liuyal/Akriveia/Documents/Design_Documents/02_UI_Appendix/README.md

# Document_UI_Appendix

Project to keep track of tasks and issues relating to User Interface and Appearance document

See grading rubric for document details

Due July 07, 2019

## To generate Reference

pdflatex 10_0_Appendix_UI_Design.tex

biber 10_0_Appendix_UI_Design

pdflatex 10_0_Appendix_UI_Design.tex
