liuyal/Akriveia/Documents/Design_Documents/06_Prototype_Refinement/03_engineering_standards.tex

\setcounter{section}{2}
\section{Engineering Standards}
\bigskip

The Akriveia Beacon will be designed and optimized to meet various engineering standards published by the IEEE, the IEC, the ISO, and the CSA Group to ensure performance and safety of the final product. The system contains electronics devices, software stack, and communication devices with different protocols, which must follow the specific safety standards. Ranging and data communication on the physical, data link, and network layer with the use of 2.4GHz WiFi and the ultra-wideband spectrum, operating in unlicensed frequency bands, and wireless standards that apply to the operation band must be followed. Furthermore, the Akriveia Beacon system is designed to operate during disaster situations, material, safety, and design must follow the structural and durability standards for disaster equipment. 

\bigskip
\bgroup
\def\arraystretch{1.3}
\begin{table}[H]
\centering
\begin{tabular}{ |p{2.5cm} p{11.5cm} | }
\hline
\multicolumn{1}{|r|}{IEEE 1625} & IEEE Standard for Rechargeable Batteries for Multi-Cell Mobile Computing Devices \\ 
\hline
\multicolumn{1}{|r|}{CSA-C22.2 NO.61508-1:17} & Functional safety of electrical/electronic/programmable electronic safety-related systems - Part 1: General requirements \\ 
\hline
\multicolumn{1}{|r|}{CSA-C22.2 NO.0.23-15} & General requirements for battery-powered appliances \\  
\hline
\multicolumn{1}{|r|}{CAN/CSA-C22.2 NO.0-10} & General requirements - Canadian electrical code, part II \\ 
\hline
\multicolumn{1}{|r|}{IEEE P360} & Standard for Wearable Consumer Electronic Devices - Overview and Architecture \\  
\hline
\multicolumn{1}{|r|}{IEEE 802.15.4q-2016} & IEEE Standard for Low-Rate Wireless Networks --Amendment 2: Ultra-Low Power Physical Layer\\ 
\hline
\multicolumn{1}{|r|}{ISO/IEC 26907:2009} & Information technology -- Telecommunications and information exchange between systems -- High-rate ultra-wideband PHY and MAC standard\\  
\hline
\multicolumn{1}{|r|}{ISO/IEC 24730-62:2013} & Information technology -- Real time locating systems (RTLS) -- Part 62: High rate pulse repetition frequency Ultra Wide Band (UWB) air interface\\  
\hline
\multicolumn{1}{|r|}{IEEE P802.15.4z} & Standard for Low-Rate Wireless Networks Amendment: Enhanced High Rate Pulse (HRP) and Low Rate Pulse (LRP) Ultra Wide-Band (UWB) Physical Layers (PHYs) and Associated Ranging Techniques\\  
\hline
\multicolumn{1}{|r|}{IEEE 12207-2017} & ISO/IEC/IEEE International Standard - Systems and software engineering -- Software life cycle processes \\
\hline 
\multicolumn{1}{|r|}{IEEE P2510} & Standard for Establishing Quality of Data Sensor Parameters in the Internet of Things Environment \\ 
\hline
\multicolumn{1}{|r|}{ISO 2382-9:1984} & Data processing -- Vocabulary -- Part 9: Data communication \\
\hline 
\multicolumn{1}{|r|}{IEEE 1221-1993} & IEEE Guide for Fire Hazard Assessment of Electrical Insulating Materials in Electrical Power Systems \\ 
\hline
\multicolumn{1}{|r|}{IEEE 848-2015} & IEEE Standard Procedure for the Determination of the Ampacity Derating Factor for Fire-Protected Cable Systems\\ 
\hline
\end{tabular}
\caption{Table of Standards}
\end{table}
