liuyal/Akriveia/Documents/Design_Documents/08_Break_Even_Analysis/05_appendix.tex

\setcounter{section}{4}
\section{Appendix A - Bill of Material}

\begin{figure}[H]
\centering
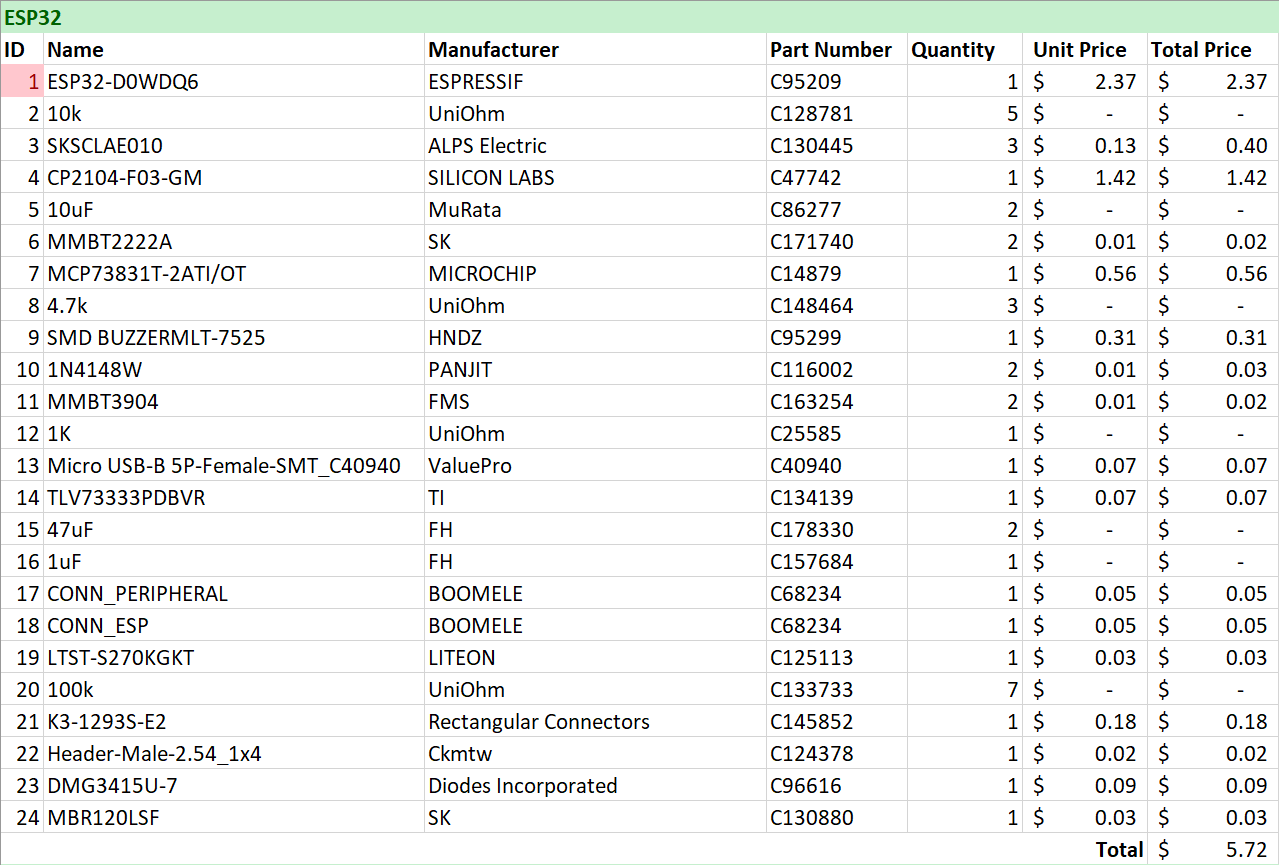
[picture p5: Documents/Design_Documents/08_Break_Even_Analysis/images/esp32.png]
    
    \caption{ESP32 Bill of Material}
\end{figure}

\medskip
\begin{figure}[H]
\centering
    
    \caption{DWM1000 UWB Module Bill of Material}
\end{figure}

\medskip
\begin{figure}[H]
\centering
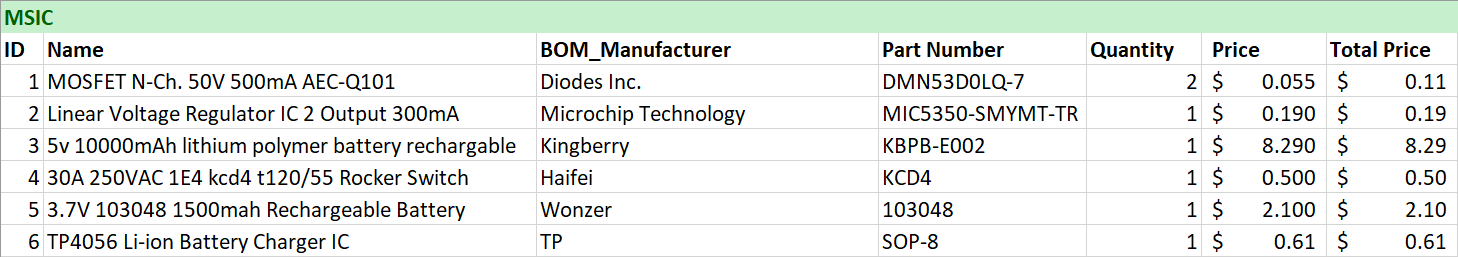
[picture p6: Documents/Design_Documents/08_Break_Even_Analysis/images/msic.PNG]
    
    \caption{Miscellaneous Component  Bill of Material}
\end{figure}

\begin{figure}[H]
\centering
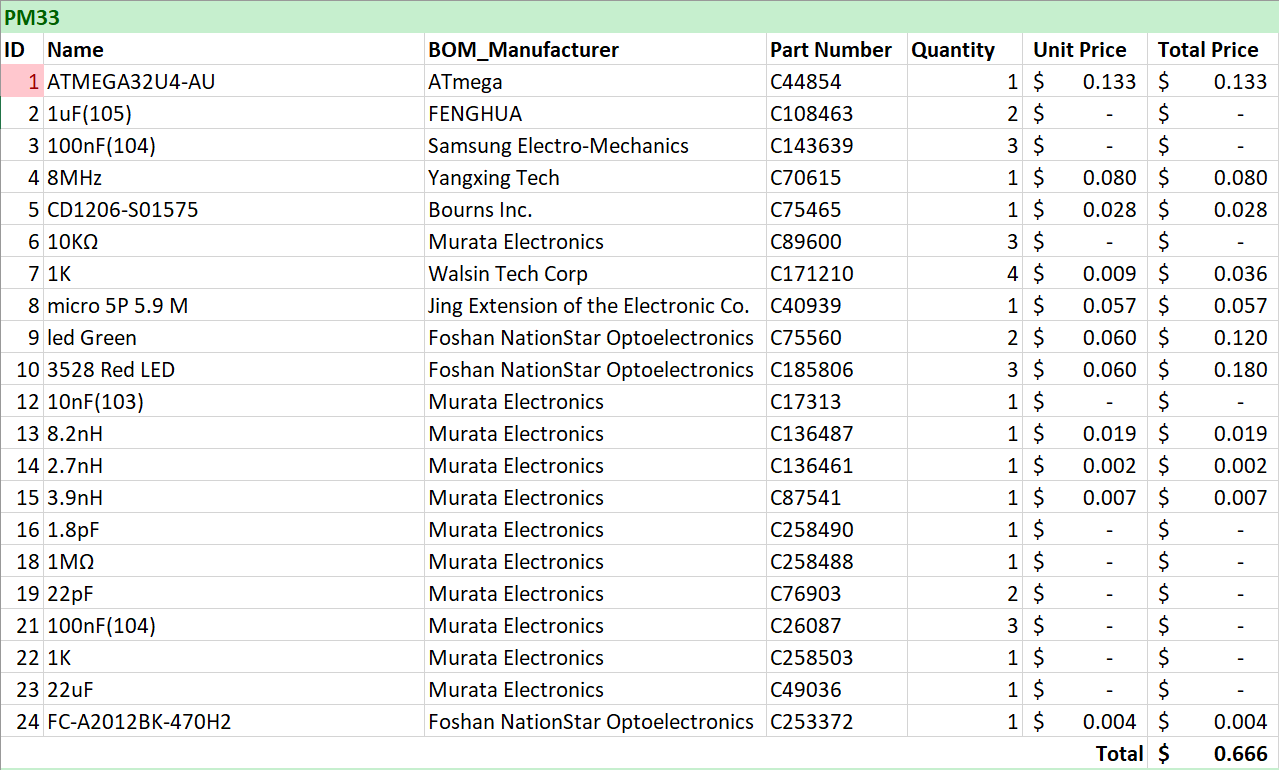
[picture p7: Documents/Design_Documents/08_Break_Even_Analysis/images/pm33.png]
    
    \caption{Arduino Pro Mini 3.3V 8MHz Bill of Material}
\end{figure}

\pagebreak
\setcounter{section}{5}
\section{Appendix B - Injection Molding Quotes}

\medskip
\bgroup
\def\arraystretch{1.75}
\begin{table}[H]
\centering
\begin{tabular}{ | m{5cm} | m{10cm} |}
\hline
\multicolumn{2}{|l|}{\textbf{3DHUBS - ABS}}  \\ 
\hline
\multicolumn{1}{|r|}{\textbf{Material}} & ABS \\
\hline
\multicolumn{1}{|r|}{\textbf{Beacon Tooling Cost [CAD]}} & \$6360.94 \\
\hline
\multicolumn{1}{|r|}{\textbf{Tag Tooling Cost [CAD]}} & \$4718.34 \\
\hline
\multicolumn{1}{|r|}{\textbf{Beacon Unit Price [CAD]}} & \$1.80 \\
\hline
\multicolumn{1}{|r|}{\textbf{Tag Unit Price [CAD]}} & \$0.73 \\
\hline
\end{tabular}
\caption{Injection Molding Quote - 3DHUBS (ABS)}
\end{table}

\bgroup
\def\arraystretch{1.75}
\begin{table}[H]
\centering
\begin{tabular}{ | m{5cm} | m{10cm} |}
\hline
\multicolumn{2}{|l|}{\textbf{3DHUBS - PEEK}}  \\ 
\hline
\multicolumn{1}{|r|}{\textbf{Material}} & PEEK \\
\hline
\multicolumn{1}{|r|}{\textbf{Beacon Tooling Cost [CAD]}} & \$10474.79 \\
\hline
\multicolumn{1}{|r|}{\textbf{Tag Tooling Cost [CAD]}} & \$5181.55 \\
\hline
\multicolumn{1}{|r|}{\textbf{Beacon Unit Price [CAD]}} & \$2.30 \\
\hline
\multicolumn{1}{|r|}{\textbf{Tag Unit Price [CAD]}} & \$1.25 \\
\hline
\end{tabular}
\caption{Injection Molding Quote - 3DHUBS (PEEK)}
\end{table}

\bgroup
\def\arraystretch{1.75}
\begin{table}[H]
\centering
\begin{tabular}{ | m{5cm} | m{10cm} |}
\hline
\multicolumn{2}{|l|}{\textbf{ICOMolds}}  \\ 
\hline
\multicolumn{1}{|r|}{\textbf{Material}} & ABS Chimei Pa-757, Natural \\
\hline
\multicolumn{1}{|r|}{\textbf{Beacon Tooling Cost [CAD]}} & \$6829.00 \\
\hline
\multicolumn{1}{|r|}{\textbf{Tag Tooling Cost [CAD]}} & \$4357.00 \\
\hline
\multicolumn{1}{|r|}{\textbf{Beacon Unit Price [CAD]}} & \$1.97 \\
\hline
\multicolumn{1}{|r|}{\textbf{Tag Unit Price [CAD]}} & \$0.59 \\
\hline
\end{tabular}
\caption{Injection Molding Quote - ICOMold (ABS)}
\end{table}

\pagebreak
\setcounter{section}{6}
\section{Appendix C - PCB Fabrication and Assembly Quotes}

\medskip
\bgroup
\def\arraystretch{1.5}
\begin{table}[H]
\centering
\begin{tabular}{ | m{6cm} | m{12cm} |}
\hline
\multicolumn{1}{|r|}{\textbf{Board Quantity}} & 1000 \\
\hline
\multicolumn{1}{|r|}{\textbf{Board Size}} & $5\times12$ cm \\
\hline
\multicolumn{1}{|r|}{\textbf{Thickness}} & 0.062 inch \\
\hline
\multicolumn{1}{|r|}{\textbf{Layers}} & 2 \\
\hline
\multicolumn{1}{|r|}{\textbf{Copper weight}} & 1.0 oz \\
\hline
\multicolumn{1}{|r|}{\textbf{Routing}} & Individual \\
\hline
\multicolumn{1}{|r|}{\textbf{Total Price [CAD]}} & \$1429.72 \\
\hline
\multicolumn{1}{|r|}{\textbf{Unit Price [CAD]}} & \$1.43 \\
\hline
\end{tabular}
\caption{Beacon PCB Fabrication Quote}
\end{table}

\bgroup
\def\arraystretch{1.5}
\begin{table}[H]
\centering
\begin{tabular}{ | m{6cm} | m{12cm} |}
\hline
\multicolumn{1}{|r|}{\textbf{Board Quantity}} & 1000 \\
\hline
\multicolumn{1}{|r|}{\textbf{Board Size}} & $4\times6$ cm \\
\hline
\multicolumn{1}{|r|}{\textbf{Thickness}} & 0.062 inch \\
\hline
\multicolumn{1}{|r|}{\textbf{Layers}} & 2 \\
\hline
\multicolumn{1}{|r|}{\textbf{Copper weight}} & 1.0 oz \\
\hline
\multicolumn{1}{|r|}{\textbf{Routing}} & Individual \\
\hline
\multicolumn{1}{|r|}{\textbf{Total Price [CAD]}} & \$768.39 \\
\hline
\multicolumn{1}{|r|}{\textbf{Unit Price [CAD]}} & \$0.77 \\
\hline
\end{tabular}
\caption{ID Tag PCB Fabrication Quote}
\end{table}

\bgroup
\def\arraystretch{1.5}
\begin{table}[H]
\centering
\begin{tabular}{ | m{6cm} | m{12cm} |}
\hline
\multicolumn{1}{|r|}{\textbf{Board Quantity}} & 1000 \\
\hline
\multicolumn{1}{|r|}{\textbf{BOM Lines}} & 51 \\
\hline
\multicolumn{1}{|r|}{\textbf{N-sided SMT}} & Single Side \\
\hline
\multicolumn{1}{|r|}{\textbf{Processing}} & Leaded \\
\hline
\multicolumn{1}{|r|}{\textbf{SMT Pads}} & 100 \\
\hline
\multicolumn{1}{|r|}{\textbf{Tru-Holes}} & 0 \\
\hline
\multicolumn{1}{|r|}{\textbf{Fine Pitch Parts}} & 10 \\
\hline
\multicolumn{1}{|r|}{\textbf{BGA/QFN Parts}} & 0 \\
\hline
\multicolumn{1}{|r|}{\textbf{Total Price [CAD]}} & \$3888.30 \\
\hline
\end{tabular}
\caption{Beacon PCB Assembly Quote}
\end{table}

\bgroup
\def\arraystretch{1.5}
\begin{table}[H]
\centering
\begin{tabular}{ | m{6cm} | m{12cm} |}
\hline
\multicolumn{1}{|r|}{\textbf{Board Quantity}} & 1000 \\
\hline
\multicolumn{1}{|r|}{\textbf{BOM Lines}} & 27 \\
\hline
\multicolumn{1}{|r|}{\textbf{N-sided SMT}} & Single Side \\
\hline
\multicolumn{1}{|r|}{\textbf{Processing}} & Leaded \\
\hline
\multicolumn{1}{|r|}{\textbf{SMT Pads}} & 60 \\
\hline
\multicolumn{1}{|r|}{\textbf{Tru-Holes}} & 0 \\
\hline
\multicolumn{1}{|r|}{\textbf{Fine Pitch Parts}} & 5 \\
\hline
\multicolumn{1}{|r|}{\textbf{BGA/QFN Parts}} & 0 \\
\hline
\multicolumn{1}{|r|}{\textbf{Total Price [CAD]}} & \$2693.32 \\
\hline
\end{tabular}
\caption{ID Tag PCB Assembly Quote}
\end{table}
