liuyal/Akriveia/Documents/Design_Documents/03_Project_Proposal/00_Glossary.tex

\newglossaryentry{BLE}{name=BLE, description={Bluetooth Low Energy}}
\newglossaryentry{CAD}{name=CAD, description={Computer Aided Design}}
\newglossaryentry{CSA}{name=CSA, description={Canadian Standards Association is a standards development organization}}
\newglossaryentry{DHCP}{name=DHCP, description={Dynamic Host Configuration Protocol}}
\newglossaryentry{DC}{name=DC, description={Direct current voltage}}
\newglossaryentry{DPU}{name=DPU, description={Data Processing Unit}}
\newglossaryentry{ESSS}{name=ESSS, description={SFU Engineering Science Student Society}}
\newglossaryentry{ETSI}{name=ETSI, description={European Telecommunications Standards Institute}}
\newglossaryentry{FCC}{name=FCC, description={Federal Communications Commission}}
\newglossaryentry{FM}{name=FM, description={Frequency modulation}}
\newglossaryentry{GIL}{name=GIL, description={Global Indoor Location }}
\newglossaryentry{GPS}{name=GPS, description={Global Position Systems }}
\newglossaryentry{GPIO}{name=GPIO, description={General Purpose Input Output}}
\newglossaryentry{GUI}{name=GUI, description={Graphical User Interface}}
\newglossaryentry{HTTP}{name=HTTP, description={HyperText Transfer Protocol}}
\newglossaryentry{IC}{name=IC, description={Integrated Circuit}}
\newglossaryentry{ID}{name=ID, description={Identification}}
\newglossaryentry{IEC}{name=IEC, description={International Electrotechnical Commission}}
\newglossaryentry{IEEE}{name=IEEE, description={Institute of Electrical and Electronics Engineers}}
\newglossaryentry{ISO}{name=ISO, description={the International Organization for Standardization. }}
\newglossaryentry{MAC}{name=MAC, description={Media Access Control}}
\newglossaryentry{MCU}{name=MCU, description={Micro-controller unit}}
\newglossaryentry{OS}{name=OS, description={operating system}}
\newglossaryentry{PCB}{name=PCB, description={Printed circuit board}}
\newglossaryentry{PoC}{name=PoC, description={Proof of concept is the sample product assembled to explore project feasibility}}
\newglossaryentry{PLA}{name=PLA, description={Polylactic acid or polylactide}}
\newglossaryentry{RF}{name=RF, description={Radio Frequency}}
\newglossaryentry{RSSI}{name=RSSI, description={Received Signal Strength Indicator}}
\newglossaryentry{SAR}{name=SAR, description={Search and Rescue}}
\newglossaryentry{SBC}{name=SBC, description={Single board computer}}
\newglossaryentry{ToF}{name=ToF, description={Time-of-Flight is a method for measuring the distance between a sensor and an object}}
\newglossaryentry{UDP}{name=UDP, description={User Datagram Protocol}}
\newglossaryentry{UI}{name=UI, description={User Interface}}
\newglossaryentry{UWB}{name=UWB, description={Ultra wide band}}
