liuyal/Akriveia/Documents/Design_Documents/03_Project_Proposal/04_Budget_and_funding.tex

\setcounter{section}{3}
\section{Budget \& Funding}
\bigskip

\subsection{Budget Estimation}
\medskip

For the Alpha phase of the project, the team plans to test a few transceivers from different manufacturers in order to find the most suitable transceivers for the final prototype. For the microcontroller unit, the ESP32 development board will be used to help test these transceivers with the system. In the following tables, expense that has already been put into the project, and the estimated costs for the remainder of the project are outlined. The expenses are divided into two tables, one containing the expenses already incurred up to the time of this writing, and the other contains a forecast of the expected costs to come.

\begin{table}[H]
\centering
\def\arraystretch{1.3}
\begin{tabular}{ | m{4.75cm} | m{5cm} | m{2.5cm} | m{3cm} |}
\hline
\textbf{Item} & \textbf{Purpose} & \textbf{Cost [CAD]} & \textbf{Project Phase}  \\
\hline
12 of: nrf24l01 2.4GHz RF Transceiver modules & Initial feasibility testing & \$17.99 & PoC \\
\hline
5 of: ESP32 development boards & PoC and prototype testing and development & \$82.15 & PoC, Prototype, Final \\
\hline
1 of: Raspberry Pi 3 B+ starter kit & Will act as the demo central data processing unit for prototype and final product & \$88.47 & Prototype, Final \\
\hline
5 of: Decawave DWM1000 UWB modules & RF transceiver for Prototype and final product & \$230.67 & Prototype, Final \\
\hline
12 of: DWM1000 PCB breakout boards & Allow for DWM1000 modules to be used with ESP32 in prototype and final product & \$18.29 & Prototype, Final \\
\hline
Raspberry Pi 3 B+ & Will act as the central data processing unit for prototype and final product & \$88.47 & Prototype, Final \\
\hline
SMD components and solder paste & Assembling the DWM1000 boards & \$63.45 & Prototype, Final\\
\hline
Arduino boards and components & Testing and development for Data processing unit and serial communication & \$107.87 & PoC \\
\hline
\end{tabular}
\caption{Expenses to Date}
\end{table}

\begin{table}[H]
\centering
\def\arraystretch{1.3}
\begin{tabular}{ | m{3.5cm} | m{6.25cm} | m{2.5cm} | m{3cm} |}
\hline
\textbf{Item} & \textbf{Purpose} & \textbf{Cost [CAD]} & \textbf{Project Phase}  \\
\hline
3D printing & Casing for beacons and ID tags & \$50.00 & Final  \\
\hline
Batteries & Power supplies for system components & \$30.00 & Prototype, Final \\
\hline
Circuit components & Beacon and ID tag components & \$20.00 & Final \\
\hline
PCB printing & Beacon and ID tag components & \$20.00 & Final \\
\hline
\end{tabular}
\caption{Forecast of Future Expenses}
\end{table}

\pagebreak
\subsection{Product Pricing}
\medskip
The Akriveia Beacon as a Final manufactured product will offer its customers 10 ID Tags with minimal 3 Beacons which additional beacons and ID tags available for purchase at unit and bulk price. The final system will have an estimated system component cost of around \$575. Along with an estimated labor and overhead cost the required final product sale price is estimated to be around \$930 with a 20\% return on sales (not including taxes).

\begin{table}[H]
\centering
\def\arraystretch{1.5}
\begin{tabular}{ | m{5cm} | m{5cm} | m{5cm} |}
\hline
\textbf{System Component} & \textbf{Part} & \textbf{Cost [CAD]}  \\
\hline
\multirow{5}{*}{ID TAG} & DWM1000 Module & \$30.00 \\  \cline{2-3}
  					    & Casing & \$2.00 \\  \cline{2-3}
  					    & Integrated ESP32 PCB & \$2.00 \\  \cline{2-3}
  					    & 2200 mAH Lithium Battery & \$5.00 \\  \cline{2-3}
  					    & PCB Components & \$2.00 \\ 
\hline
\multicolumn{2}{|r|}{\textbf{Total}:} & \$44.00 \\
\hline
\multirow{5}{*}{Beacon} & DWM1000 Module & \$30.00 \\  \cline{2-3}
  					    & Casing & \$3.00 \\  \cline{2-3}
  					    & Integrated ESP32 PCB & \$2.00 \\  \cline{2-3}
  					    & 2200 mAH Lithium Battery & \$5.00 \\  \cline{2-3}
  					    & PCB Components & \$2.00 \\ 
\hline
\multicolumn{2}{|r|}{\textbf{Total}:} & \$45.00 \\
\hline
Software & Deployment Cost & \$50.00 \\
\hline
\end{tabular}
\caption{Final Product Pricing Estimation}
\end{table}

\bigskip

\begin{table}[H]
\centering
\def\arraystretch{1.5}
\begin{tabular}{ m{10cm} m{2cm} }

Cost of materials &  \\
 + 10 $\times$ ID Tag & \$440.00  \\
 + 3 $\times$ Beacon & \$135.00  \\
 + Cost of labor &  \$100.00  \\
 + Overhead &  \$100.00  \\
\noalign{\global\arrayrulewidth=0.25mm} \arrayrulecolor{gray} \hline
 = Total cost &  \$775.00  \\
 + Desired profit (20\% on sales) &  \$155.00  \\
\noalign{\global\arrayrulewidth=0.25mm} \arrayrulecolor{gray} \hline
 = Required sale price &  \$930.00  \\
\end{tabular}

\end{table}

\pagebreak
\subsection{Prospective Funding Sources}
\medskip
\subsubsection{Engineering Science Student Endowment Fund}
\medskip
We hope to obtain funding from the SFU Engineering Science Student Society (\Gls{ESSS}) by means of the endowment fund set up by the society (ESSEF). We know that they have been very generous with Capstone groups in the past, so as soon as we are able to, we will be applying for funding from the ESSEF. We acknowledge that some parts purchased with the funding from this source may have to be donated to the ESSS for their parts library.

\subsubsection{Wighton Development Fund}
\medskip
The Wighton Development Fund is in place to support SFU student-led projects, awarded by Dr. Andrew Rawicz \cite{R4-1}, and a comitee consisting of other facuty or staff. We hope to obtain funding that will cover the remainder of the expenses endured during this project. As with the ESSEF, an application will be submitted by this group as soon as possible.

\subsubsection{Team Contributions}
\medskip
If the above funding sources are insufficient to cover the costs of this project, each team member will agree to personal contributions up to \$50 each to complete funding for the project and cover any remaining expenses.
