liuyal/Akriveia/Documents/Design_Documents/02_Design_Specification/00_Glossary.tex

\newglossaryentry{ARM64}{name=ARM64, description={Advanced RISC Machine, A family of RISC based processors}}
\newglossaryentry{Actix Web}{name=Actix Web, description={A webserver library built ontop of Actix}}
\newglossaryentry{Actix}{name=Actix, description={An implementation of the Actor Model in Rust}}
\newglossaryentry{Actor Model}{name=Actor Model, description={A concurrency managment paradigm that uses message passing between objects rather than locks or atomics}}
\newglossaryentry{Actor}{name=Actor, description={A class that contains message handling callbacks}}
\newglossaryentry{Aptitude}{name=Aptitude, description={A debian package manager that automatically manages updates and installation of software and dependencies}}
\newglossaryentry{Arbiter}{name=Arbitor, description={A thread pool, where each thread is an event loop}}
\newglossaryentry{Babel}{name=Babel, description={A scripting language similar to Javascript with the ability to directly construct HTML snippets}}
\newglossaryentry{BLE}{name=BLE, description={Bluetooth Low Energy}}
\newglossaryentry{Borrow Checker}{name=Borrow Checker, description={A component of the Rust compiler to prevent data races by enforcing data ownership rules}}
\newglossaryentry{CAD}{name=CAD, description={Computer Aided Design}}
\newglossaryentry{CSA}{name=CSA, description={Canadian Standards Association is a standards development organization}}
\newglossaryentry{DHCP}{name=DHCP, description={Dynamic Host Configuration Protocol}}
\newglossaryentry{DC}{name=DC, description={Direct current voltage}}
\newglossaryentry{DPU}{name=DPU, description={Data Processing Unit}}
\newglossaryentry{Debian}{name=Debian, description={A Linux based operating system}}
\newglossaryentry{ETSI}{name=ETSI, description={European Telecommunications Standards Institute}}
\newglossaryentry{FCC}{name=FCC, description={Federal Communications Commission}}
\newglossaryentry{FM}{name=FM, description={Frequency modulation}}
\newglossaryentry{Garbage Collector}{name=Garbage Collector, description={A runtime component of some programming languages that detects and cleans up unused memory.}}
\newglossaryentry{GPIO}{name=GPIO, description={General Purpose Input Output}}
\newglossaryentry{GUI}{name=GUI, description={Graphical User Interface}}
\newglossaryentry{Hostapd}{name=Hostapd, description={Host access point daemon}}
\newglossaryentry{HTTP}{name=HTTP, description={HyperText Transfer Protocol}}
\newglossaryentry{IC}{name=IC, description={Integrated Circuit}}
\newglossaryentry{ID}{name=ID, description={Identification}}
\newglossaryentry{IEC}{name=IEC, description={International Electrotechnical Commission}}
\newglossaryentry{IEEE}{name=IEEE, description={Institute of Electrical and Electronics Engineers}}
\newglossaryentry{ISO}{name=ISO, description={the International Organization for Standardization. }}
\newglossaryentry{JQuery}{name=JQuery, description={A Javascript library designed to manipulate HTML}}
\newglossaryentry{MAC}{name=MAC, description={Media Access Control}}
\newglossaryentry{MCU}{name=MCU, description={Micro-controller unit}}
\newglossaryentry{MPSC}{name=MPSC, description={Multiple Producer Single Consumer Queue}}
\newglossaryentry{MVC}{name=MVC, description={Model View Controller, a method of orgnanization for GUI implementations}}
\newglossaryentry{OS}{name=OS, description={operating system}}
\newglossaryentry{OSI}{name=OSI Model, description={Open Systems Interconnection model}}
\newglossaryentry{PCB}{name=PCB, description={Printed circuit board}}
\newglossaryentry{PoC}{name=PoC, description={Proof of concept is the sample product assembled to explore project feasibility}}
\newglossaryentry{PLA}{name=PLA, description={Polylactic acid or polylactide}}
\newglossaryentry{React}{name=React, description={A Javascript framework to dynamically generate HTML}}
\newglossaryentry{RF}{name=RF, description={Radio Frequency}}
\newglossaryentry{Rolling Releases}{name=Rolling Release, description={Frequent updates of software, without versions}}
\newglossaryentry{RSSI}{name=RSSI, description={Received Signal Strength Indicator}}
\newglossaryentry{Rust}{name=Rust, description={A systems language that focuses on reliability and performance}}
\newglossaryentry{SBC}{name=SBC, description={Single board computer}}
\newglossaryentry{Server Side Rendering}{name=Server Side Rendering, description={Creating HTML files on the server, which can then be directly consumed by the browser without modification to render a GUI}}
\newglossaryentry{ToF}{name=ToF, description={Time-of-Flight is a method for measuring the distance between a sensor and an object}}
\newglossaryentry{UDP}{name=UDP, description={User Datagram Protocol}}
\newglossaryentry{UI}{name=UI, description={User Interface}}
\newglossaryentry{UWB}{name=UWB, description={Ultra wide band}}
\newglossaryentry{x86-64}{name=x86-64, description={Intel designed CISC family of processors}}
