liuyal/Akriveia/Documents/Design_Documents/02_Design_Specification/01_Introduction.tex

\setcounter{section}{0}
\section{Introduction}
\bigskip

\subsection{Background}
Over the past couple of decades, urban centers around the world have faced substantial population growth. As a result, the number of large and complex structures in dense urban areas around the world is rapidly increasing. In Canada alone there are approximating 500,000 commercial buildings \cite{R1}. A large population combined with massively complex buildings in relatively dense areas leads to higher risk for damage and casualties in the event of a disaster. Due to increased urbanization and complexity of urban structures, search and rescue operations in indoor urban environments face various complications and uncertainties. According to Statistics Canada, an average of 135 fire related deaths occur with commercial structures each year from 2010 to 2014 \cite{R2}.

\bigskip
In current practices, first responders know little about the severity of the disaster until arriving on scene. Once responders are on scene, emergency management have to quickly evaluate the situation and take appropriate actions \cite{R3}. Assessments of the structure are conducted with readily available blueprints of buildings along with limited information of last known location of possible trapped victims, usually derived from witness reports. Situational data are created dynamically during this process and the actual rescue process heavily depends on the situational awareness of the first line of emergency response operators \cite{R4}.

\bigskip
An important issue that must be considered is how emergency first responders should be dispatched inside the building in the event of a disaster in order to minimize search and rescue time as well as to ensure their safety. In order to pinpoint locations of trapped victims quickly and accurately it is critical to have precise location data. Proper emergency planning and organization takes a substantial amount of time, and having additional quick and accurate information on the locations of trapped, incapacitated or immobile personnel would greatly improve first responders situational awareness; which would improve safety for first responders and possibly increases the victims chances of rescue and survival.

\bigskip
As such, the need for a distinct indoor positioning rescue system is crucial in getting fast and reliable information that allows first responders to be dispatched within the builds in the most optimal and efficient manner. The Akriveia Beacon by TRIWAVE SYSTEMS focuses on improving the locating and rescue process of personnel trapped in buildings during or after small scale disasters such as fires and low magnitude earthquakes. This is done through a system of Ultra Wide-Band (\Gls{UWB}) Beacons and \Gls{ID} tags, and data processing unit for accurate, near real-time pin point location of trapped personnel.

\bigskip
Ultra-Wideband radio modules are small radio transceivers using radio spectrum within the ultra-wide band to communicate with one another. Each ID tag uses a UWB transceiver module to communicate with the beacon system configured with similar UWB transceivers. Given the time between sending and receiving transmission data, the distance can be estimated via \Gls{RSSI} or time of flight. The Beacons will then forward these distance estimations to a data processing unit using a closed WiFi network, where it can use trilateration methods to calculate the near real time location of each individual ID tag. The system design allows for multiple ID tags as well as more than three anchor beacons to provide more accuracy through redundancy, making it modular, extendible and reliable.

\break
\subsection{Scope}
\medskip
The Akriveia Beacon system is developed through three different phases of development as shown in Figure \ref{dev}. The three different phases includes: the proof-of-concept phase, prototype phase, and final product phase. A high-level design of the system hardware and software is presented in this document to demonstrate the overall system architecture and functionality of the Akriveia beacon product. The design section of this document is divided into four main sections, overall system design, hardware design, electrical design, and software design. These design specification will indicate the components, implementations, requirements, and constraints that must be met and satisfied within the project time frame. 

\medskip
\begin{figure}[H]
\centering
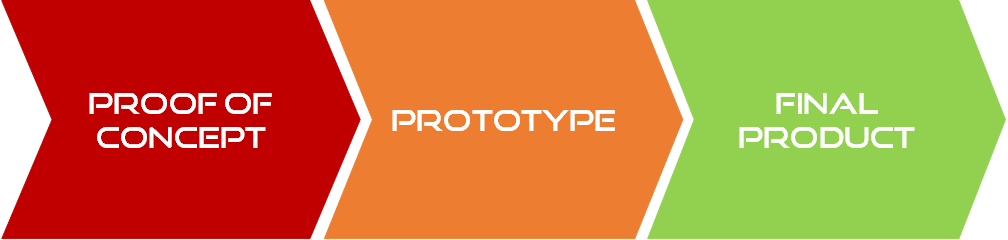
[picture p15: Documents/Design_Documents/02_Design_Specification/images/dev-path.png]
    
    \caption{Development Cycle}
    \label{dev}
\end{figure}

\subsection{Intended Audience}
\medskip
This document is presented by engineers at TRIWAVE SYSTEMS as a guide for the design and system overview of the Akriveia Beacon product. The intended audience of this document includes but not limited to, potential clients and/or partners, the supervising professors Dr. Craig Scratchley and Dr. Andrew Rawicz, associated teaching assistants and fellow TRIWAVE SYSTEMS members. The hardware and software engineers of the project can reference this document during the various stages of development and testing stages of the project for clarification. Near the completion of the prototype development phase the product will be tested against the cases specified in the test plan. Engineers responsible for performing quality assurance can refer to the Appendix of this document to ensure all safety concerns have been addressed and that the product fulfils all requirements and meets all expectations for proper usage. 

\break
\subsection{Design  Classification}
For consistency purposes, the following design classification code convention is used to describe and organize design requirements listed throughout this document. 
\medskip
\begin{center}
	\textbf{[ DES.SE.\# - X ]} 
\end{center}

\bgroup
\def\arraystretch{1.5}
\begin{table}[H]
\centering
\begin{tabular}{ | m{1cm} | m{13cm}| } 
\hline
\rowcolor{lightgray} \textbf{Code} & \textbf{Definition} \\ 
\hline
 \textbf{DES} & Design abbreviation. \\ 
\hline
 \textbf{SE} & Design Domain Abbreviation Code correspond with each Design requirements. (see Table 2)\\   
\hline
 \textbf{\#} & Design number ID \\ 
\hline
 \textbf{X} & Development Stage Encoding (see Table 3)\\ 
\hline
\end{tabular}
\caption{Design Requirement Encoding}
\end{table}

\bgroup
\def\arraystretch{1.5}
\begin{table}[H]
\centering
\begin{tabular}{ | m{7cm} | m{7cm}| } 
\hline
\rowcolor{lightgray} \textbf{Requirement Domain} & \textbf{Abbreviation Code} \\ 
\hline
 System & SY\\ 
\hline
 Hardware & HW\\ 
\hline
 Electrical & EC\\  
\hline
 Software & SW\\ 
\hline
\end{tabular}
\caption{Design  Domain Abbreviation Code}
\end{table}

\bgroup
\def\arraystretch{1.5}
\begin{table}[H]
\centering
\begin{tabular}{ | m{7cm} | m{7cm}| }
\hline
\rowcolor{lightgray} \textbf{Development Stage} & \textbf{Encoding} \\
\hline
Proof of Concept & C\\
\hline
Prototype & P\\
\hline
Final Product & F\\
\hline
\end{tabular}
\caption{Development Stage Encoding}
\end{table}
