liuyal/Akriveia/Documents/Design_Documents/02_Design_Specification/06_Software_Design.tex

\setcounter{section}{5}
\section{Software Design}
\bigskip

% NOTE: future work would be to build a system to flash new beacons with firmware for the credentials to communicate with the system.
% NOTE: assume beacons have line of sight to eachother. this allows us to make the callibration phase easier by manually measuring the distance between beacons rather than creating a callibration script.

% discuss the system at a high level, but leave details to subsections
% breifly reintroduce important topics that the user will need to be reminded of
\subsection{Software Overview}
\medskip
The Akriveia system is comprised of 3 different devices, namely: the data processor, beacons, and ID tags; this device diversity plays a large role in the software choice for the beacons and ID tags.
The Akriveia data processor is the primary access point for Administrators and First Responders, of whom will be presented a Graphical User Interface served by the data processor in addition to handling commands from the client.
The software on the Data Processing Unit(DPU) is written entirely in Rust, including the static client side webpage.
The requirements for each device are different, however the ID tags and beacons are able to share a similar environment; as such the Akriveia Beacon System will require two different software environments, one for the DPU and one for the ID tags and beacons.

\medskip
% language choices, formatting, standards, libraries
\subsection{Software Stack}
\medskip
Akrivia Beacon is composed of two primary languages, the DPU is implemented entirely in Rust while the beacons and ID tags use the Arduino language.

\medskip
\subsubsection{Software Environments}
\medskip
The data processing unit requires an operating system (\Gls{OS}) to perform CPU scheduling for the multi-threaded application, WiFi drivers, and a proper file system to handle a database.
As such, Linux or more specifically the \Gls{Debian} distribution of Linux was chosen as the DPU operating system.

\bigskip
Debian is widely praised for its stability, which makes it ideal for a data processing as the Akriveia Beacon System is designed to operate under emergency situations. Debian brings in the \Gls{Aptitude} package manager for dependency management, which allows for quick installation of required driver updates, operating system updates, and any additional packages required.
Debian's Aptitude has the advantage compared to other package managers because it removes the need to worry about dependencies, manual installation, and even installation of sub dependencies.
As Debian is a Linux distribution, it has widespread hardware adoption across many different hardware architectures - primarily \Gls{x86-64} and \Gls{ARM64} - giving Akriveia the flexibility to run on the most basic single board computers.

\bigskip
Linux has many different flavors, such as the Arch Linux which uses a different package management paradigm called \Gls{Rolling Releases}, favouring earlier adoption of newer packages to more quickly introduce features at the cost of stability.
\Gls{Rolling Releases} are unsuitable for production servers due to their instability.
Another alternative to Debian is Windows, however Windows suffers from high power usage, poor package management, and heavy reliance on proprietary software, whereas Linux is open source, free of cost, and has a more inclusive licence.

\pagebreak
\subsubsection{Software Languages}
\medskip
The DPU is written in \Gls{Rust}.
Rust is a relatively new language as it was created in 2006 \cite{rust_graydon_interview} and its first stable version was released in 2015 \cite{rust_releases}.
Taking inspiration from C++ and Haskell in its design, Rust is a systems language designed for stability and robustness. Rust eliminates entire classes of errors using the borrow checking system, a feature unique to this language.
The borrow checking system defines a strict set of rules to follow, and fails to compile if these rules are broken - even if the application is otherwise logically and syntactically correct.
As a systems language, Rust is compiled to binary rather than executed as a script through an interpreter, however, this does not stop it from being a higher order language.
Rust does not expect developers to manage allocation and deallocation of memory directly, nor does it have a runtime \Gls{Garbage Collector}; rust relies on the \Gls{Borrow Checker} and lifetime system at compile time to statically analyze memory usage and automatically places the allocations and deallocations as needed. The benefits of the \Gls{Borrow Checker} do come at a cost, resulting in slow compile time and high learning curve. The features of Rust will be used throughout the DPU, as the backend webserver, the data processor, as well as the on the browser in the form of webassembly. 

\bigskip
The beacons and ID tags are written in Arduino language.
The Arduino language is merely a set of C/C++ functions and is specifically designed for embedded programming, allowing use of higher level features when desired while also giving the developer absolute control over how memory is managed.
The Arduino environment performs a few transformations to the Arduino sketch before passing it to the avr-gcc compiler.
On Arduinos, memory is very limited so control is key to fit the program within the small space constraints.

\medskip
\subsubsection{Software Standards}
% TODO references here
\medskip
Rust code will follow the the Rustfmt standard of source layouts, Rustfmt is a tool provided by the Rust project that automatically formats all source in the standard format.
The Rust compiler also provides a few warnings for common formatting issues builtin, which will be heeded.
Arduino language will follow the ISO C/C++ programming standards \cite{cpp_core_guidelines}.
The Arduino style guide \cite{arduino_style_guide} presented are more ad hoc than a full style guide.

% introduce major libraries that largely dictate how we implement the system.
\medskip
\subsubsection{Frameworks}
\medskip
Akriveia Beacons' main DPU framework is called \Gls{Actix}.
Actix is an \Gls{Actor} Framework that follows the \Gls{Actor Model} paradigm of multi-threaded workloads.
The Actor Model operates on objects called actors to orchestrate concurrent computations, it does this by treating actors as separate entities that execute on an event loop on one or more threads, where the event loop simply looks at a list of events generated by actors and executes each event in order as long as it is not blocked by other events.
Events are generated when actors pass messages to each other, in response the actor that receives the message can modify its local state, create other actors, send messages to other actors, execute arbitrary logic, and finally send a response to the message.
This programming paradigm prevents the need for locks (and by extension, deadlocks) because the message passing mechanism alleviates the need to manually manage concurrency, opting to use the abstractions instead. 

\bigskip
Actix was chosen primarily to give the flexibility of multi-threading without incurring the typical thought process overhead associated with multi-threading.
Additionally, as a framework rather than a library, Actix serves as the basis to make REST webservers through the package \Gls{Actix Web}, which is further discussed under the sections \ref{software_libraries} and \ref{webserver_section}.

\pagebreak
% discuss which libraries we are using, and how they will be used by us
\subsubsection{Libraries}
\label{software_libraries}
\medskip
The Akriveia Beacon system will contain the following libraries.
\medskip
\begin{table}[H]
\centering
\begin{tabular}{ | m{3.25cm} | m{12.5cm} |}
	\hline
	\textbf{Actix Web} & The Actix Web library is a crate that extends the functionality of the Actix framework to create \Gls{HTTP} webservers. \\
	\hline
	\textbf{Yew} & Yew is a crate that extends Rusts ability to compile to Web Assembly by adding the ability to dynamically generate html on the client in response to user events and DPU responses. \\
	\hline
	\textbf{Serial Port} & Enables serial communication over USB between the DPU and beacons.\\
	\hline
	\textbf{Rust Standard Libraries} & This is the standard Rust runtime library, and contains many useful boilerplate functions and generic types. This library is included with the basic installation of Rustc. \\
	\hline
\end{tabular}
\caption{Akriveia Beacon Dependencies - Rust}
\end{table}

\begin{table}[H]
\centering
\begin{tabular}{ | m{3.25cm} | m{12.5cm} |}
	\hline
	\textbf{Arduino} & The standard set of Arduino libraries based off of the standard C library tailored specifically for Atmel Atmega AVR  microcontroller chips. \\
	\hline
	\textbf{ESP32 WiFi} &  Arduino core for ESP32 WiFi/BLE chip\\
	\hline
	\textbf{DWM1000} & A library that offers basic functionality to use Decawave's DW1000 chips/modules with Arduino \\
	\hline
\end{tabular}
\caption{Akriveia Beacon Dependencies - Arduino}
\end{table}

\bigskip
% discuss the model view controller paradigm, and its benefits
\subsection{Model-View-Controller}
% TODO glossary of mvc
\medskip
The model-view-controller (MVC) paradigm is a common method of separating concerns between modules.
It is an architectural pattern that separates concerns in a general way, allowing for code reuse and improving parallel development, it is also a common practice which allows others familiar with the paradigm to ramp up quickly on new projects.
Unsurprisingly, the MVC is split into three components, the model, controller and view.
The model describes data, data manipulation, as well as data storage.
The view describes how to view the model.
The controller acts as the means to communicate between the view and model based on data inputs, and is also capable of higher order operations such as between multiple models.

\bigskip
As the Actix Web library is less mature than frameworks in other languages such as Python's Django or Ruby's Rails, the DPU implementation will contain larger portion of boilerplate when compared to those other libraries.
This allows for greater flexibility in implementation, at the cost of marginally higher development time.
A benefit to writing a more tailored implementation, is that MVC and frameworks that closely follow MVC do not have a good answer for organizing functionality that falls outside of the architectures coverage such as background tasks.
Akriveia is required to maintain communication with many beacons and perform calculations asynchronously from web requests, which is the perfect use case for the actor framework which fills the void of the model-view-controller.

\bigskip
% discuss how we plan to multithread the data processor. go into slightly more detail about actix actors, and why this
% is necessary
\pagebreak
\subsection{Threading Model}
\medskip
The purpose of multi-threading the DPU is to make use of the hardware provided, since all modern server and desktop processors have at least two dedicated hardware cores.
Additionally, it is important for the DPU to have realtime responsiveness on the webserver, requiring that large computations such as trilateration for many beacons must be offloaded to other threads, keeping responsiveness high since the webserver thread is not blocked on computation while a request comes in.
An additional consideration specifically for the proof of concept which uses blocking serial communication to communicate to the beacons, meaning that each beacon requires a dedicated thread to communicate with the DPU.

\bigskip
Rust and Actix make multi-threaded development easier by using message passing for inter-thread communication, at the cost of performance when compared to traditional mutexes and atomics.
The implementation of message passing is a thread safe queue using mutexes and atomics to ensure data integrity, where multiple threads are able to send commands to another thread, which receive the message without blocking either thread.
To further discuss the Actix threading model, some definitions are required:
\begin{enumerate}
	\item Actor: A class that contains message handler callbacks.
	\item Arbitor: A thread pool, where each thread in the pool is an event loop.
\end{enumerate}
Once instantiated, the \Gls{Arbiter} spawns as many threads as indicated by its constructor and waits for actors to be spawned within the thread pool.
By default, the number of threads in the pool is the number of cores on the CPU.
The \Gls{Arbiter} is an environment for actors to execute, and as actors are spawned into the thread pool, they can send messages to other actors, or create other actors in response to external events such as from the file system or HTTP requests.
As shown in Figure~\ref{actix_thread_model}, the arbitor manages its own threads, which are all spawned at startup rather than on demand.
Within each thread, the arbitor executes the event loop, which polls its queue, and acts on any messages in the queue by delegating the task to the actor the message is bound to.
To pass a message to another actor, the sender must have the address of the recipient so that the arbitor can determine the destination, rather than a broadcasting system; this is shown in Figure~\ref{actix_messages}.

\bigskip
The beacons and ID tags do not have a full operating system, so they can only rely on single threaded interrupt handling to "multitask".
Interrupt handling does not provide full concurrency, instead it time slices the single core to provide the illusion of multitasking.
The basics of Interrupt handling is that it calls a function as a result of an event such as an external device raising a bit high on the CPU, or when a timer goes off.
In the Proof concept, the bluetooth library uses this functionality to handle connections.
When transitioning to WiFi and UWB, similar functionality will be implemented in each respective technology's library.

\pagebreak
\begin{figure}[H]
	\centering
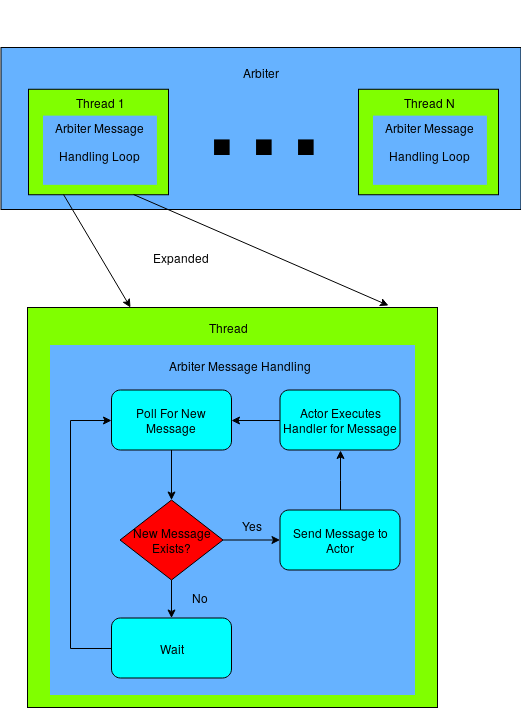
[picture p27: Documents/Design_Documents/02_Design_Specification/images/actix_thread_model.png]
    
    \caption{Actix Thread Model}
    \label{actix_thread_model}
\end{figure}

\bigskip
\begin{figure}[H]
	\centering
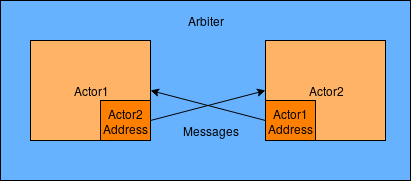
[picture p28: Documents/Design_Documents/02_Design_Specification/images/actix_message_passing.png]
    
    \caption{Actix Message Passing}
    \label{actix_messages}
\end{figure}
\pagebreak

% discuss the data processor subsystems in detail
\subsection{Data Processor Software Architecture}
\medskip
In the proof of concept, the DPU creates an HTTP server actor and a beacon manager actor.
The HTTP server waits on web requests, delegating tasks to the beacon manager and polling it for the necessary information.
On startup, the beacon manager queries the number of serial arduino devices, spawning a thread for each device.
Each thread spawned by the beacon manager represents a serial connection to a beacon.
The beacon manager sends messages using a traditional Multiple Producer Single Consumer Message Queue (\Gls{MPSC}) defined in the Rust standard library, while each serial communcation thread returns messages back to the manager through the actix message passing system.
Figure~\ref{software_poc_arch} gives a graphical representation of the previous description.
Actix uses MPSC internally for its message passing system.

\bigskip
The prototype and final versions bring in major changes to the software design.
As shown in figure~\ref{software_final_arch}, a major change is the removal of the serial connection actor which is replaced with the UDP actor.
The beacon manager remains, but instead controls the UDP actor rather than the serial connections.
An additional role of the beacon manager is to delegate computation of trilateration to the trilateration processor actor, which will save data in memory until there are at least 3 data points for a single ID tag to determine its position.
The trilateration processor makes the positional calculation and saves new position to disk via the ID tag model, which abstracts the database query.
The beacon and map models perform a similar role, abstracting their associated database queries into a single location following \Gls{MVC}.
Controllers mainly handle the model they were paired with, however the ID tag controller will also query the trilateration processor for real-time positional data and the beacon controller commands beacons indirectly through the beacon manager.

\bigskip
By design, the DPU is a client-server architecture, where the DPU is the server for a browser based client.
The client-server architecture lends itself to be very flexible and is a very heavily used model for both consumer systems and emergency response systems alike.
Once the backend starts executing, any computer able to access the IP of the DPU will have access to the system assuming the network is configured in such a way to allow this, and that the user has the correct credentials.
Conversely with no additional development work the same DPU when hooked up to a monitor can act like a client based application by simply accessing localhost on a browser.
Variations and alternatives to the client server-architecture were considered, but did not meet the needs of the Akriveia Beacon System, below are some of the choices considered and why they do not fit the role.

\bigskip
An electron application that utilizes browser technologies merges the backend and frontend together, behaving like a client based application, which will reduce deployment flexibility because a monitor connected directly to the DPU will be the only access point to the GUI, however the display will potentially need to be accessed by multiple users at a time, and will introduce high coupling between the frontend display and backend computation.
Electron applications are also highly single threaded, meaning that they will have higher difficulty in utilizing all cores on the CPU, wasting money on hardware that could otherwise be used.
Electron applications are also fixed to using a single language, Javascript, for both processing and display, whereas a webserver fixes the GUI implementation to Javascript however leaves the backend to a much broader range of languages where processing performance is more critical.

\pagebreak
Compared to a GUI implemented using graphics driver interfaces such as OpenGL, Vulkan, DirectX, or any higher level libraries that provide interfaces to graphics drivers, a GUI implemented in HTML and Javascript will take much less time to implement because both Javascript and HTML abstract away memory concerns such as pointers, and will never have memory related runtime errors, as guaranteed by the browser.
Browsers have widespread adoption, in every GUI based operating system at least one browser is installed by default, making them widespread and widely used.
Due to widespread adoption, browsers provide the flexibility to display the GUI either on the computer hosting the server itself, or just as easily the GUI can be accessed through another computer at the customers discretion.

\bigskip
\begin{figure}[H]
	\centering
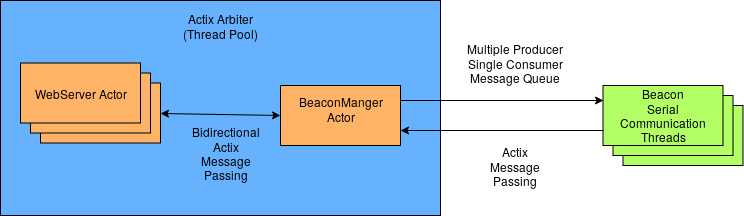
[picture p29: Documents/Design_Documents/02_Design_Specification/images/poc_arch.png]
    
    \caption{Proof of Concept Software Architecture}
    \label{software_poc_arch}
\end{figure}

\bigskip
\begin{figure}[H]
	\centering
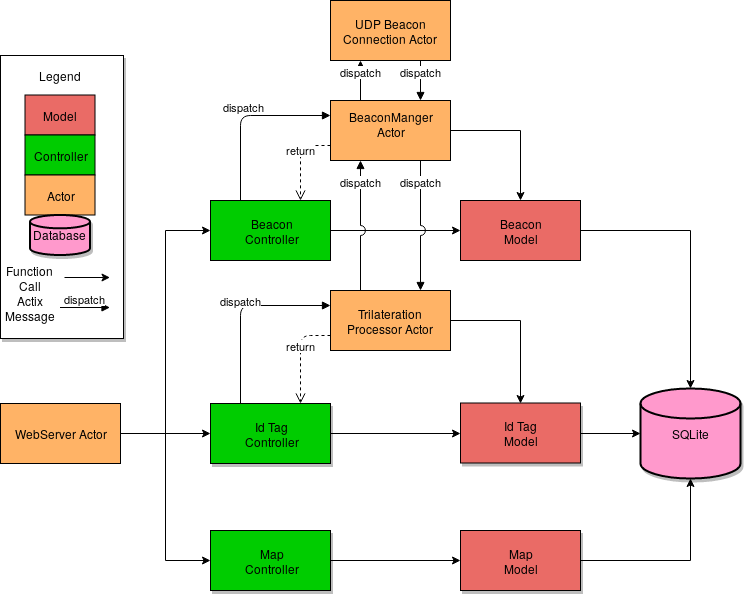
[picture p30: Documents/Design_Documents/02_Design_Specification/images/prototype_software_arch.png]
    
    \caption{Final Software Architecture}
    \label{software_final_arch}
\end{figure}

\bigskip
% discus the purpose of the webserver, and how it will be used to control the other subsystems dictated by user command.
\subsubsection{Webserver Subsystem}
\label{webserver_section}
\medskip
The purpose of the Webserver Subsystem is to bridge the GUI and backend by providing a data transfer interface in the form of HTTP REST calls.
A Webserver architecture is chosen because of its simplicity to implement, widespread adoption, and flexibility.
The view is discussed further in Section~\ref{view_section}: View.

\bigskip
The Webserver Subsystem will be designed to serve data to a browser, including the the HTML and Javascript files (GUI files) that are displayed by the browser.
Once the browser has the GUI files, it will make additional requests to the backend to keep updated information displayed on the GUI.
The Webserver Subsystem will only allow logged in users to access sensitive data, and only if they have the correct access rights.
Electron applications and traditional rendering APIs were also considered, however they each have trade-offs that do not fit with the design requirements of Akrievia.

\bigskip
A direct alternative to Actix Web is a web framework called Rocket.
Rocket behaves more like a traditional web server: supporting \Gls{Server Side Rendering} and json parsing out of the box.
This functionality comes at a cost in multiple ways, first rocket is primarily single threaded, second Rocket adds new features at the cost of reducing flexibility, and third rocket does not directly support the Actix Actor system, leaving all non-webserver code up to the developer to implement on their own.
In comparison, Actix Web does support and extend the Actor system which makes for a more integrated and unified codebase, and by using the Actor system within the webserver, multithreadability is easily added as needed on a per endpoint basis.
Rocket's additional out-of-the-box features are really just Rust crates in disguise, and so by using Cargo(Rusts package manager for crates) the same functonality can be quickly implemented within an Actix webserver at very little additional time cost.

\medskip
\subsubsection{Beacon Manager Subsystem}
\medskip
The role of the beacon manager is to commands to and from the individual beacon connections, and to give an abstraction for external systems that need not concern themselves with communication details, or how many beacons there actually are.
The Beacon Manager is a singleton, which means there is only one of them in the entire system, and has implications on the design of the rest of the system.
The most notable design influence is that the beacon manager can quickly become a bottleneck if it performs too much processing directly, and so to prevent this the beacon manager offloads as much work as it can to other subsystems.

\medskip
\subsubsection{Serial Beacon Communication Subsystem}
\medskip
In the proof of concept design, this actor deals with blocking serial communication with dedicated threads to keep the connection alive and to prevent web requests from blocking.
This subsystem will remain as bare bones as possible, because it only serves the purpose of quickly creating a working system and will be discarded in future iterations of the DPU.

\pagebreak
\subsubsection{Trilateration Processing Subsystem}
\medskip
In the final design, the trilateration processing subsystem takes in time of flight data messages from the beacon manager.
The trilateration processor waits until it receives enough data points, and once it has 3 data points from 3 different beacons for one id tag it can perform a location calculation.
While waiting for a full set of data, the incomplete set of data will be stored in a hash table where the mac address of each ID tag is the key and the contents are the array of data points.
Once the array of data points hits the threshold size of 3 from adding a new data point, the processor can perform the trilateration calculation.
The trilateration calculation can then be used to update the database entry for the corresponding ID tag by the processor.

\bigskip
To avoid going to the database for real-time updates of the ID tag locations, the ID tag controller will directly query the Trilateration Processor for the most up to date location information, reducing latency. The existence of the Trilateration Processing subsystem is necessary, because the beacon manager will quickly become a bottleneck due to the fact that it is a singleton in a multithreaded system.
As such, the manager should do as little direct processing and blocking operations itself and instead favour offloading the tasks to other subsystems.

\medskip
\subsubsection{UDP Beacon Communication Subsystem}
\medskip
In the final design, the UDP Beacon Communication Subsystem actor will communicate with the beacons over the UDP networking protocol.
UDP was chosen because it has less overhead than TCP, and is more suited for real-time applications such as Akriveia.

\medskip
% discuss database choice - sqlite and why. lead into models
\subsection{Database}
\medskip
Akrievia Beacon System requires a database to persist map, beacon, and user information.
In the time constraints of Capstone, the database will be a central location for data.
Ideally a production system would support replication of the database to another location, but this is out of scope for the purposes of this project.
SQLite was chosen primarily because of its simplicity to set up and minimal footprint.
Most commonly used in phones and packaged alongside python, SQLite has a stable file format and large userbase, and because of this has built a reputation for not failing.

\bigskip
SQLite is open source, and because of this issues can directly be brought up to the developers along with help from a large amount of experience from the internet due to the large userbase.
Open source projects are also freely available to browse to learn directly from the codebase when necessary.
In Akriveia, the database is accessed through model objects to keep concerns local to a single set of similarly structured files, and to keep re-usability up in the codebase.

\medskip
% discuss how we plan to represent data in the database, tie back to model-view-controller(specifically models, which
% will implement all of the database queries for the controllers to use.
\subsection{Models}
\medskip
Models are used to group database queries and model operations into a single file for each model, increasing reusability of the system.
Akrievia is expected to maintain three different types of models: maps, ID tags, and beacons. The following tables \ref{user_model}, \ref{beacon_model}, and \ref{map_model} show expected data entries and their type for each model, along with the purpose of each entry.

\begin{table}[H]
\centering
\def\arraystretch{1.4}
\begin{tabular}{| m{3cm} | m{3cm} | m{9.5cm} |}
	\hline
	\multicolumn{3}{|c|}{User Model} \\
	\hline
	Data Name & Type & Explanation \\
	\hline
	User Type & String & Indicates the type of user, either admin, employee, emergency contact, or first responder. \\
	\hline
	Employee Id & String & Employee ID for each user, for internal housekeeping of the company that purchases Akriveia Beacon. \\
	\hline
	Full Name & String & Human readable name to identify the user on lists. \\
	\hline
	Phone Number & String & Phone number to contact the user. \\
	\hline
	Emergency Contact & ref:User & Reference to another user as emergency contact. Emergency contacts will not have an employee id or tag id. \\
	\hline
	Notes & String & Notes about the user, i.e. allergies or disabilities, etc. \\
	\hline
	Id Tag Number & 64 bit Integer & table key, unique, id for each user. \\
	\hline
	Coordinates & 2D Vector & Last known location of the user within the map. \\
	\hline
	Last Seen Timestamps & Unix Timestamps & To identify the ID tag data is stale. Used to determine if the employee is at work while the disaster occurs. \\
	\hline
	Map ID & ref:Map & Last known map the user was located at. \\
	\hline
\end{tabular}
\caption{User Model}
\label{user_model}
\end{table}

\begin{table}[H]
\centering
\def\arraystretch{1.4}
\begin{tabular}{ | m{3cm} | m{3cm} | m{9.5cm} |}
	\hline
	\multicolumn{3}{|c|}{Beacon Model} \\
		\hline
	Data Name & Type & Explanation \\
	\hline
	MAV address & String & unique device identifier for beacon, table key.\\
	\hline
	Name & String & Human readable String for the device. \\
	\hline
	Map ID & ref:Map & Reference to a floor/map - this is really just the floor number. Shows the many-to-one relationship between beacons and floors. \\
	\hline
	Notes & String & Additional Beacon information (i.e. floor and location). \\
	\hline
\end{tabular}
\caption{Beacon Model}
\label{beacon_model}
\end{table}

\begin{table}[H]
\centering
\def\arraystretch{1.4}
\begin{tabular}{| m{3cm} | m{3cm} | m{9.5cm} |}
	\hline
	\multicolumn{3}{|c|}{Map Model} \\
	\hline
	Data Name & Type & Explanation \\
	\hline
	Name & String & Human readable floor name for gui. \\
	\hline
	Floor ID & String & Table key, unique floor number of the map, this is not an integer to accomodate the possibility of odd floor naming conventions. e.g. floor 1A, or basement. \\
	\hline
	Bitmap data & Binary & Bitmap for the floor blueprints to view on the gui. \\
	\hline
\end{tabular}
\caption{Map Model}
\label{map_model}
\end{table}

\pagebreak
% discuss what each controller will do - i dont expect this one to be very meaty
\subsection{Controllers}
\medskip
Controllers are part of the MVC philosophy, unfortunately Actix does not directly support the controller concept, however this functionality can be implemented manually using Actix Web primitives.
Each controller exposes available operations for the frontend to manipulate data in a controlled and secure manner.
The controller manages data using the models to perform direct manipulations and can aggregate data that cannot otherwise be done by models.
Table~\ref{controllers_table} shows the list of expected controllers in the DPU, one to match each model.

\medskip
\begin{table}[H]
\centering
\begin{tabular}{| m{3cm} | m{9.5cm} |}
	\hline
	\multicolumn{2}{|c|}{Map Model} \\
	\hline
	Controller Name & Explanation \\
	\hline
	Maps & Handles requests for map operations such as to create, update, delete the map instances. \\
	\hline
	Beacons & Handles requests for beacon operations such as to create, update, delete beacon the model instances. \\
	\hline
	Users & Handles requests for user(id tag) operations such as to create, update and delete user instances. \\
	\hline
\end{tabular}
\caption{Controllers list}
\label{controllers_table}
\end{table}
\medskip

% describe how the view will work, but dont go into details about the GUI visuals - leaving that for the ui appendix
% mention browser, js, html, Rust -> webassembly compile
\subsection{View}
\medskip
\label{view_section}
\medskip
The view is part of the MVC philosophy, since its main job is to display data to the GUI in an intuitive way. In Akriveia Beacon, the view is a static webpage served by the Actix Webserver, and compiled from the backend. Traditionally, browsers render HTML and Javascript served by the backend webserver, however, in this project the frontend is written entirely in Rust and compiled to a small HTML stub and webassembly which then dynamically generates more HTML for the browser to render. The benefit of this approach is that it creates strong separation between the view and controller, and also greatly reduces the number of endpoints that need to be implemented on the controller. This way it can reduce code duplication and surface area of the webserver, which lower the possibility of exploitation by reducing exposure to a small set of well defined operations. 

\bigskip
Client side Rust is possible via the Yew crate, which is a Rust package that leverage the web assembly LLVM backend for Rust. Yew adds additional facilities to Rust for webassembly generation such as macros that allow HTML to be written in lined to Rust, similar to Reacts JSX. Yew also supports the concept of Agents, which is their version of Actors inspired by Actix and Erlang. Yew also has the ability to interact with npm packages, in case the functionality is not already implemented in Rust. As Yew is influenced by React, it is very possible to simply write the GUI using React. 

\pagebreak
The drawback of using React is that it is written in Javascript, meaning that an implementation using React would make the language of the backend different from the language of the frontend creating overhead in development. Furthermore, react contains strict definitions and interfaces which would need to be implemented twice, once in each language adding tedious boilerplate. The modern Javascript development environment as a whole is also getting fairly unwieldy, as of 2019 more packages are being added which each introduce transformation steps of the code. An example of this workflow could involve writing typescript which is transformed into Javascript, then minimizing the Javascript into unreadable but more performant minimized Javascript. Additional steps would similarly be added for \Gls{Babel} scripts. In the example both of the steps are added to the build manually using webpack which incurs more development overhead to understand and configuration.

\bigskip
Yew on the other hand has an opaque compilation step that transforms Rust code into webassembly, which does not require any additional build steps to configure other than installing the package. One of the downsides to using Rust compiled to webassebly is that it simply cannot be debugged since it is more similar to binary, but this issue has not arisen yet since framework is very simple to use. It does seem, in theory, possible to compile Rust to Javascript which can be debugged in the browser, but debugging Javascript which was generated from another language will likely not be a very fruitful exercise.

\bigskip
Server Side rendering of templates using libraries such as Askama and Tera were also considered instead of creating a single page website. This method of rendering is fantastic for form submissions, however real time and dynamic pages strain the abilities of server side rendering. Akrievia will require real time updates of maps, which will look and perform much better when rendered on the client side rather than having the backend needlessly re-render the same page with different data. Typically, when real time functionality is required for server side rendered applications, some pages are converted to using client side rendering while others remain server side rendered, requiring libraries like React or \Gls{JQuery}. By simply using client side rendering, the frontend is consistently implemented throughout, rather than requiring more than one type of rendering.
\bigskip
Please see Appendix B: User Interface and Appearance for additional details on the UI layout.

\medskip
% discuss security considerations, talk about features of Rust which help us in this regard.
\subsection{Security}
\medskip
Due to the properties of Rust, many security concerns regarding bad input data and memory issues are mitigated.
One such migitation is built in bounds checking of all array accesses, meaning that its not possible to read or write memory that has not been properly allocated by the executing process.
An additional level of security is that rust reduces the number of invalid computational state, removing the burden from the programmer which could potentially get it wrong, which would create vulnerabilities.
As rust is a strongly typed language, it also benefits from static type checking which eliminates entire classes of bugs that also could lead to vulnerabilities.

\bigskip
All stored user data will be encrypted using the latest encryption algorithms, namely the sha3-512 algorithm.
In memory data will be unencrypted for as short of a time as possible to reduce the surface area of potential attacks.

% MOVED BEACON AND ID TAG INTO HARDWARE SECTION
\pagebreak
\subsection{Software Design Requirements}
\medskip
The Akriveia Beacon system is composed of an intricate software stack developed in rust.
The data processing unit is the main computational unit and will be implemented with trilateration algorithms to locate ID tag positions in near real time.
In order for the software system to be reliable, secure and accurate the following design specifications were made.

\medskip
\bgroup
\def\arraystretch{1.5}
\begin{table}[H]
\centering
\begin{tabular}{ | m{3cm} | m{12.5cm} |}
\hline
\textbf{REQ.SW.1 - C} &  The DPU software stack must be implemented using Rust  \\
\hline
\textbf{REQ.SW.2 - C} &  The DPU must contain a Linux based operating system  \\
\hline
\textbf{REQ.SW.3 - C} &  Each beacon must acknowledge a stop receiving command to stop sending ID tag location data to data processing unit \\
\hline
\textbf{REQ.SW.4 - C} &  Each beacon must acknowledge a start sending command to start sending ID tag location data to data processing unit  \\
\hline
\textbf{REQ.SW.5 - P} &  The admin must login through credential verification system before before accessing system data \\
\hline
\end{tabular}
\caption{Software Design Specification}
\end{table}
