liuyal/Akriveia/Documents/Design_Documents/01_Requirements_Specification/00_Glossary.tex

\newglossaryentry{C2C}{name=C2C, description={Cradle to Cradle development to ensure innovating and sustainable products}}
\newglossaryentry{CSA}{name=CSA, description={Canadian Standards Association is a standards development organization}}
\newglossaryentry{DC}{name=DC, description={Direct current voltage}}
\newglossaryentry{GUI}{name=GUI, description={Graphical User Interface}}
\newglossaryentry{ID}{name=ID, description={Identification}}
\newglossaryentry{IEC}{name=IEC, description={International Electrotechnical Commission}}
\newglossaryentry{IEEE}{name=IEEE, description={Institute of Electrical and Electronics Engineers}}
\newglossaryentry{ISO}{name=ISO, description={the International Organization for Standardization. }}
\newglossaryentry{MCU}{name=MCU, description={Micro-controller unit}}
\newglossaryentry{PCB}{name=PCB, description={Printed circuit board}}
\newglossaryentry{PoC}{name=PoC, description={Proof of concept is the sample product assembled to explore project feasibility}}
\newglossaryentry{RF}{name=RF, description={Radio Frequency}}
\newglossaryentry{RS485}{name=RS485, description={A standard for defining serial communication published by the Telecommunications Industry Association}}
\newglossaryentry{RSSI}{name=RSSI, description={Received Signal Strength Indicator}}
\newglossaryentry{SBC}{name=SBC,description={Single-Board Computer}}
\newglossaryentry{ToF}{name=ToF, description={Time-of-Flight is a method for measuring the distance between a sensor and an object}}
\newglossaryentry{UI}{name=UI, description={User Interface}}
\newglossaryentry{UWB}{name=UWB, description={Ultra wide band}}
\newglossaryentry{iOS}{name=iOS, description={Operating system released by Apple Inc.}}
