liuyal/Akriveia/Documents/Design_Documents/01_Requirements_Specification/04_Engineering_Standards.tex

\setcounter{section}{3}
\section{Engineering Standards \& Responsibilities}
\bigskip
The Akriveia Beacon will be designed to meet various engineering standards published by the \Gls{IEEE}, the \Gls{IEC}, the \Gls{ISO}, and the \Gls{CSA} Group to ensure performance and safety of the final product. The system contains electronics, software, and communication protocols, which means that suitable standards must be followed. The data communication on the physical layer is done using frequency on the ultra-wideband spectrum operating in unlicensed frequency bands, wireless standards that apply to the operation band will be followed. Akriveia Beacon is designed to operate during disaster situations, material and design must follow the structural and durability standards for disaster equipments. 

\subsection{Electronics Standards}
\bgroup
\def\arraystretch{1.5}
\begin{table}[H]
\centering
\begin{tabular}{ |p{3cm} p{11cm} | }
\hline
\multicolumn{1}{|r|}{IEEE 1625} & IEEE Standard for Rechargeable Batteries for Multi-Cell Mobile Computing Devices \cite{R7}\\ 
\hline
\multicolumn{1}{|r|}{CSA-C22.2 NO.61508-1:17} & Functional safety of electrical/electronic/programmable electronic safety-related systems - Part 1: General requirements \cite{R8}\\ 
\hline
\multicolumn{1}{|r|}{CSA-C22.2 NO.0.23-15} & General requirements for battery-powered appliances \cite{R9}\\  
\hline
\multicolumn{1}{|r|}{CAN/CSA-C22.2 NO.0-10} & General requirements - Canadian electrical code, part II \cite{R10}\\ 
\hline
\multicolumn{1}{|r|}{IEEE P360} & Standard for Wearable Consumer Electronic Devices - Overview and Architecture \cite{R11} \\  
\hline
\end{tabular}
\caption{Electronics Standards}
\end{table}	
\medskip

\subsection{Wireless Standards}
\bgroup
\def\arraystretch{1.5}
\begin{table}[H]
\centering
\begin{tabular}{ | p{3.5cm} | p{11.5cm}| } 
\hline
\multicolumn{1}{|r|}{IEEE 802.15.2-2003} & IEEE Recommended Practice for Information technology-- Local and metropolitan area networks-- Specific requirements-- Part 15.2: Coexistence of Wireless Personal Area Networks with Other Wireless Devices Operating in Unlicensed Frequency Bands \cite{R12}\\ 
\hline
\multicolumn{1}{|r|}{IEEE 802.15.4q-2016} & IEEE Standard for Low-Rate Wireless Networks --Amendment 2: Ultra-Low Power Physical Layer \cite{R13}\\ 
\hline
\multicolumn{1}{|r|}{ISO/IEC 26907:2009} & Information technology -- Telecommunications and information exchange between systems -- High-rate ultra-wideband PHY and MAC standard \cite{R14}\\  
\hline
\multicolumn{1}{|r|}{ISO/IEC 24730-62:2013} & Information technology -- Real time locating systems (RTLS) -- Part 62: High rate pulse repetition frequency Ultra Wide Band (UWB) air interface \cite{R15}\\  
\hline
\multicolumn{1}{|r|}{IEEE P802.15.4z} & Standard for Low-Rate Wireless Networks Amendment: Enhanced High Rate Pulse (HRP) and Low Rate Pulse (LRP) Ultra Wide-Band (UWB) Physical Layers (PHYs) and Associated Ranging Techniques \cite{R16}\\  
\hline
\end{tabular}
\caption{Wireless Standards}
\end{table}	

\pagebreak
\subsection{Software Standards}
\bgroup
\def\arraystretch{1.5}
\begin{table}[H]
\centering
\begin{tabular}{ | p{4cm} | p{12cm}| } 
\hline
\multicolumn{1}{|r|}{IEEE 12207-2017} & ISO/IEC/IEEE International Standard - Systems and software engineering -- Software life cycle processes \cite{R17}\\
\hline 
\multicolumn{1}{|r|}{IEEE P2510} & Standard for Establishing Quality of Data Sensor Parameters in the Internet of Things Environment \cite{R18}\\ 
\hline
\multicolumn{1}{|r|}{ISO 2382-9:1984} & Data processing -- Vocabulary -- Part 9: Data communication \cite{R19}\\
\hline 
\end{tabular}
\caption{Software Standards}
\end{table}	
\medskip

\subsection{Material Standards}
\bgroup
\def\arraystretch{1.5}
\begin{table}[H]
\centering
\begin{tabular}{ | p{4cm} | p{12cm}| }
\hline
\multicolumn{1}{|r|}{IEEE 1221-1993} & IEEE Guide for Fire Hazard Assessment of Electrical Insulating Materials in Electrical Power Systems \cite{R20}\\ 
\hline
\multicolumn{1}{|r|}{IEEE 848-2015} & IEEE Standard Procedure for the Determination of the Ampacity Derating Factor for Fire-Protected Cable Systems \cite{R21}\\ 
\hline
\end{tabular}
\caption{Material Standards}
\end{table}	

%\end{document}
