liuyal/Akriveia/Documents/Design_Documents/06_Prototype_Refinement/images/title_page_white.docx

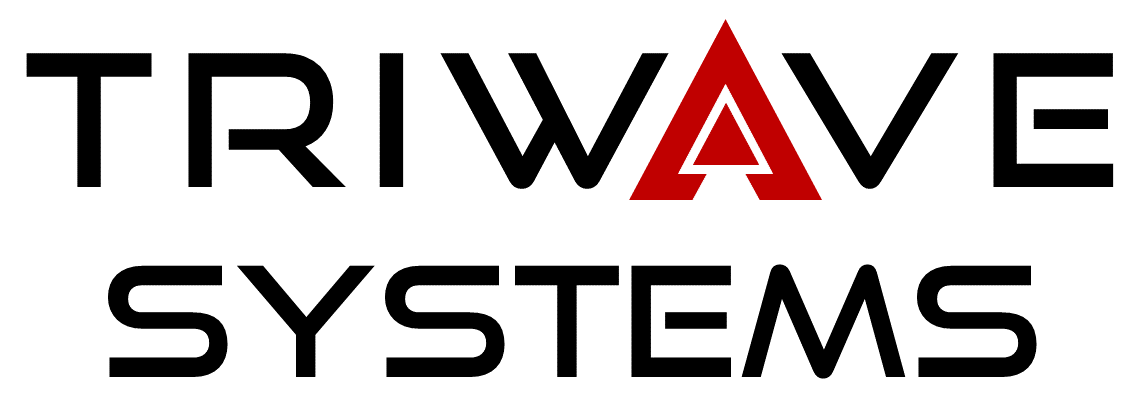
[picture p39: figure]

SFU

ENSC 440

Akriveia Beacon

Prototype Refinement

Team 5

28/10/2019

Project Team | Jeffery Yeung CCO Keith Leung CTO Scott Checko COO Ryne Waterson CIO Jerry Liu CEO
Contact | Jeffery Yeung zjyeung@sfu.ca
Submitted to | Dr. Andrew Rawicz School of Engineering Science Simon Fraser University
Issue Date | October 28, 2019
