liuyal/Akriveia/Documents/Design_Documents/01_Requirements_Specification/_Letter_of_transmittal.tex

 \documentclass[11pt]{letter}
\usepackage{graphicx}
\usepackage[a4paper, total={6.75in, 9.5in},top=0.1in,bottom=0.25in]{geometry}
\let\raggedleft\raggedright
\date{June 09, 2019}
\begin{document}

\begin{letter}{
Dr. Craig Scratchley\\
Dr. Andrew Rawicz\\
School of Engineering Science\\
Simon Fraser University\\
Burnaby, British Columbia\\
V5A 1S6\\
\bigskip
RE: ENSC 405W/440 Functional Specifications for Arkriveia Beacon\\
}

\begin{center}

\end{center}

\opening{Dear Dr. Scratchley and Dr. Rawicz,}

\medskip
The following document contains the Requirement Specifications for Akriveia Beacon - The Indoor Location Rescue System created by TRIWAVE SYSTEMS. The Akriveia Beacon focuses on locating persons trapped in buildings during small scale disasters such as fires and low magnitude earthquakes. This is achieved by incorporating a combination of advanced Ultra-wide-band radio modules and microcontrollers to create a dependable indoor positioning system using trilateration. We believe that the Akrievia Beacon system can aids search and rescue operators by allowing them to safely and reliably locate victims during an emergency or disaster.

\medskip
The purpose of this document is to provide a detailed description for the overall system architecture and requirements of the product according to the different development stages (proof-of-concept- prototype, and final product). This document consists of a system overview, system requirements, engineering standards, as well as safety and sustainability overviews.

\medskip
TRIWAVE SYSTEMS is composed of five dedicated and talented senior engineering students. The members are Keith Leung, Jeffrey Yeung, Scott Checko, Ryne Watterson, and Jerry Liu. Coming from various engineering concentrations with a diverse set of skills and experiences, we believe that our product will truly provide a layer of safety and reliability to search and rescue operations.

\medskip
Thank you for taking the time to review our requirement specifications document. If there are any further questions or comments, please direct them to our Chief Communications Officer Jeffrey Yeung at zjyeung@sfu.ca

\medskip
Sincerely,\\
Jerry Liu\\
Chief Executive Officer\\

\vspace*{-0.25cm}
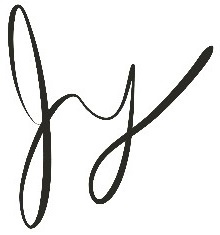
[picture p87: Documents/Design_Documents/01_Requirements_Specification/images/signature.jpg]


{Enclosed: Requirements Specification for Arkriveia Beacon}

\end{letter}

\end{document}
