liuyal/Akriveia/Documents/Design_Documents/01_Requirements_Specification/_Requirements_Specification.tex

\documentclass[11pt]{article}
\usepackage[a4paper, total={6.5in, 9.5in}]{geometry}
\usepackage[document]{ragged2e}
\usepackage[bookmarksopen=true,hidelinks]{hyperref}
\usepackage{bookmark}
\usepackage{lipsum}
\usepackage{graphicx}
\usepackage[noadjust]{cite}
\usepackage{float}
\usepackage[numbib]{tocbibind}
\usepackage{multirow}
\usepackage{array}
\usepackage{setspace}
\usepackage{cellspace}
\usepackage{etoolbox}
\usepackage{longtable}
\usepackage[table, svgnames]{xcolor}
\usepackage{titlesec}
\usepackage{amsmath}
\usepackage{pdfpages}
\setcounter{secnumdepth}{4}

\usepackage{fancyhdr}
\fancypagestyle{logo}{
    \fancyhf{} % clears header/footer
    \renewcommand\bottomfraction{0.9}
    \renewcommand\textfraction{0.1}
    \fancyhead[C]{}
    \fancyfoot[LE,RO]{\thepage}
}
\pagestyle{logo}

% Glossary
\usepackage[utf8]{inputenc}
\usepackage{glossaries}
\makeglossaries
\input{00_Glossary.tex}

\begin{document}

\setboolean{@twoside}{false}
\includepdf[pages={1}]{./images/_Letter_of_transmittal.pdf}

\setboolean{@twoside}{false}
\includepdf[pages={1}]{./images/title_page.pdf}

\bigskip
\input{00_Abstract.tex}
\pagebreak
\clearpage
\printglossaries
\pagebreak
\begin{spacing}{0.85}
\tableofcontents
\end{spacing}
\pagebreak
\listoffigures
\pagebreak
\listoftables
\pagebreak
\input{01_Introduction.tex}
\pagebreak
\input{02_System_Overview.tex}
\pagebreak
\input{03_System_Requirements.tex}
\pagebreak
\input{04_Engineering_Standards.tex}
\pagebreak
\input{05_Safety_Sustainability.tex}
\pagebreak
\input{06_Conclusion.tex}
\pagebreak
\input{07_References.tex}
\pagebreak
\input{08_Appendix.tex}

\end{document}
