liuyal/Akriveia/Documents/Design_Documents/03_Project_Proposal/_Letter_of_transmittal.tex

 \documentclass[11pt]{letter}  
\usepackage{graphicx}
\usepackage[a4paper, total={6.75in, 9.5in},top=0.5in,bottom=0.25in]{geometry}
\let\raggedleft\raggedright 
\date{July 21, 2019}
\begin{document}

\begin{letter}{
Dr. Craig Scratchley\\
Dr. Andrew Rawicz\\
School of Engineering Science\\
Simon Fraser University\\
Burnaby, British Columbia\\
V5A 1S6\\
\bigskip
RE: ENSC 405W/440 Project Proposal for Arkriveia Beacon\\
} 

\begin{center}
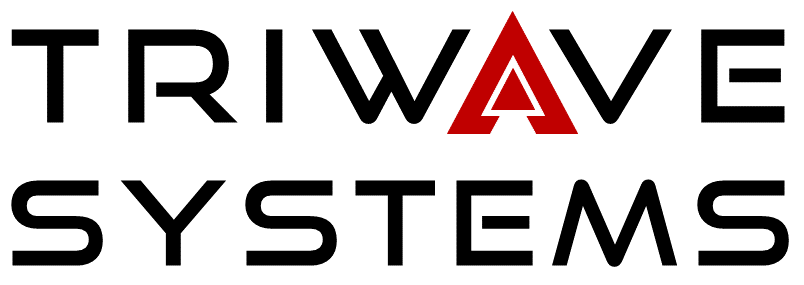
[picture p88: Documents/Design_Documents/03_Project_Proposal/images/logo_W.png]

\end{center}

\opening{Dear Dr. Scratchley and Dr. Rawicz,} 
 
 \bigskip
The following document contains the Project Proposal for the Akriveia Beacon - The Indoor Location Rescue System created by TRIWAVE SYSTEMS. The Akriveia Beacon focuses on locating personnel trapped in buildings during small scale disasters such as fires and low magnitude earthquakes. This is achieved by incorporating a combination of advanced Ultra-wideband radio modules and microcontrollers to create a dependable indoor positioning system using trilateration methods. We believe our system allows search and rescue operator to safely and reliably locate victims during an emergency or disaster. Therefore, lowering the search a rescue time and increasing the chances of rescue and survival for trapped victims.

\bigskip
In the attached project proposal provides an overview of the Akriveia Beacon system  as well as present the scope, risks, and benefit analysis of the product. It will then examine current market and potential competitions and discuss project budget, funding and cost considerations. Furthermore, an overview of the timeline and planned schedule for the Alpha and Beta phases of this project is presented, and lastly, a brief introduction to the project team members will be provided.

\bigskip
TRIWAVE SYSTEMS is composed of five dedicated and talented senior engineering students. The members include Keith Leung, Jeffrey Yeung, Scott Checko, Ryne Watterson, and Jerry Liu. Coming from various engineering backgrounds with a diverse set of skills and experiences, we believe that our product will truly provide a layer of safety and reliability to search and rescue operations.

\bigskip
Thank you for taking the time to review our project proposal document. If there are any further questions or comments, please direct them to our Chief Communications Officer Jeffrey Yeung at zjyeung@sfu.ca

\medskip
Sincerely,\\
Jerry Liu\\
Chief Executive Officer\\

\vspace*{-0.25cm}


{Enclosed: Project Proposal for the Arkriveia Beacon}

\end{letter}

\end{document}
