liuyal/Akriveia/Documents/Design_Documents/02_UI_Appendix/10_0_Appendix_UI_Design.tex

\documentclass[11pt]{article}
\usepackage[a4paper, total={6.5in, 9.5in}]{geometry}
\usepackage[document]{ragged2e}
\usepackage[bookmarksopen=true,hidelinks]{hyperref}
\usepackage{bookmark}
\usepackage{lipsum}
\usepackage{graphicx}
\usepackage{float}
\usepackage[numbib]{tocbibind}
\usepackage{multirow}
\usepackage{array}
\usepackage{setspace}
\usepackage{cellspace}
\usepackage{etoolbox}
\usepackage{longtable}
\usepackage[table, svgnames]{xcolor}
\usepackage{titlesec}
\usepackage{amsmath}
\usepackage{pdfpages}
\setcounter{secnumdepth}{4}
\usepackage{fancyhdr}
\fancypagestyle{logo}{
    \fancyhf{} % clears header/footer
    \renewcommand\bottomfraction{0.9}
    \renewcommand\textfraction{0.1}
    \fancyhead[C]{}
    \fancyfoot[LE,RO]{\thepage}
}
\pagestyle{logo}

%\usepackage[noadjust]{cite}
\usepackage[sorting=none, backend=biber]{biblatex}
\addbibresource{bibi_uid.bib} 

% Glossary
\usepackage[utf8]{inputenc}
\usepackage{glossaries}
\makeglossaries
\input{00_Glossary.tex}

\begin{document}
\
\setcounter{section}{9}
\section{Appendix B: User Interface and Appearance}
\bigskip
\input{10_1_Introduction.tex}
\pagebreak
\input{10_2_User_Analysis.tex}
\pagebreak
\input{10_3_Technical_Analysis.tex}
\pagebreak
\input{10_4_Graphical_Representation.tex}
\pagebreak
\input{10_5_Engineering_Standards.tex}
\pagebreak
\input{10_6_Analytical_usability_testing.tex}
\pagebreak
\input{10_7_Empirical_usability_testing.tex}
\pagebreak
\input{10_8_Conclusion.tex}
\pagebreak
\printbibliography[heading=bibnumbered, title={Appendix References},type=book]
\pagebreak

\end{document}
