liuyal/Akriveia/Documents/Design_Documents/02_Design_Specification/_Design_Specification.tex

\documentclass[11pt]{article}
\usepackage[a4paper, total={6.5in, 9.5in}]{geometry}
\usepackage[document]{ragged2e}
\usepackage[bookmarksopen=true,hidelinks]{hyperref}
\usepackage{bookmark}
\usepackage{lipsum}
\usepackage{graphicx}
\usepackage{float}
\usepackage[numbib]{tocbibind}
\usepackage{multirow}
\usepackage{array}
\usepackage{setspace}
\usepackage{cellspace}
\usepackage{etoolbox}
\usepackage{longtable}
\usepackage[table, svgnames]{xcolor}
\usepackage{titlesec}
\usepackage{enumitem}
\usepackage{amsmath}
\usepackage{pdfpages}
\setcounter{secnumdepth}{4}
\usepackage{fancyhdr}
%\usepackage[noadjust]{cite}
\usepackage[sorting=none, backend=biber]{biblatex}
\addbibresource{bibi.bib} 
\addbibresource{bibi_uid.bib} 

\fancypagestyle{logo}{
    \fancyhf{} % clears header/footer
    \renewcommand\bottomfraction{0.9}
    \renewcommand\textfraction{0.1}
    \fancyhead[C]{}
    \fancyfoot[LE,RO]{\thepage}
}
\pagestyle{logo}

% Glossary
\usepackage[utf8]{inputenc}
\usepackage{glossaries}
\makeglossaries
\input{00_Glossary.tex}

\begin{document}

\setboolean{@twoside}{false}
\includepdf[pages={1}]{./images/_Letter_of_transmittal.pdf}
\setboolean{@twoside}{false}
\includepdf[pages={1}]{./images/title_page_white.pdf}

\input{00_Abstract.tex}
\pagebreak
\clearpage
\printglossaries
\pagebreak
\begin{spacing}{1}
\tableofcontents
\end{spacing}
\pagebreak
\listoffigures
\pagebreak
\listoftables
\pagebreak
\input{01_Introduction.tex}
\pagebreak
\input{02_System_Overview.tex}
\pagebreak
\input{03_System_Components.tex}
\pagebreak
\input{04_Hardware_Design.tex}
\pagebreak
\input{05_Electrical_Design.tex}
\pagebreak
\input{06_Software_Design.tex}
\pagebreak
\input{07_Conclusion.tex}
\pagebreak
\printbibliography[heading=bibnumbered, title={References}, nottype=book]
\pagebreak
\input{09_Appendix_Test_Plan.tex}
\pagebreak
\input{10_0_Appendix_UI_Design}

\end{document}
