liuyal/Akriveia/Documents/Design_Documents/09_440_Presentation_Demo/09_440_Presentation_Demo.pdf

Jerry Liu (CEO)
Ryne Watterson (CIO)
Keith Leung (CTO)
Jeffery Yeung (CCO)
Scott Checko (COO)

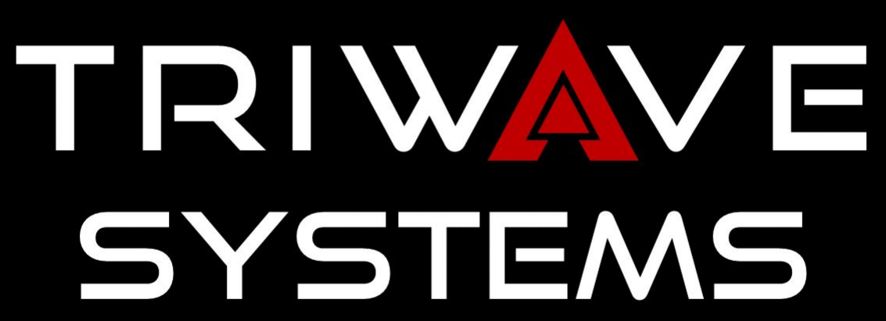
[picture p104: figure]

## Presentation Overview

1. Background & Motivation
2. Business & Cost Analysis
3. System Overview
4. Risk Assessment
5. Engineering Standards
6. Self Reflection
7. Concluding Remarks
8. Demo
9. Questions

## Introduction

## Background

- Approx. 500,000 commercial buildings in Canada [1]
- 135 fire related deaths per year from 2010-2014 in Canada [2]
- High Earthquake Potential on Canadian West Coast
- Modernize safety in urban/industrial environments
⇀ Complex urban structures
⇀ More buildings & people in smaller areas
⇀ Navigation in these areas is more difficult in emergencies
Introduction | Market Analysis | Technical Overview | Risk Assessment | Standards | Reflection | Summary

## Motivation

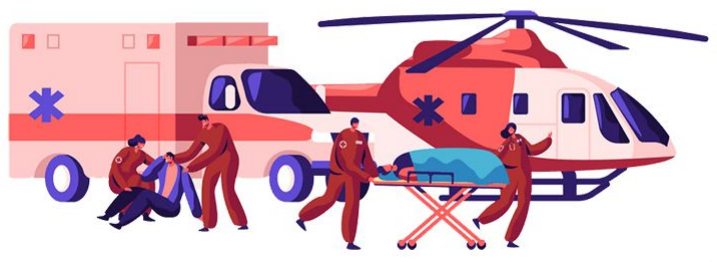
[picture p105: figure]

Introduction | Market Analysis | Technical Overview | Risk Assessment | Standards | Reflection | Summary

Optimizing Emergency Response
- Limited information on scene
- Victim location based on witness accounts
- Unreliable and high tendency of human error
- What happens when disaster strikes? Increase Safety & Efficiency
- More reliable information
- Better path planning
- Limit human error
- Safer for first responders

## Indoor Positioning Systems (IPS) Attributes [3]

✓ System accuracy and precision

✓ Coverage and resolution

✓ Latency in making location updates

✓ Building’s infrastructure impact

✓ Effect of error/interference on the system

Introduction | Market Analysis | Technical Overview | Risk Assessment | Standards | Reflection | Summary

## Akriveia Beacon System

- Indoor Positioning System (IPS)
- Designed for Disaster Search & Rescue Operations
- System of Anchor Beacons and Wearable ID Tags
- Integrated with Advance Ultra-Wideband (UWB) Technology
- Trilateration Methods for Tracking
- Near Real-Time Indoor Tracking
Introduction | Market Analysis | Technical Overview | Risk Assessment | Standards | Reflection | Summary

## Business & Cost Analysis

## Global Market & Competitors

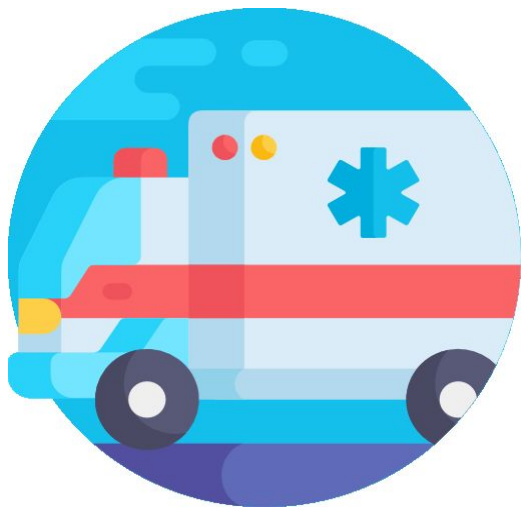
[picture p106: figure]

- Search and Rescue (SAR) Equipment Market ⇀ In 2017: $113.62 billion [4]
⇀ Projected in 2022: $125.66 billion
- Global Indoor Location (GIL) Market
⇀ In 2015: $3.43 billion [5]
⇀ Projected in 2022: $29.4 billion
- No Direct Competitors
⇀ Pozyx, Infsoft, KAUST Innovation

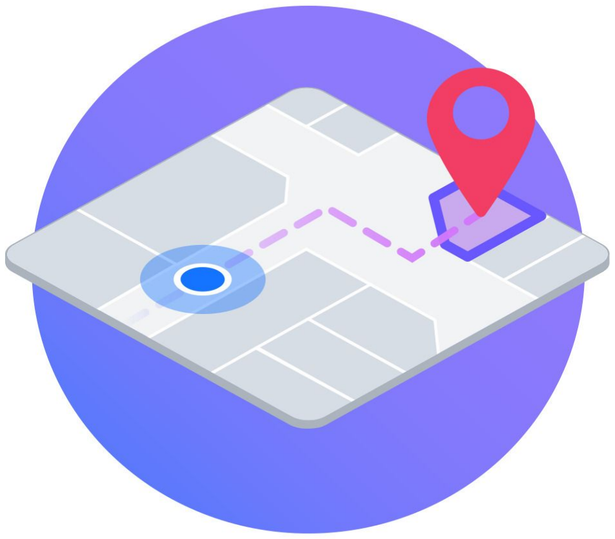
[picture p107: figure]

Introduction | Market Analysis | Technical Overview | Risk Assessment | Standards | Reflection | Summary

## Target Customer

Ideal Customers
- Commercial Building owners
- Property management companies
- Need for GIL for occupants in emergencies
Government Incentives

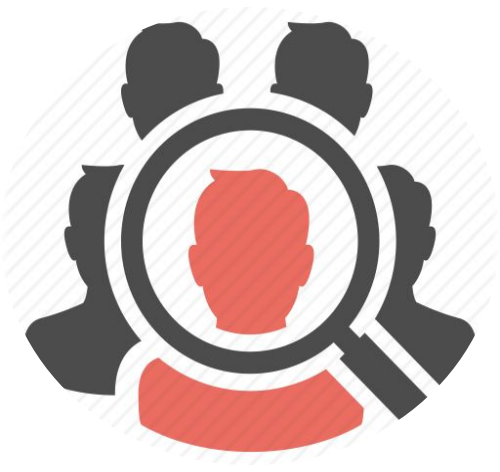
[picture p108: figure]

- System increases occupant safety in emergency situations
- Easily integrated into Building Code - Fire Safety
- Reduces risk to emergency personnel
Introduction | Market Analysis | Technical Overview | Risk Assessment | Standards | Reflection | Summary

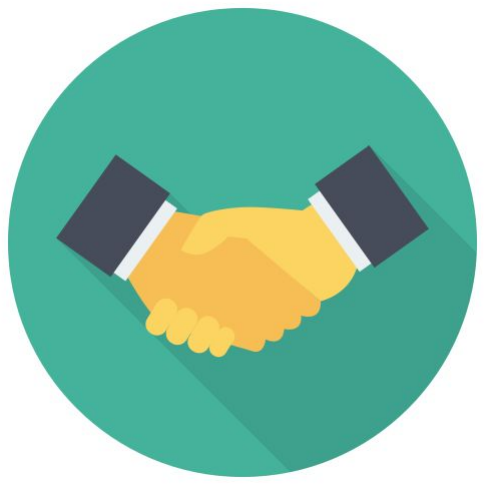
[picture p109: figure]

## Business Plan

Start Up
- OEM - One time sales model with SW subscription
- Sell Directly, No distributor, higher margin
- Build Distributor channel to bring product to market Growth And Expansion
- Acquisition of platforms & tech
- Consideration of other application
- Hospital, Military, Logistics applications Possible Exit
- Initial Public Offering (IPO)
- MBO, MBI
- Acquisition
Introduction | Market Analysis | Technical Overview | Risk Assessment | Standards | Reflection | Summary

## Business Considerations

Strength / Weaknesses
- Unique technology & application
- Adoption in new cellular devices
- Expensive development cost
Opportunities
- Large market in high risk earthquake areas
- No direct competitors or similar application in the market
- High market share
Risks
- Must meet various regulations and standards
- Heavily government regulated
- Requires new regulations to be put in place
12 | Introduction | Market Analysis | Technical Overview | Risk Assessment | Standards | Reflection | Summary

## Production Costs

13 | Introduction | Market Analysis | Technical Overview | Risk Assessment | Standards | Reflection | Summary
| Gamma Prototype | Mass Production
Fixed Cost | $1,000.00 | $24,237.96
Variable Cost Beacon | $127.55 | $36.70
Variable Cost Tag | $74.56 | $22.78
Variable Cost Software | $2,500.00 | $2,500.00
Require Sale Price (80% Return) | $6,530.85 | $5,108.22
Break-Even Point | 1 Units | 6 Unit

## Break-Even Point Calculation

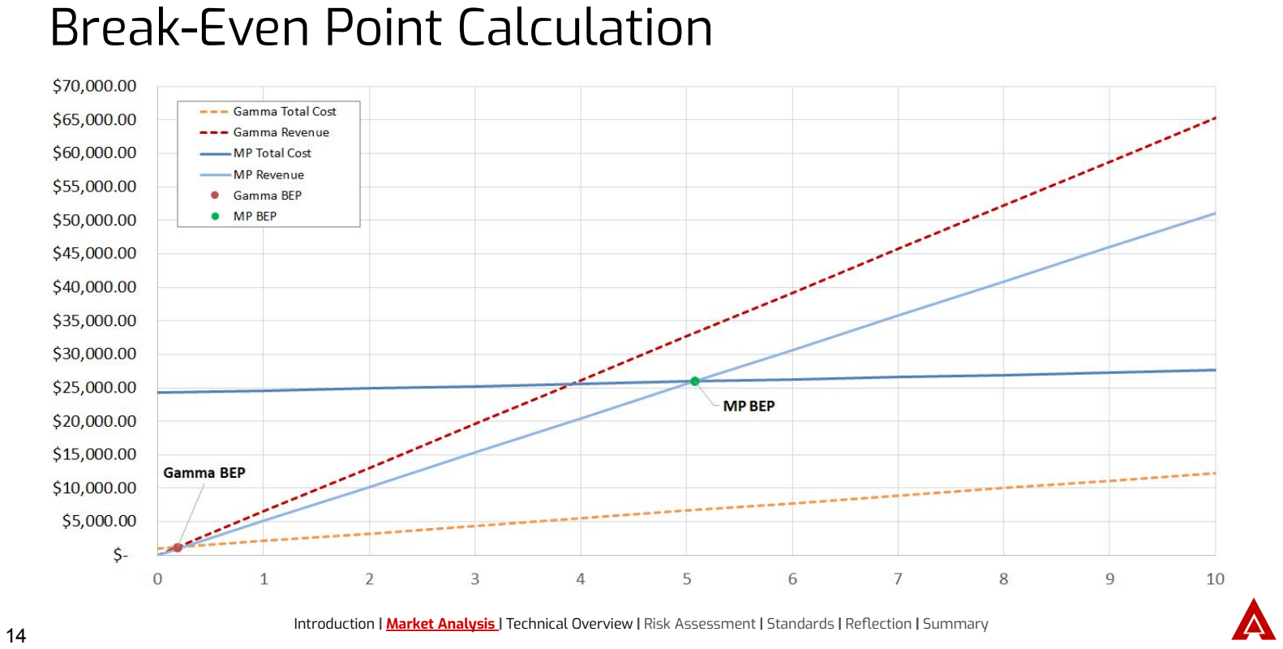
[picture p110: page 14]

14 | Introduction | Market Analysis | Technical Overview | Risk Assessment | Standards | Reflection | Summary

## System Overview

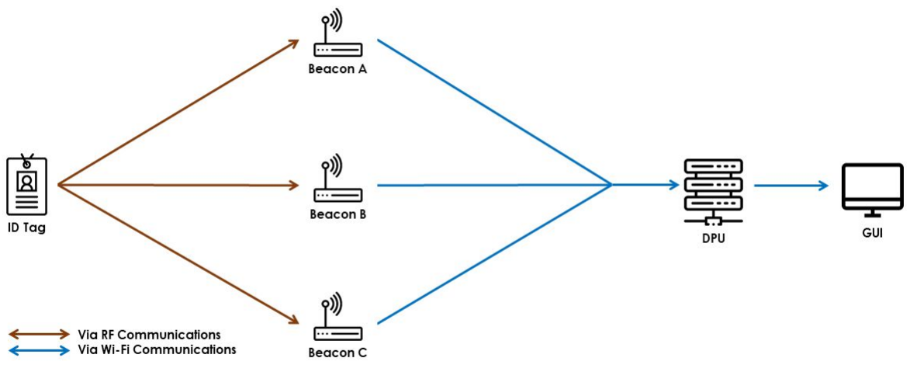
[picture p111: figure]

16 | Introduction | Market Analysis | Technical Overview | Risk Assessment | Standards | Reflection | Summary

## System Layout

## System Components

17 | Introduction | Market Analysis | Technical Overview | Risk Assessment | Standards | Reflection | Summary

Beacons

- Stationary UWB Locator Devices
- Use DWM1000 UWB module for ToF Ranging
- Minimum 3 Beacons is Required
- Communicate with Server using UDP via Private Network
Tags
- Small, Light, durable, and wearable electronic tagging devices
- Integrated with DWM1000 UWB Transceivers
- Integrate with access cards or key fobs for every day carry
- During emergency can be toggled on to broadcast location

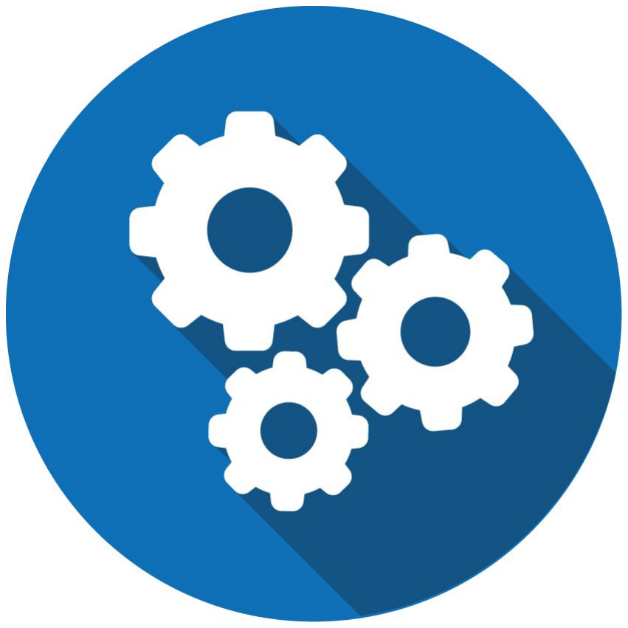
[picture p112: figure]

## Core System Features

18 | Introduction | Market Analysis | Technical Overview | Risk Assessment | Standards | Reflection | Summary
- Track position in near real-time
- High accuracy upto 0.25cm
- Ranging distance upto 30m
- Multi-Tag tracking support
- Multi-Floor Support
- Wireless Beacon-to-Server communication
- Beacon failure prevention & recovery mechanisms
- Intuitive user interface for adding/editing users, beacons, and maps

# RF Ranging & Trilateration

## Ultra-Wideband RF Ranging

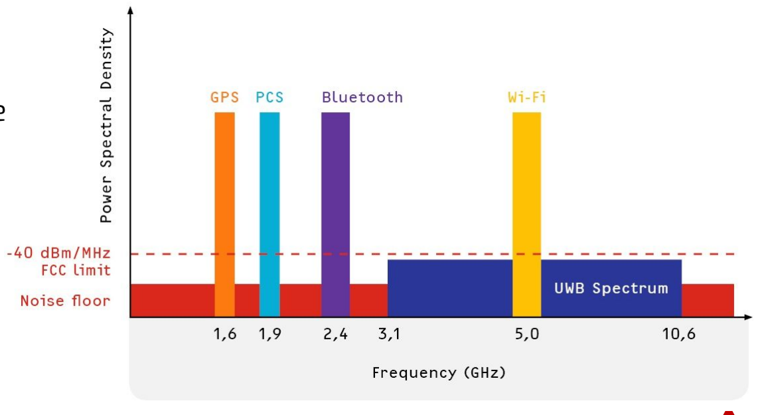
[picture p113: figure]

20 | Introduction | Market Analysis | Technical Overview | Risk Assessment | Standards | Reflection | Summary
- Time-of-Flight based approach
- Minimal interference
- Effective against noise
- Short duration pulses
- Low transmit power
- High data rate

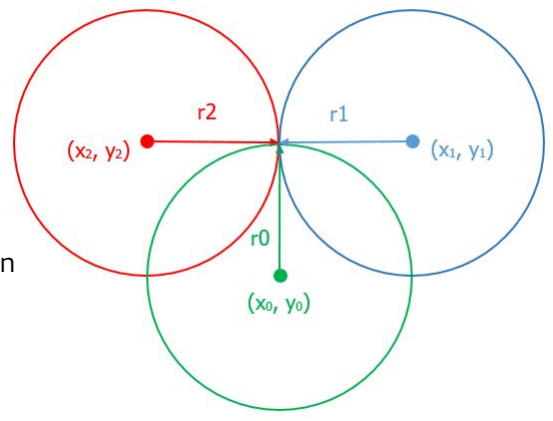
[picture p114: figure]

## Trilateration Method

21 | Introduction | Market Analysis | Technical Overview | Risk Assessment | Standards | Reflection | Summary

Standard Form of a Circle:
(x - x0

)² + (y - y0

)²

= r²
r = distance derived from RF ranging (x0

, y0

) = cartesian coordinates of beacon

Two Dimensional Trilateration: (x - x0

)² + (y - y0

)²
= r0

2
(x - x1

)² + (y - y1

)²
= r1

2
(x - x2

)² + (y - y2

)²
= r2

2

# Software

## Software Overview

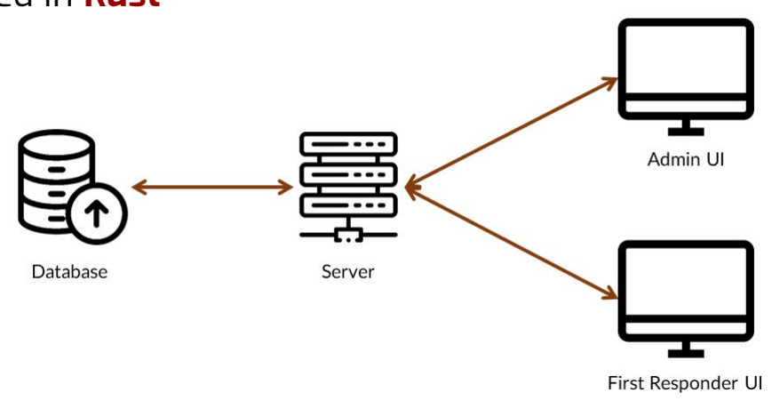
[picture p115: figure]

23 | Introduction | Market Analysis | Technical Overview | Risk Assessment | Standards | Reflection | Summary
- HTTP Web Server
- Multi-threaded frontend apps & WebAssembly
- Implemented in Rust

## Rust & Software Security

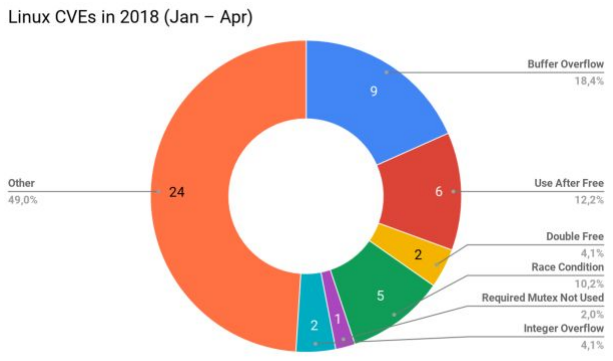
[picture p116: figure]

24 | Introduction | Market Analysis | Technical Overview | Risk Assessment | Standards | Reflection | Summary

Linux Security Vulnerabilities Grouped by Cause [7]

- Standard library
⇀ Security over performance
- Properties of Rust
⇀ No Garbage Collector
⇀ No Race Conditions
⇀ No Buffer Overflow
⇀ No Integer Overflow
⇀ No Double Free
⇀ No Use After Free

# Risks

## Tag Activation

Issue: User unable to turn on tags Solutions: Automatic Tag Activation
- Periodic On/Off
- Fall Detection
- Heart beat sensor
- Oxygen sensor
- Remote Trigger

Privacy issue: Have Tag Broadcast Sound

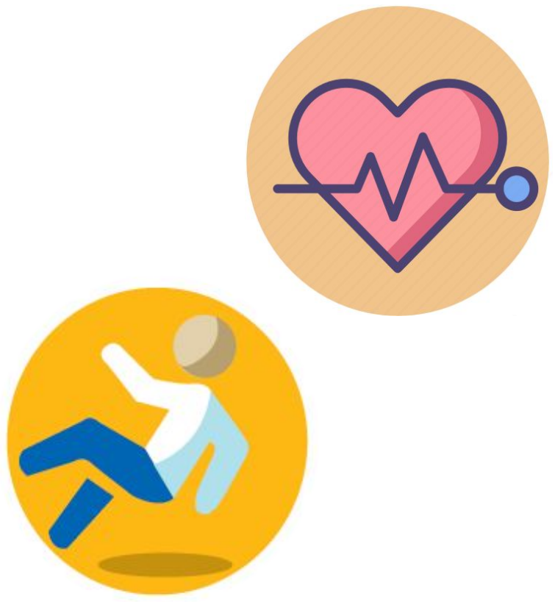
[picture p117: figure]

26 | Introduction | Market Analysis | Technical Overview | Risk Assessment | Standards | Reflection | Summary

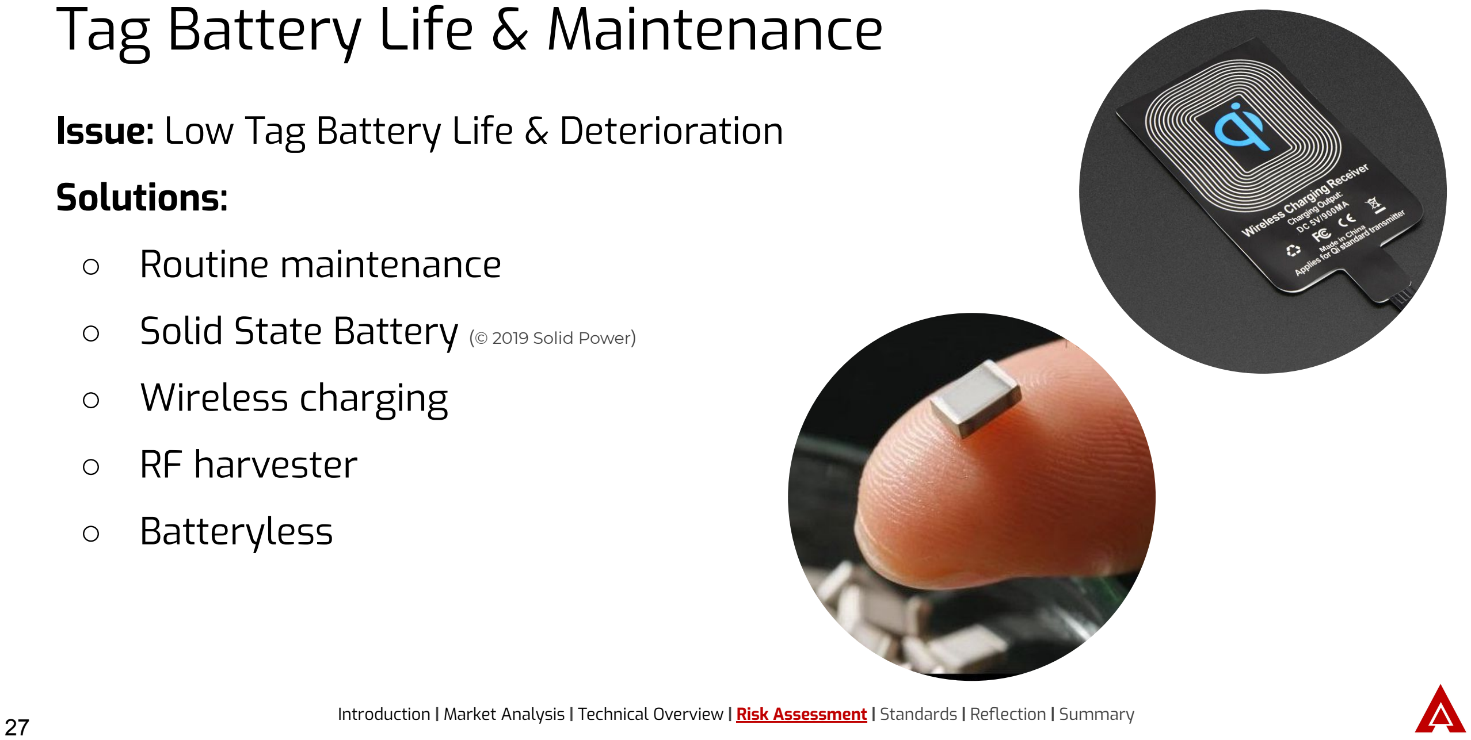
[picture p118: figure]
Tag Battery Life & Maintenance; Solutions: ○ Routine maintenance; ○ Wireless charging ○ RF harvester ○ Batteryless

Issue: Low Tag Battery Life & Deterioration

- Solid State Battery (© 2019 Solid Power)
27 | Introduction | Market Analysis | Technical Overview | Risk Assessment | Standards | Reflection | Summary

## External Hazard

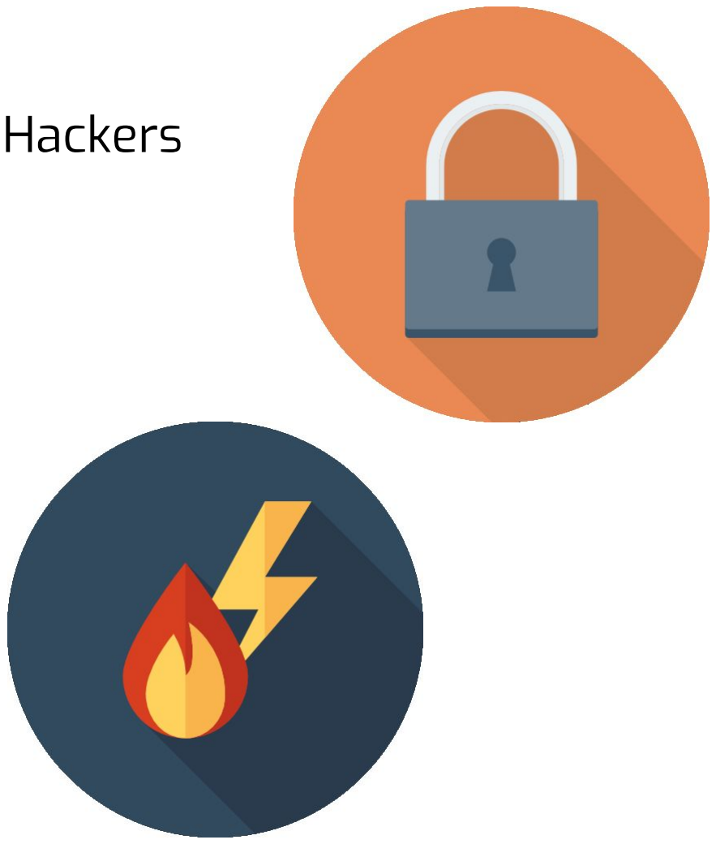
[picture p119: figure]

Issue: Fires, Flood, Gas, Earthquake, Tampering, Hackers Solutions:
- Ingression Protection casing
- Fire Resistant Material
⇀ | Fire safe polymer, fire retardant coating
⇀ | Carbon foam insulation
- Locking mechanism, tamper detection
- Improved Network Security

⇀ PEAP, EAP-TLS

Introduction | Market Analysis | Technical Overview | Risk Assessment | Standards | Reflection | Summary

## Interference Issue

Issue: Multiple UWB devices increases chance of interference on existing systems operating on the UWB spectrum [6]
Solution: Interference Mitigation:
- Modify signal parameters
- Pulse Shape
- Number of pulses
- Off when not used

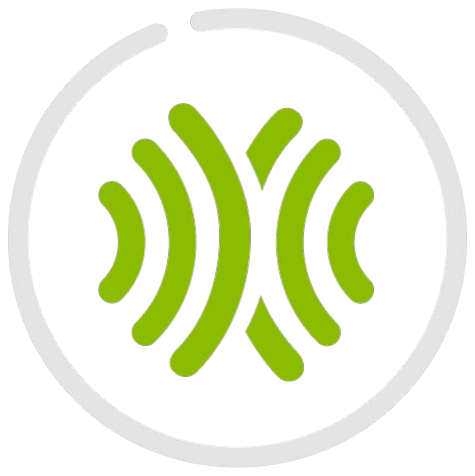
[picture p120: figure]

Introduction | Market Analysis | Technical Overview | Risk Assessment | Standards | Reflection | Summary

# Engineering Standards

## Adherence to Standards

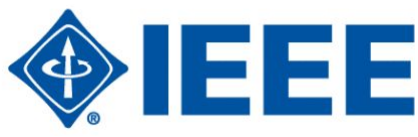
[picture p121: figure]

Factors to consider:

1. UWB in commercial environments

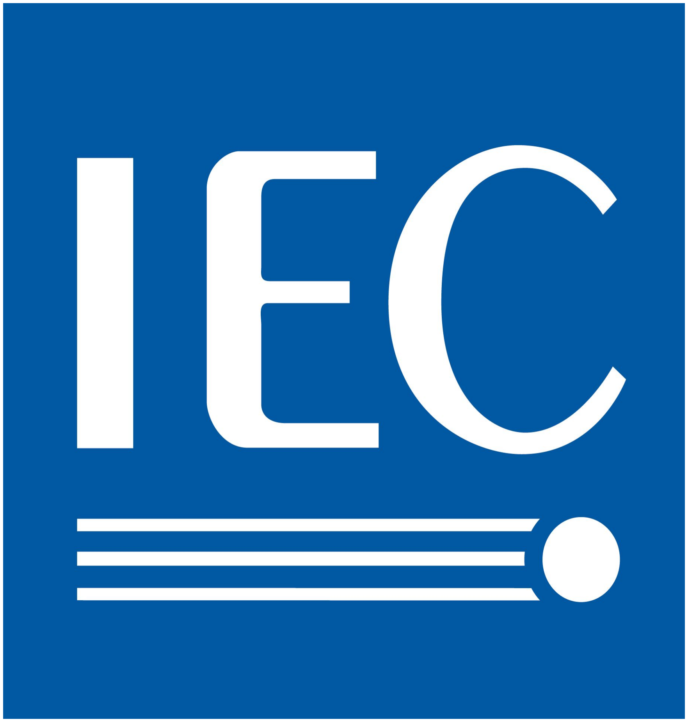
[picture p122: figure]
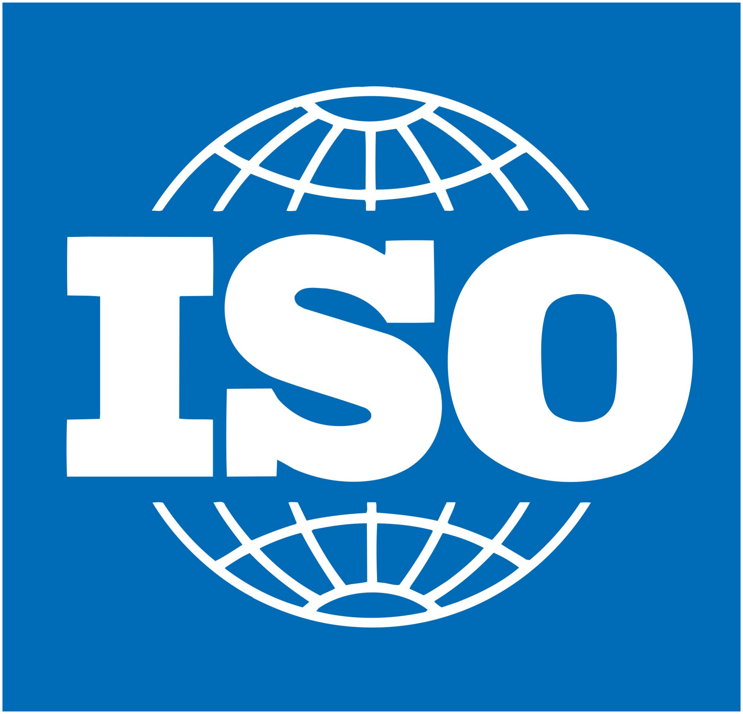
[picture p123: figure]

2. Wearable RF Technologies
3. Software Security & Design

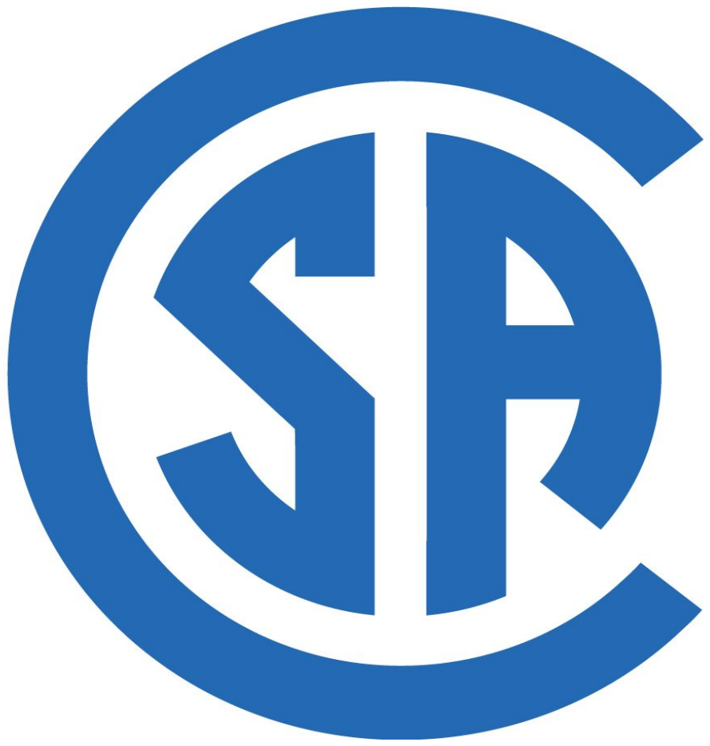
[picture p124: figure]

4. Emergency Equipment Standards
31 | Introduction | Market Analysis | Technical Overview | Risk Assessment | Standards | Reflection | Summary

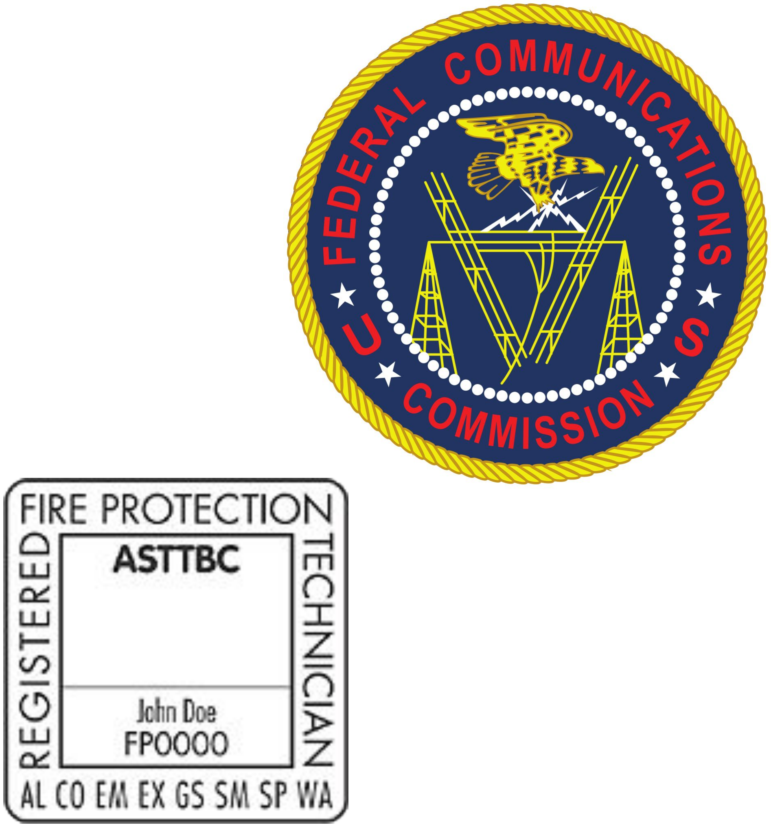
[picture p125: figure]

## Requirements & Regulations

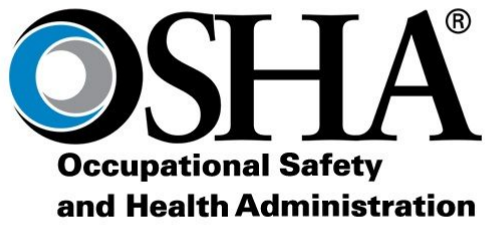
[picture p126: figure]

32 | Introduction | Market Analysis | Technical Overview | Risk Assessment | Standards | Reflection | Summary
- Relies on government regulation to deploy
- Need mix of existing and specific standards
- OSHA Placement & Signage requirements
- ASTTBC certification
- FTP, FSS Code & Material Standards
- FCC Wireless Equipment Requirements (US)

# Self Reflection

## Insights

- Success from the project depends on the Team
- Clear communication is critical
- Execution is vital to success
- Good use of online collaboration - GitLab
- Overall our team’s skills and attitudes complement each other
34 | Introduction | Market Analysis | Technical Overview | Risk Assessment | Standards | Reflection | Summary

# Concluding Remarks

# Future Development

## Integrated PCB

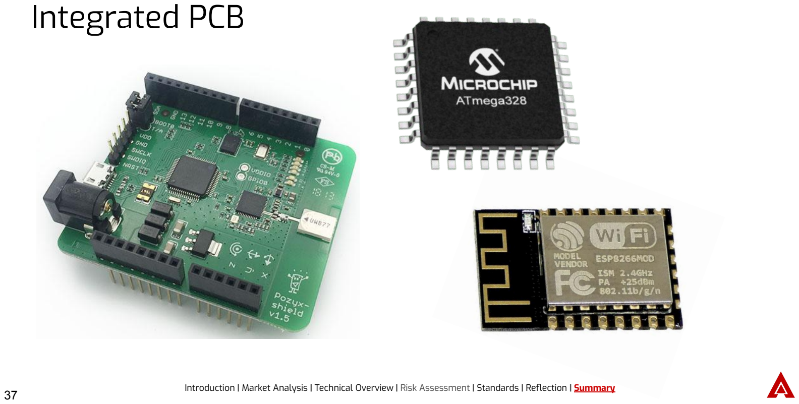
[picture p127: page 37]

37 | Introduction | Market Analysis | Technical Overview | Risk Assessment | Standards | Reflection | Summary

## RF Harvester & Powercaster

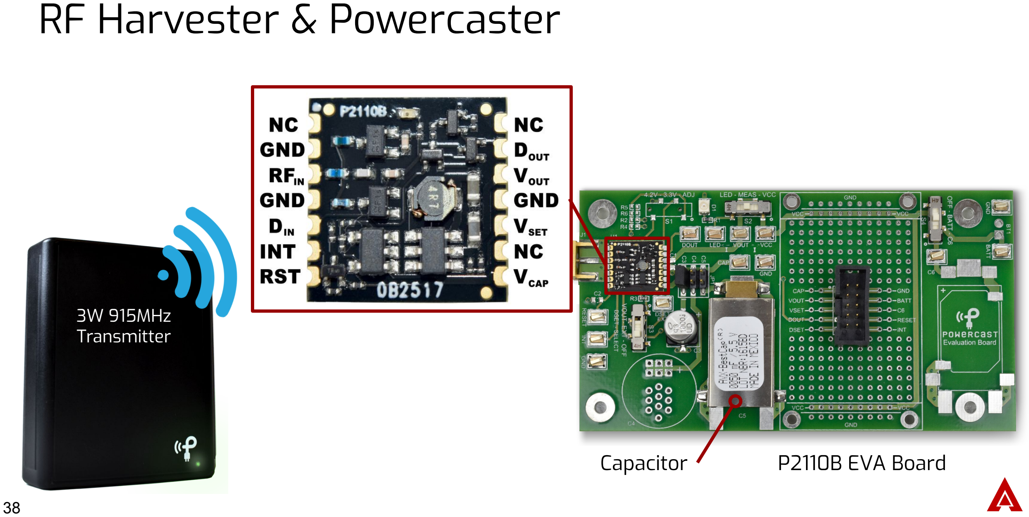
[picture p128: page 38]

3W 915MHz
Transmitter
Capacitor | P2110B EVA Board

## Wi-Fi Mesh

- Decentralized Network
- Reliable Data Transfer
- Wider Coverage
- Lower Risk of Failure
- Require Better Hardware
- Implementation Complexity

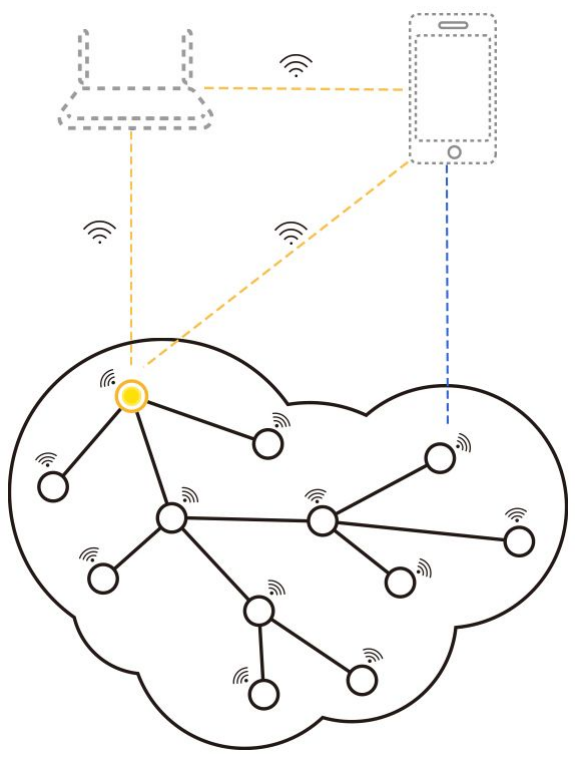
[picture p129: figure]

Introduction | Market Analysis | Technical Overview | Risk Assessment | Standards | Reflection | Summary

## Cloud Management System

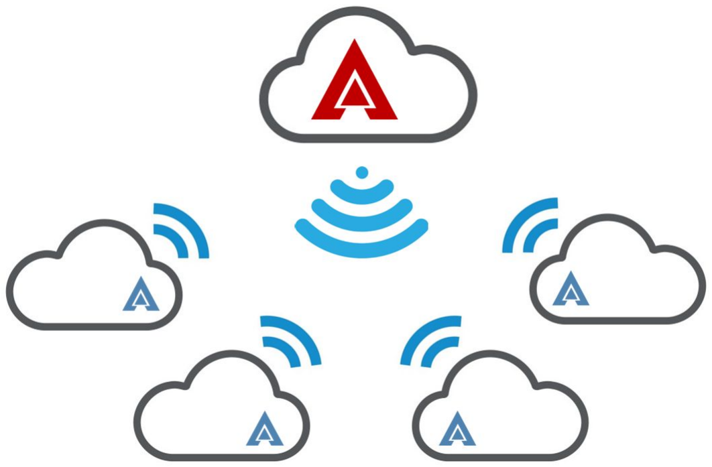
[picture p130: figure]

40 | Introduction | Market Analysis | Technical Overview | Risk Assessment | Standards | Reflection | Summary

## Acknowledgements

Quick Thank you to:

- Scott’s Dad (Retired Firefighter/Fire Prevention)
- Ryne’s Girlfriend’s Dad (Fire Chief)
- Raymond Messier (North Shore SAR)
- Royce Ng (Amazon Warehouse Safety/SAR)
41 | Introduction | Market Analysis | Technical Overview | Risk Assessment | Standards | Reflection | Summary

# Demo

# Questions?

## References

[1] Statistics Canada. Survey of Commercial and Institutional Energy Use, 2014. [online] Available at: https://www150.statcan.gc.ca/n1/daily-quotidien/160916/dq160916c-eng.htm [Accessed 26 July. 2019].
[2] Statistics Canada, "Fire-related deaths and persons injured, by type of structure", Www150.statcan.gc.ca, 2019. [Online]. Available: https://www150.statcan.gc.ca/t1/tbl1/en/tv.action?pid=3510019501. [Accessed: 26- July- 2019].
[3] S. A.-H. M. A.-A. A. Alarifi A. Al-Salman M. Alsalem A. Alnafessah and H. Al-Khalifa. (2016) Ultra wideband indoor positioning technologies: Analysis and recent advances. [Online] Available: https://www.ncbi.nlm.nih.gov/pmc/articles/PMC4883398/pdf/sensors-16-00707.pdf.[Accessed:14-Jun-2019]
[4] BusinessWire. (2017) Elbit systems, general dynamics corporation, honeywell, leonardo ... - research and markets. [Online]. Available: [Online]. Available:https://www.businesswire.com/news/home/20170901005591/en/Search-Rescue-SAR-Equipment-Market---Forecast.[Accessed:14-Jun-2019]
[5] Reuters. (2018) Indoor location market 2018 global trends, market share, industry size, growth, opportunities and forecast to 2023. [Online]. Available: [Online].Available:https: //www.reuters.com/brandfeatures/venture-capital/article?id=50849.[Accessed:14-Jun-2019]
[6] UWB and WLAN Coexistence: a Comparison of Interference Reduction Techniques, 2005 [Online] Available at: https://scholarcommons.usf.edu/cgi/viewcontent.cgi?article=1712&context=etd. [Accessed 24 November, 2019]
[7] Philipp Oppermann, The Rust way of OS development, 2018 [Online] Available at: https://phil-opp.github.io/talk-konstanz-may-2018/#1. [Accessed 2 December, 2019]
