liuyal/Akriveia/Documents/Progress_Reviews/ProgressReview5-Bussiness_Pitch.pdf

Jerry Liu (CEO)
Ryne Watterson (CIO)
Keith Leung (CTO)
Jeffery Yeung (CCO)
Scott Checko (COO)


## Presentation Overview

1. Current Market
2. Customer Base
3. Business Plan & Model
4. Sale Model
5. Cost Analysis

## Global Market

- Search and Rescue (SAR) Equipment Market in 2017: $113.62 billion [1]
- Projected in 2022: $125.66 billion
- Global Indoor Location (GIL) Market in 2015: $3.43 billion [2]
- Projected in 2022: $29.4 billion

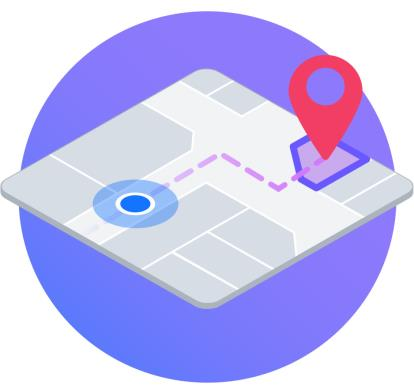
[picture p131: figure]
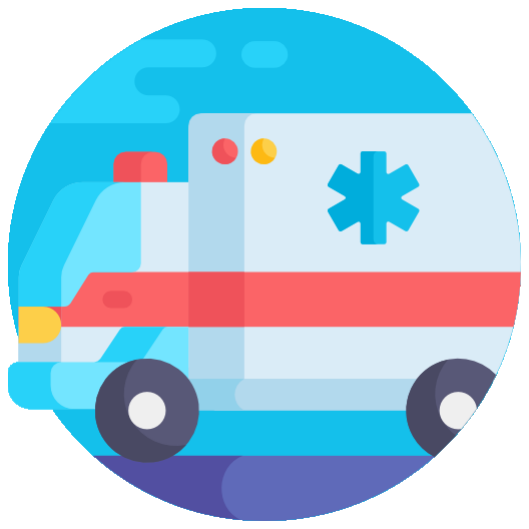
[picture p132: figure]

Introduction | Market Analysis | Technical Overview | Risk Assessment | Standards | Reflection | Summary

## Competition

Same Technology, Different Application

Pozyx | Infsoft | KAUST Innovation
- Production/Logistics
- UWB
- Tag + Node ● Expensive ● Less Features | ● Production/Logistics ● BLE/WiFi ● Mobile Device ● App Based ● Privacy issues | ● Medical & SAR ● UWB ● Handheld Device ● Operator Dependency ● Patented Tech

## Target Customer

Ideal Customers

- Commercial Building owners
- Property management companies
- Need for GIL for occupants in emergencies
Government Incentives

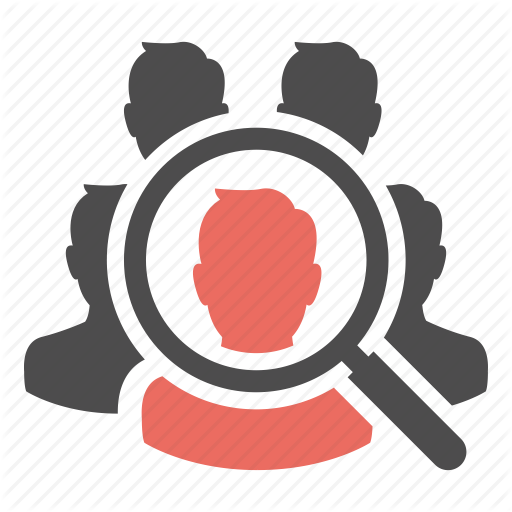
[picture p133: figure]

- System increases occupant safety in emergency situations
- Easily integrated into Building Code - Fire Safety
- Reduces risk to emergency personnel

## Business Plan

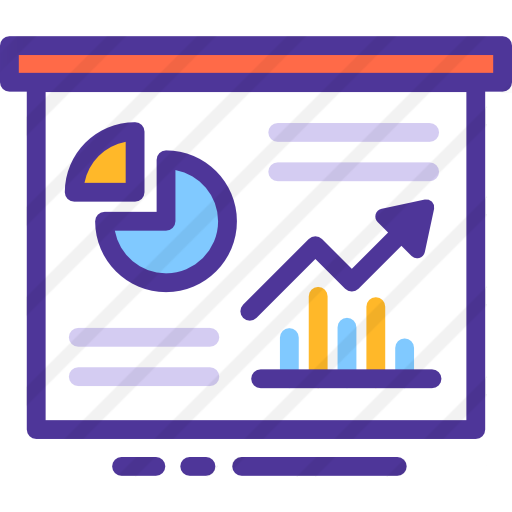
[picture p134: figure]

- Start Up
- OEM - Original Equipment Manufacturer
- Sell Directly, No distributor, higher margin
- Build Distributor channel to bring product to market
- Growth And Expansion
- Acquisition of other platforms & tech to improve service
- Consideration of other application
- Hospital, Military, Logistics applications
- Possible Exit
- Initial Public Offering (IPO)
- MBO. MBI, Acquisition

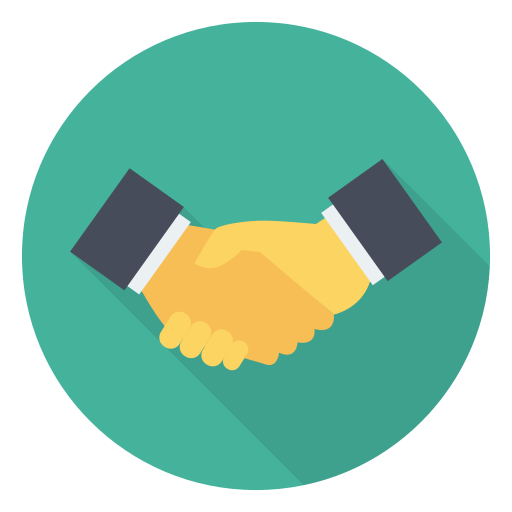
[picture p135: figure]

## Business Model

- Strength
- Unique Technology and Application
- Adoption in New Technologies
- Weaknesses
- Expensive Development Cost
- Relies on Government Regulations
- Opportunities
- Areas with High Risk of Earthquake
- No Direct Competitors, High Market Share
- Threats
- Growth in UWB popularity result in RF congestion
- Cost of license of UWB bands

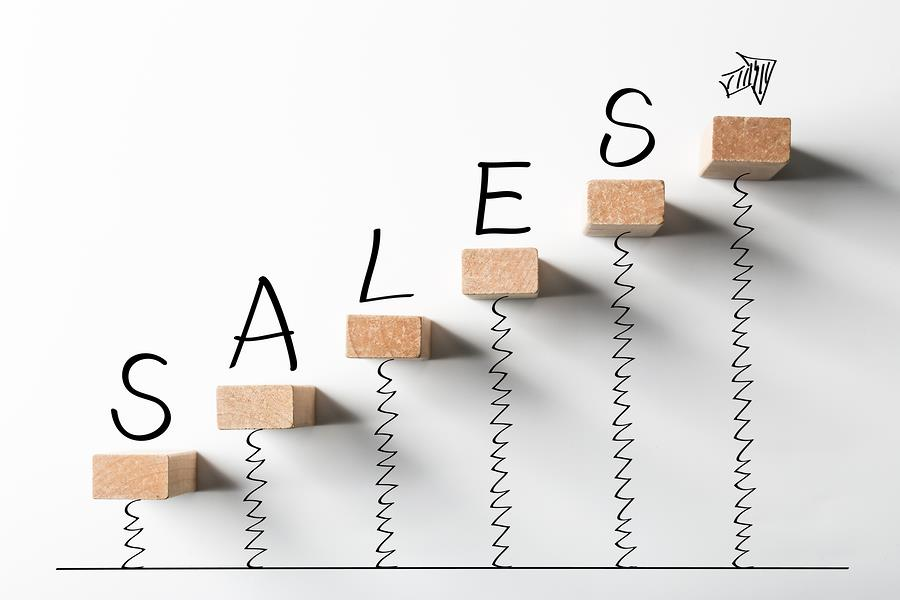
[picture p136: figure]

## Sales Model

- One-Time Sale
- No Contracts = Higher sales
- Appeals to price-sensitive audience
- Inconsistent Revenue Stream
- Cost of servicing after initial sale
- Subscription Based
- Better user experience & up to date service
- Steady Revenue Stream
- Higher maintenance cost
- Requires more work and upkeep for providing service

## Production Costs

Gamma | Mass Production

Fix Cost = $1000.00
Variable Cost
- Beacon = $127.55
- ID Tag = $74.56
Require Sale Price = $1722.81 BEP = 2 Units
| Fix Cost = $24237.96 Variable Cost ● Beacon = $36.70 ● ID Tag = $22.78 Require Sale Price = $734.88 BEP = 62 Units

## Mass Production BEP Calculation

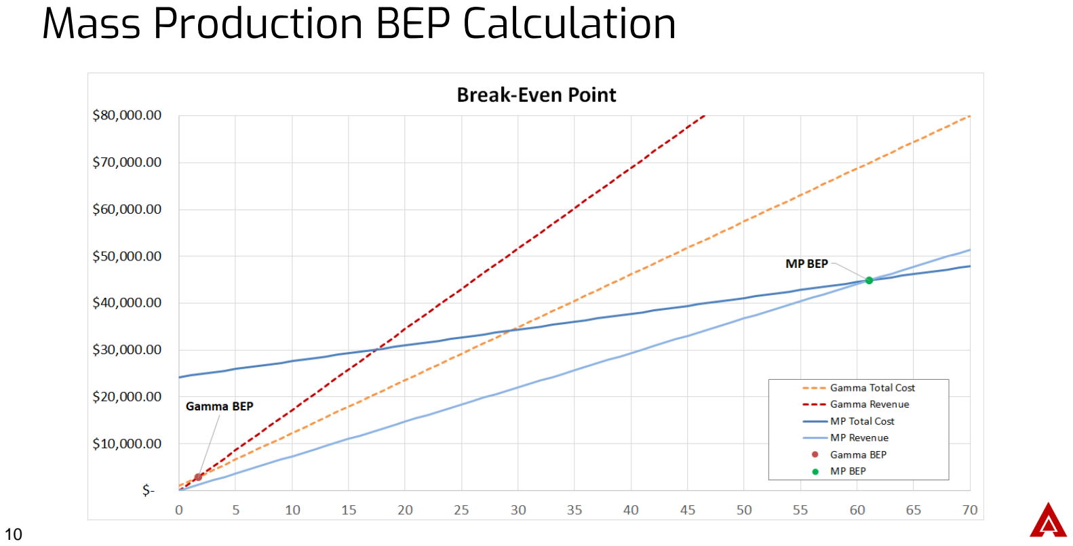
[picture p137: page 10]

## References

1. BusinessWire. (2017) Elbit systems, general dynamics corporation, honeywell, leonardo ... - research and markets. [Online]. Available: [Online].Available:https://www.businesswire.com/news/home/20170901005591/en/ Search-Rescue-SAR-Equipment-Market---Forecast.[Accessed:14-Jun-2019]
2.Reuters. (2018) Indoor location market 2018 global trends, market share, industry size, growth, opportunities and forecast to 2023. [Online]. Available: [Online].Available:https: //www.reuters.com/brandfeatures/venturecapital/article?id=50849.[Accessed:14-Jun-2019]

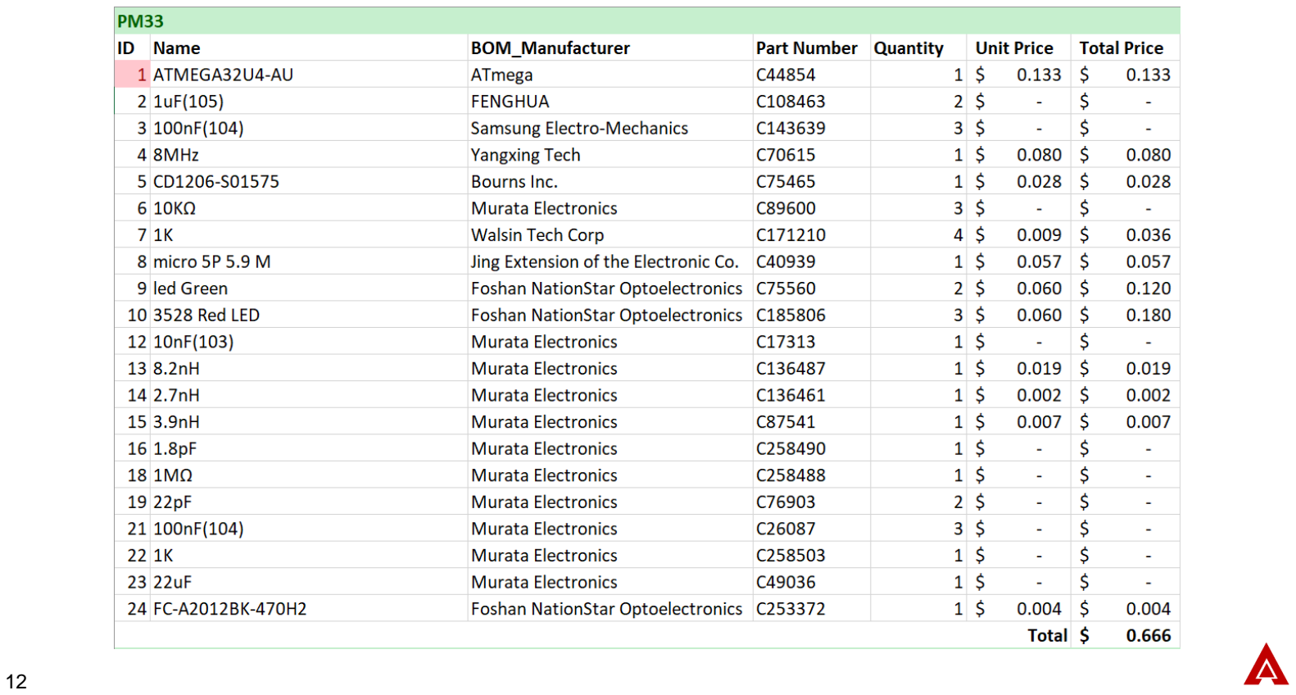
[picture p138: page 12]
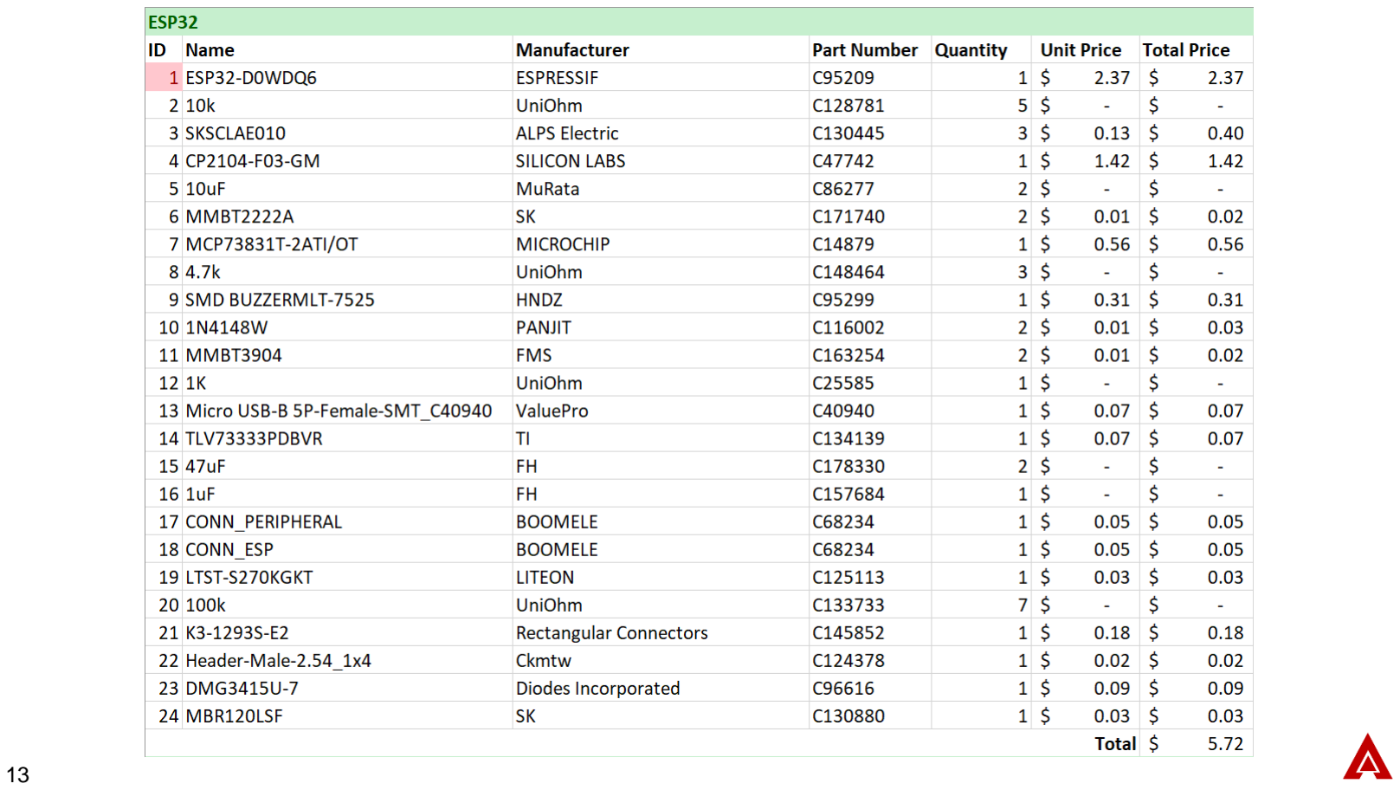
[picture p139: page 13]
