liuyal/Akriveia/Documents/Design_Documents/03_Project_Proposal/images/esp32.jpg

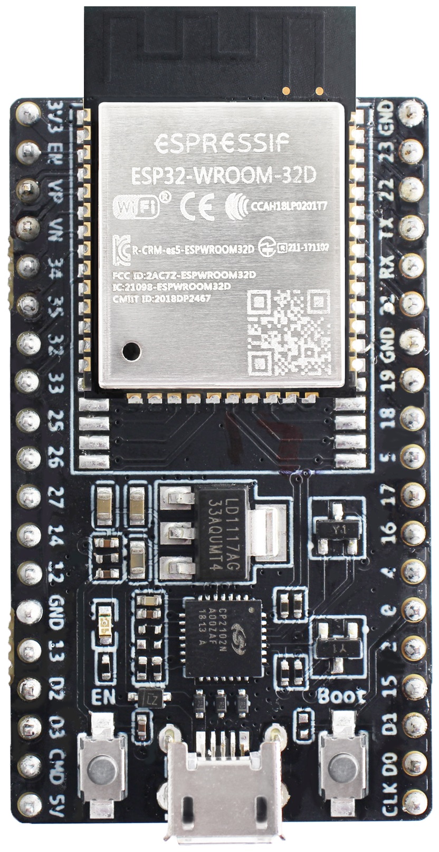
Documents/Design_Documents/03_Project_Proposal/images/esp32.jpg
