liuyal/Akriveia/Documents/Design_Documents/08_Break_Even_Analysis/images/beacon pcb assemb.PNG

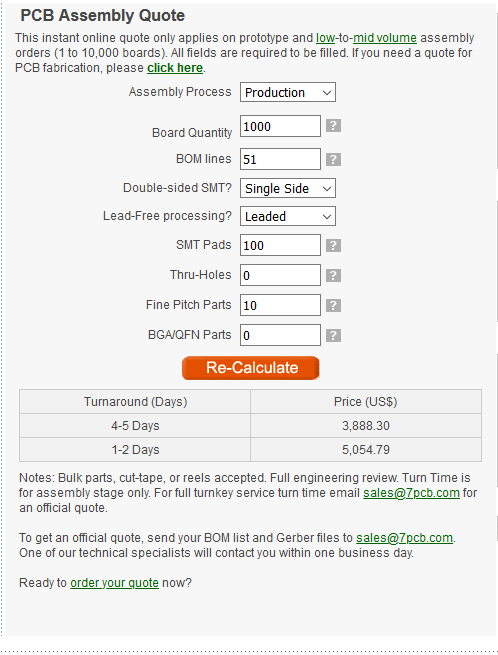
Documents/Design_Documents/08_Break_Even_Analysis/images/beacon pcb assemb.PNG
