liuyal/Akriveia/Documents/Design_Documents/08_Break_Even_Analysis/images/beacon pcb fab.PNG

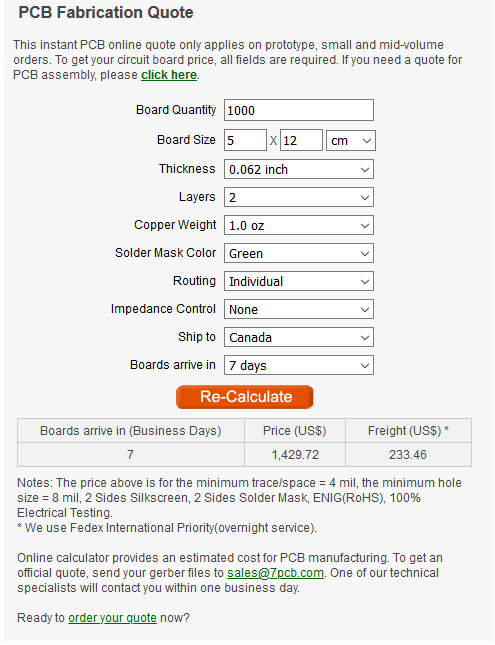
Documents/Design_Documents/08_Break_Even_Analysis/images/beacon pcb fab.PNG
