liuyal/Akriveia/Documents/Project_Files/Capstone_Brainstorm/IMG_20190509_113843.jpg

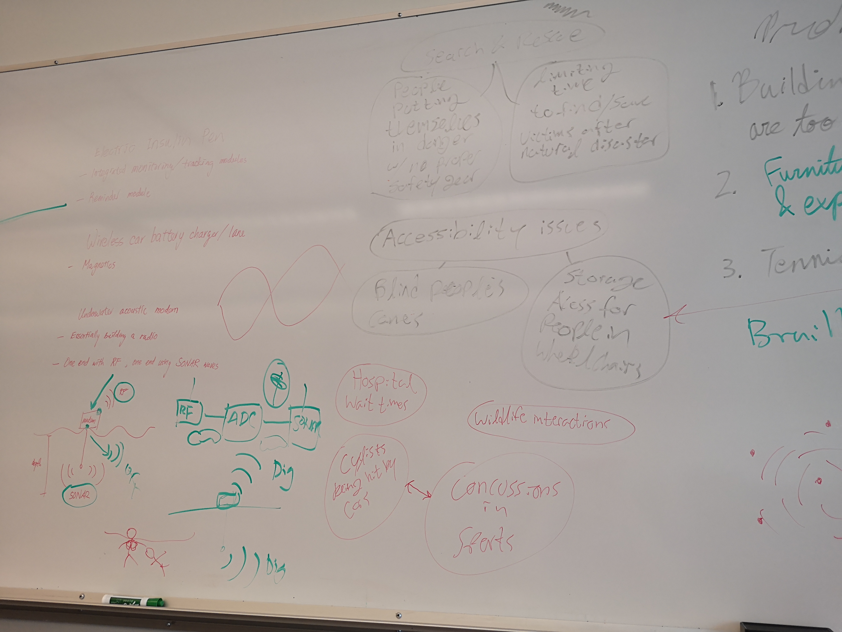
Documents/Project_Files/Capstone_Brainstorm/IMG_20190509_113843.jpg
