liuyal/Akriveia/Documents/Design_Documents/09_440_Presentation_Demo/Demo_Manual/Demo_Manual_Admin.pdf

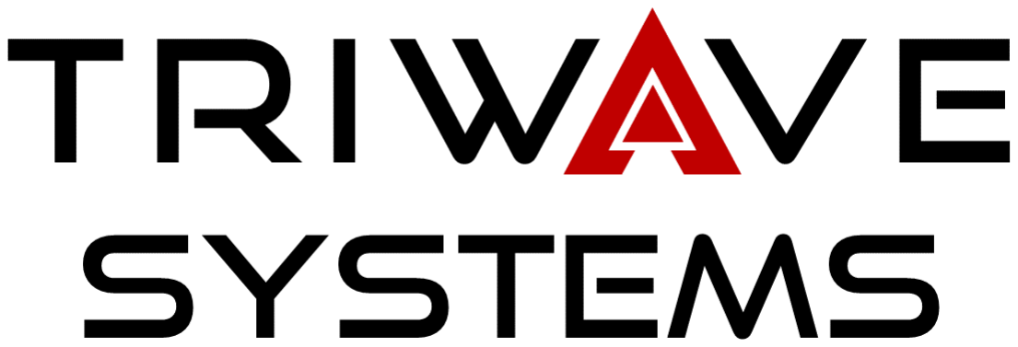
[picture p176: figure]

# Akriveia Beacon

# User Manual Administrator

# SFU

### Table of Content

Table of Figures

2

1. Joining Akriveia Network

3

2. Administrator Configuration

5

2.1 Admin Login

5

2.2 Add Beacon

6

2.3 Add User

8

2.4 Add Map | 10
2.5 Assign Beacons Placement on Map | 12
3. Admin Commands | 15
3.1 Beacon Commands | 15
3.2 Server Commands | 16

### Table of Figures

Figure 1: Joining Akriveia Access point

| 3
Figure 2: Default Akriveia Server IP & Port
| 3
Figure 3: First Responder Map View
| 4
Figure 4: Last Seen Time Bar
| 4
Figure 5: Admin Login Button
| 5
Figure 6: Admin Login Screen
| 5
Figure 7: Add Beacon Dropdown Button
| 6
Figure 8: Add Beacon Form
| 6
Figure 9: Updated Beacon List
| 7
Figure 10: Add User Dropdown Button
| 8
Figure 11: Add User Form
| 8
Figure 12: Updated User List
| 9
Figure 13: Add Map Dropdown Menu Button | 10
Figure 14: Add Map Form | 10
Figure 15: Select Blue Print Image | 11
Figure 16: Map List | 12
Figure 18: Beacon Placement Form | 12
Figure 19: Beacon Placement Toggle Placement | 13
Figure 20: Updated Beacon Placement on Map | 14
Figure 21: Beacon Status Page With Command
s | 15
Figure 22: System Setting Dropdown Menu | 16
Figure 23: ifconfig Exampl
e | 17

### 1. Joining Akriveia Network

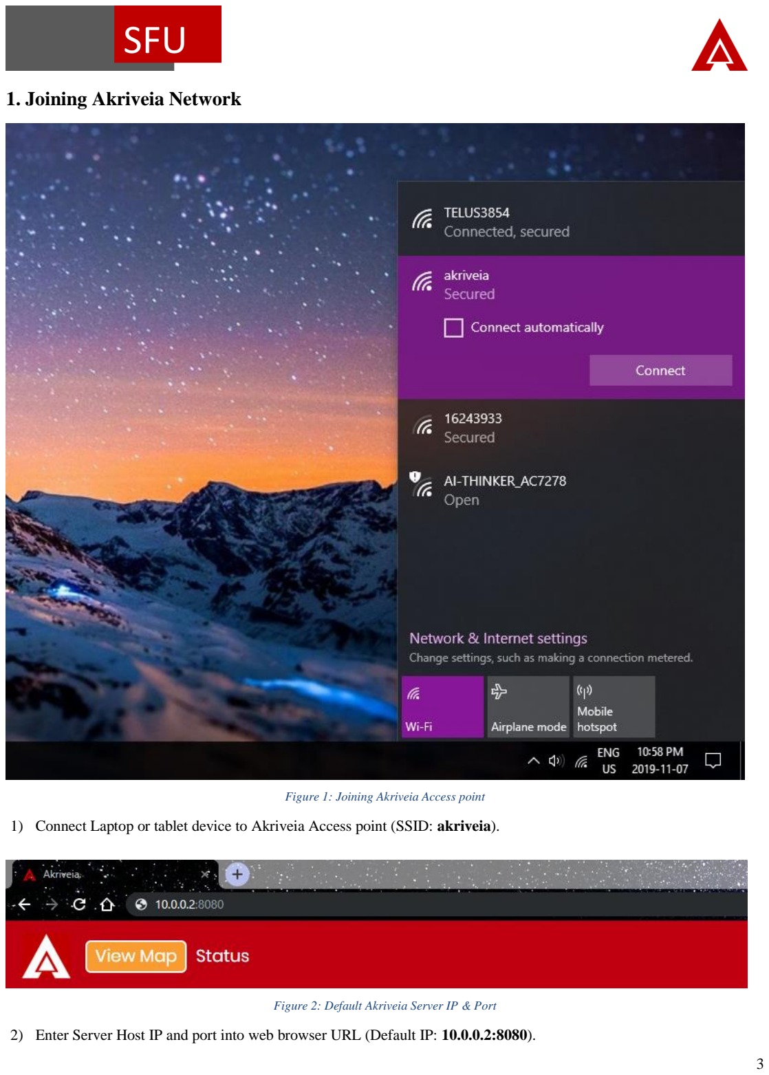
[picture p177: page 3]

Figure 1: Joining Akriveia Access point

1) Connect Laptop or tablet device to Akriveia Access point (SSID: akriveia).

Figure 2: Default Akriveia Server IP & Port

2) Enter Server Host IP and port into web browser URL (Default IP: 10.0.0.2:8080).

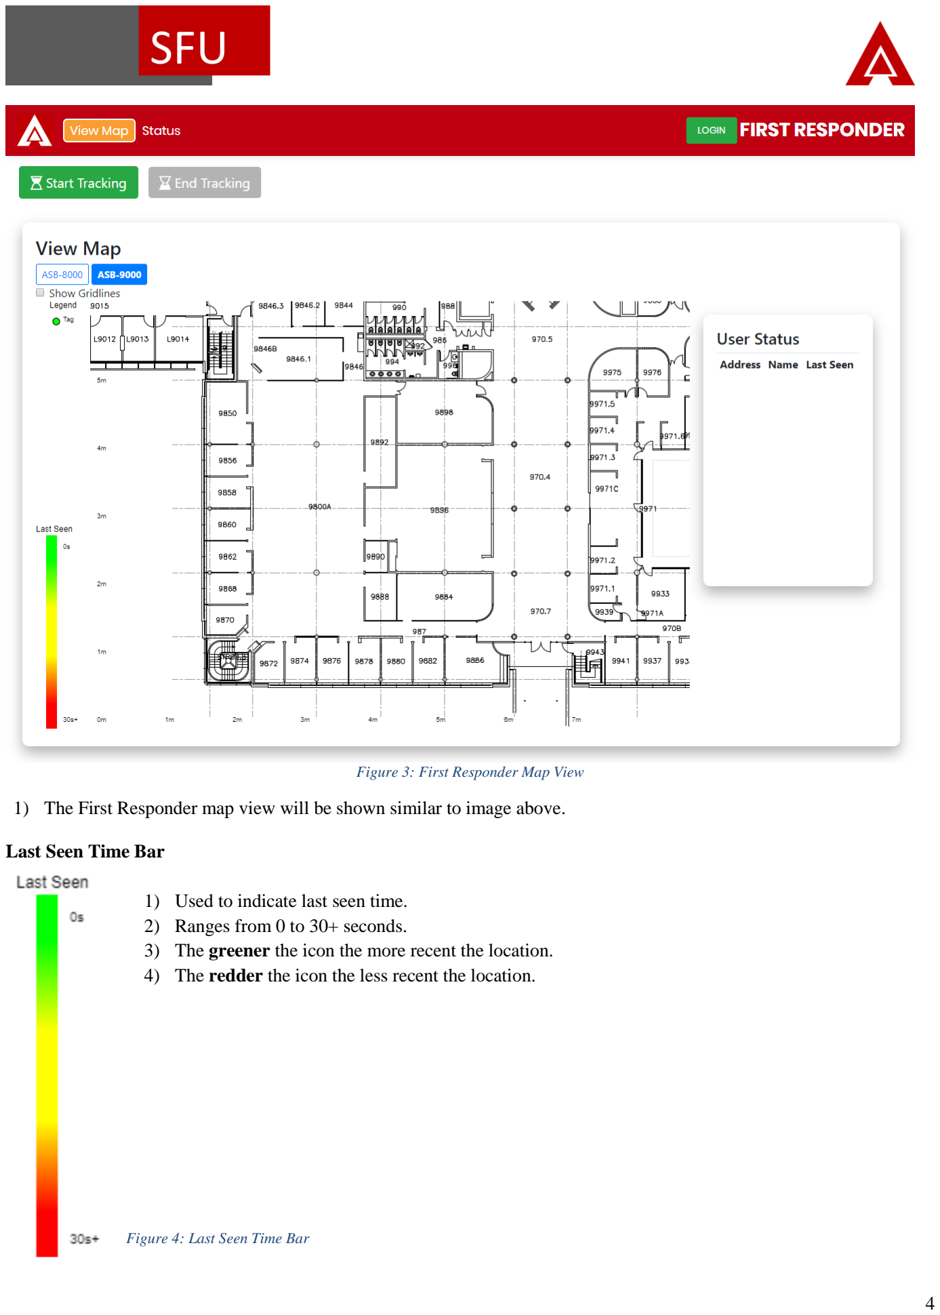
[picture p178: page 4]

Figure 3: First Responder Map View

1) The First Responder map view will be shown similar to image above.

Last Seen Time Bar

1) Used to indicate last seen time.
2) Ranges from 0 to 30+ seconds.
3) The greener the icon the more recent the location.
4) The redder the icon the less recent the location.

Figure 4: Last Seen Time Bar

### 2. Administrator Configuration

### 2.1 Admin Login

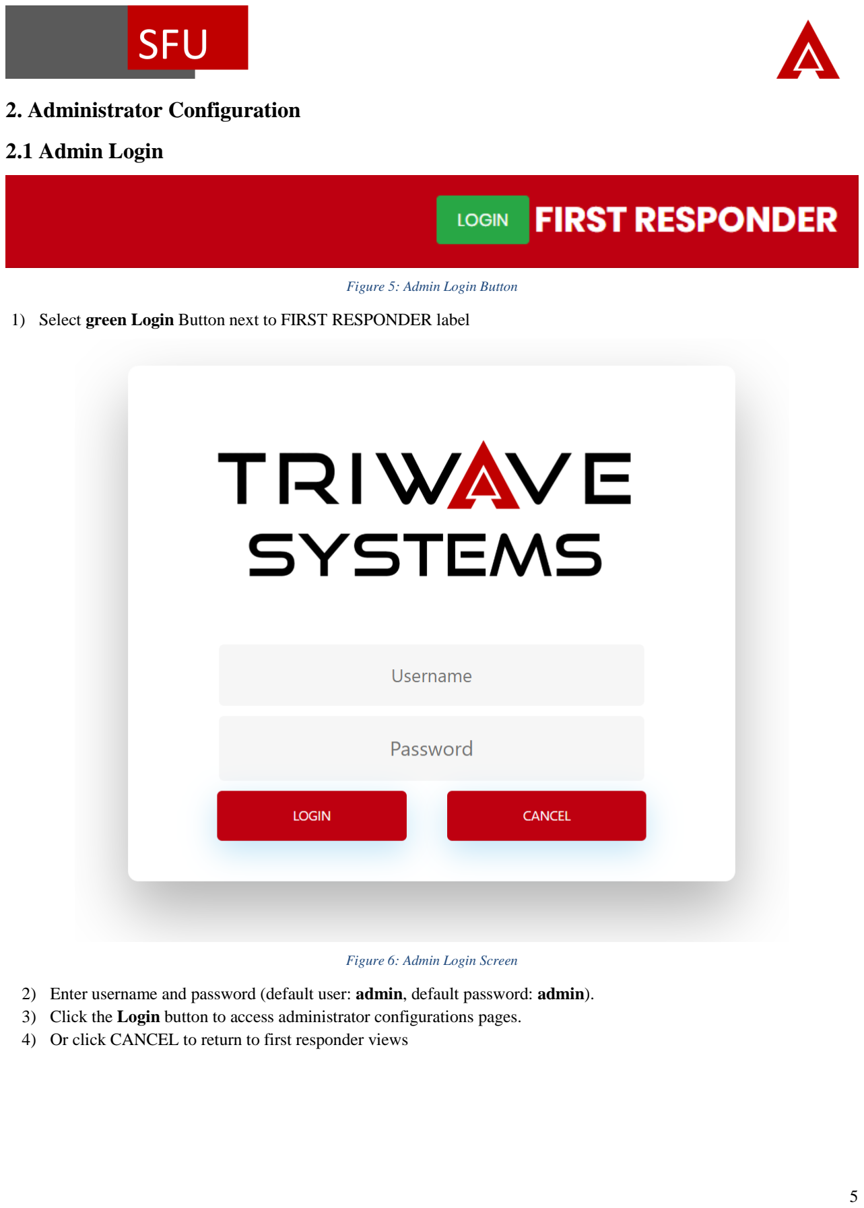
[picture p179: page 5]

Figure 5: Admin Login Button

1) Select green Login Button next to FIRST RESPONDER label

Figure 6: Admin Login Screen

2) Enter username and password (default user: admin, default password: admin).
3) Click the Login button to access administrator configurations pages.
4) Or click CANCEL to return to first responder views

### 2.2 Add Beacon

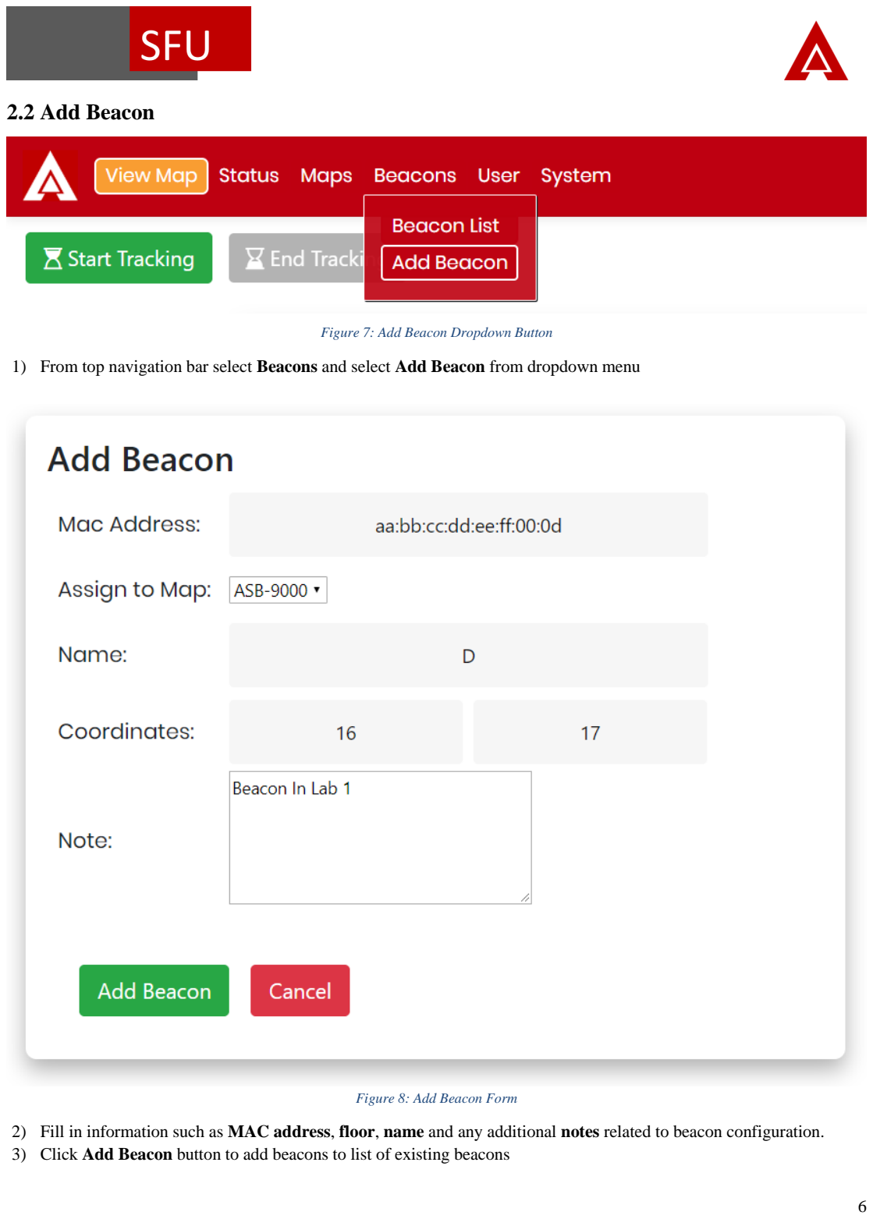
[picture p180: page 6]

Figure 7: Add Beacon Dropdown Button

1) From top navigation bar select Beacons and select Add Beacon from dropdown menu

Figure 8: Add Beacon Form

2) Fill in information such as MAC address, floor, name and any additional notes related to beacon configuration.
3) Click Add Beacon button to add beacons to list of existing beacons

Beacon Fields | Description
Mac Address | Required. The unique Mac Address of the beacon. Address must be a valid hexadecimal encoded 8 byte address in the form 00:00:00:00:00:00:00:00.
Floor Name | Required. Choose the floor the beacon will be located on.
Name | Required. The name of the beacon. This string must be unique across all beacons.
Coordinates | Required. The coordinates of the beacon, relative to the location <0, 0> (bottom left corner) on the chosen map, in meters.
Notes | Optional Notes for Emergency Responders to view during an emergency.

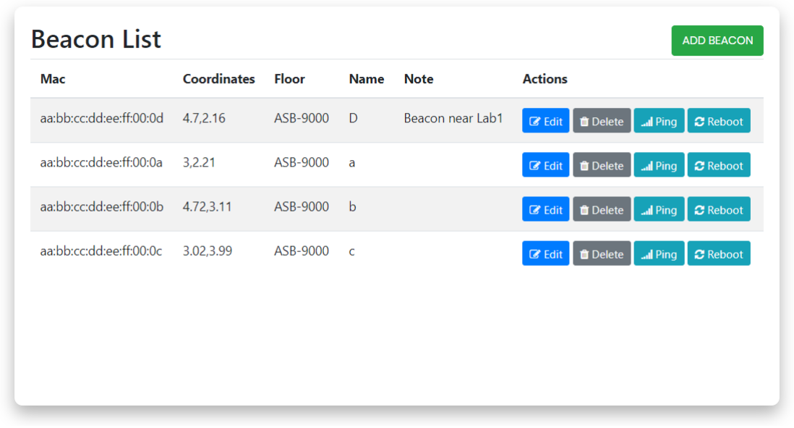
[picture p181: figure]

Figure 9: Updated Beacon List

4) New beacon added will appear under list of beacons (Top Navigation Bar->Beacons).
5) To add more beacons, select the Add Beacon button

### 2.3 Add User

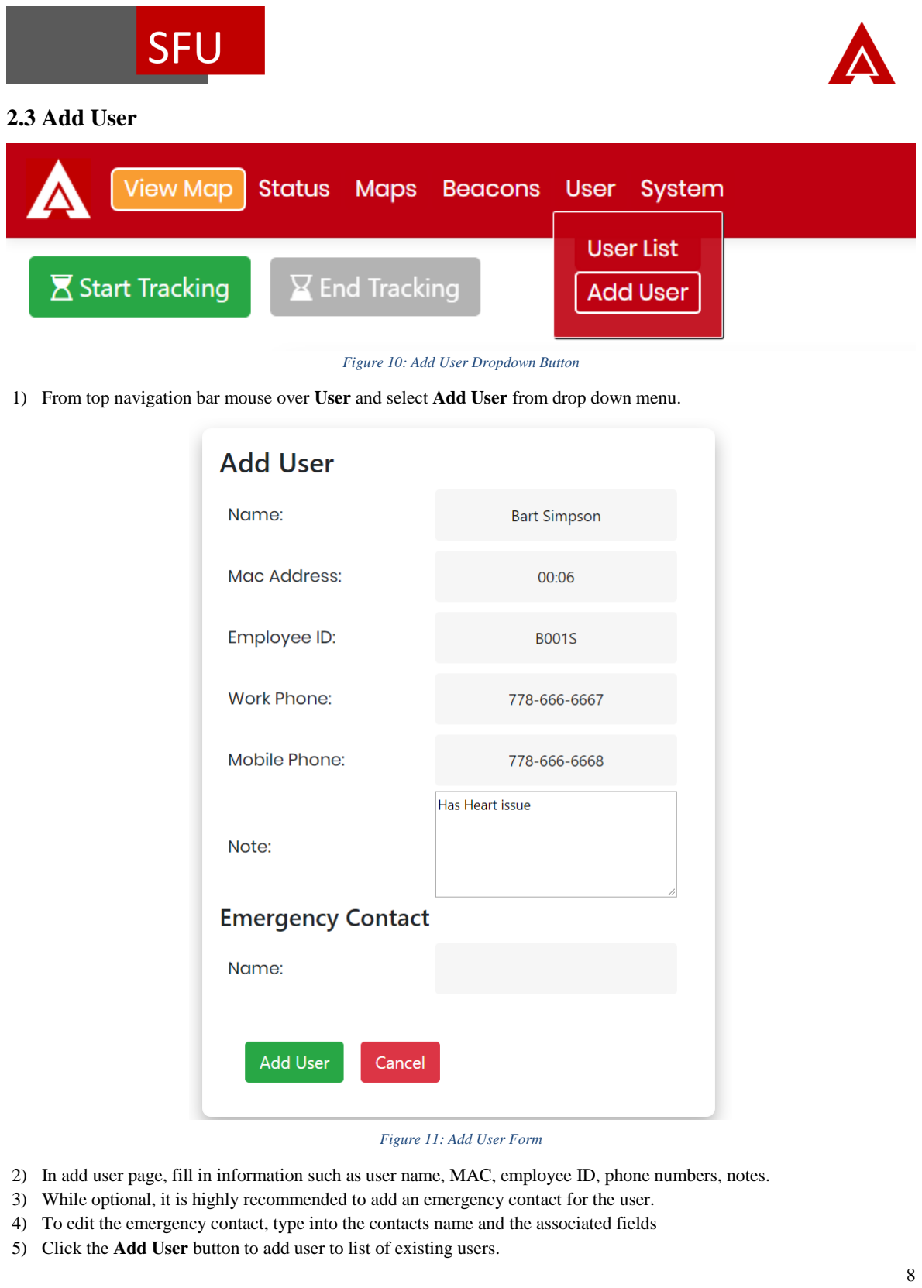
[picture p182: page 8]

Figure 10: Add User Dropdown Button

1) From top navigation bar mouse over User and select Add User from drop down menu.

Figure 11: Add User Form

2) In add user page, fill in information such as user name, MAC, employee ID, phone numbers, notes.
3) While optional, it is highly recommended to add an emergency contact for the user.
4) To edit the emergency contact, type into the contacts name and the associated fields
5) Click the Add User button to add user to list of existing users.

User Fields | Description
Name | Required. The name of the employee.
Mac Address | Required. The unique address of the ID Tag the employee will be wearing. The address must be a valid hexadecimal encoded 2 byte address of the form 00:00,
Employee ID | Optional. The internal company id of the employee if applicable.
Work Phone | Required. The phone number of the employee.
Mobile Phone | Required. The phone number of the employee.
Notes | Optional Notes for Emergency Responders to view during an emergency.
Emergency Contact Fields | Description
Name | Required. The name of the contact.
Employee ID | Optional. The internal company id of the employee if applicable.
Work Phone | Required. The phone number of the employee.
Mobile Phone | Required. The phone number of the employee.
Notes | Optional Notes for Emergency Responders to view during an emergency.

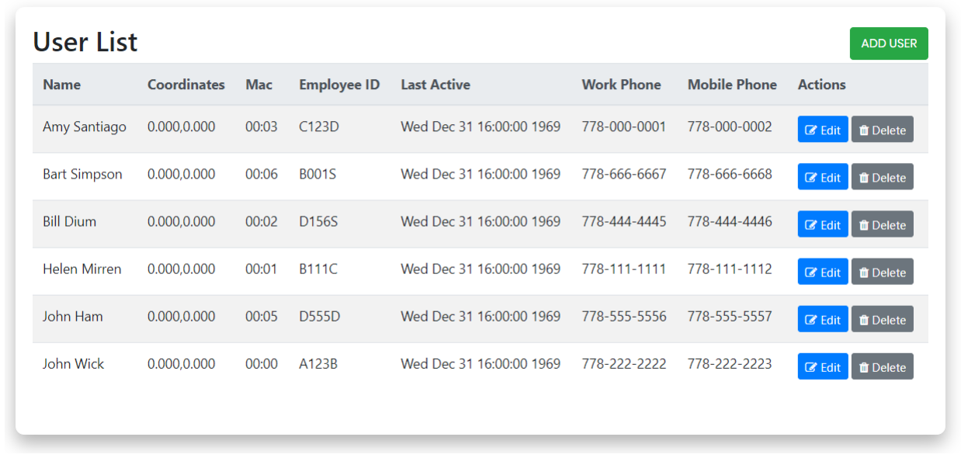
[picture p183: figure]

Figure 12: Updated User List

6) New users will appear under list of beacons (Top Navigation->User).
7) To add more users, click the green Add User button.

### 2.4 Add Map

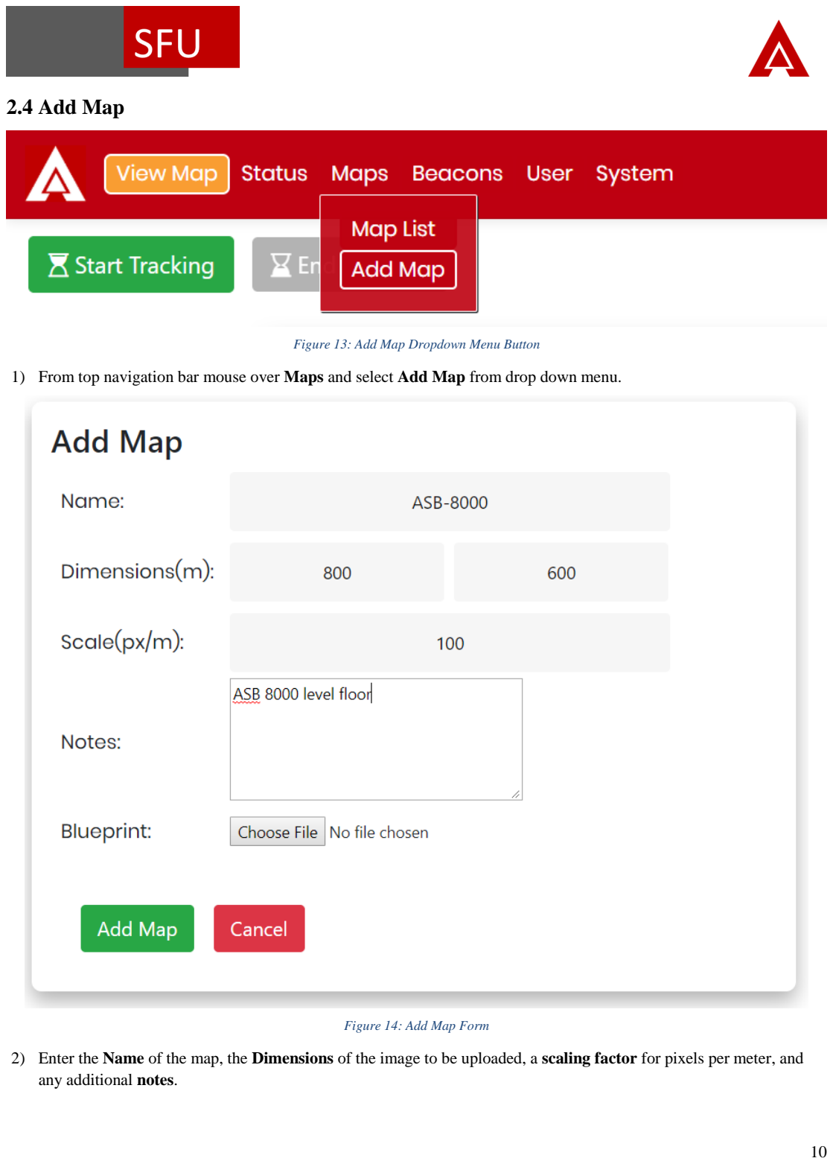
[picture p184: page 10]

Figure 13: Add Map Dropdown Menu Button

1) From top navigation bar mouse over Maps and select Add Map from drop down menu.

Figure 14: Add Map Form

2) Enter the Name of the map, the Dimensions of the image to be uploaded, a scaling factor for pixels per meter, and any additional notes.

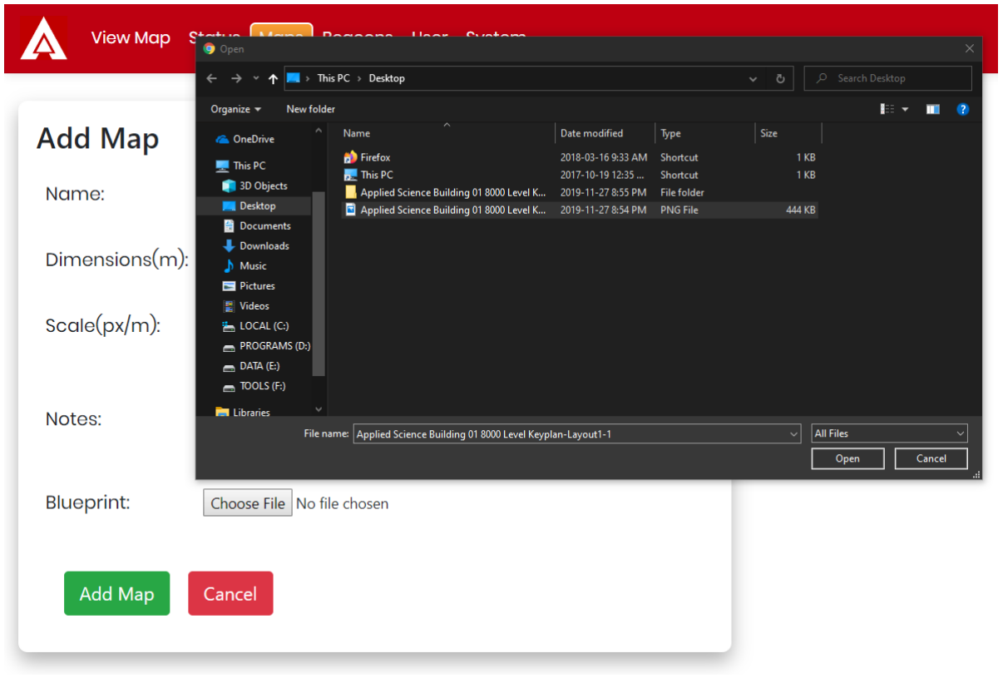
[picture p185: figure]

Figure 15: Select Blue Print Image

3) Click Choose File button and select an image file containing the blueprints or floor plans of the map to be added.
Map Fields | Description
Name | Required. The name of the map.
Bounds | Required. The pixel width and height of the map image.
Scale | Required. The pixel per meter ratio for the map image. Used to convert coordinates in meters to a location on the image.
Notes | Optional. Notes for Emergency Responders to view during an emergency.

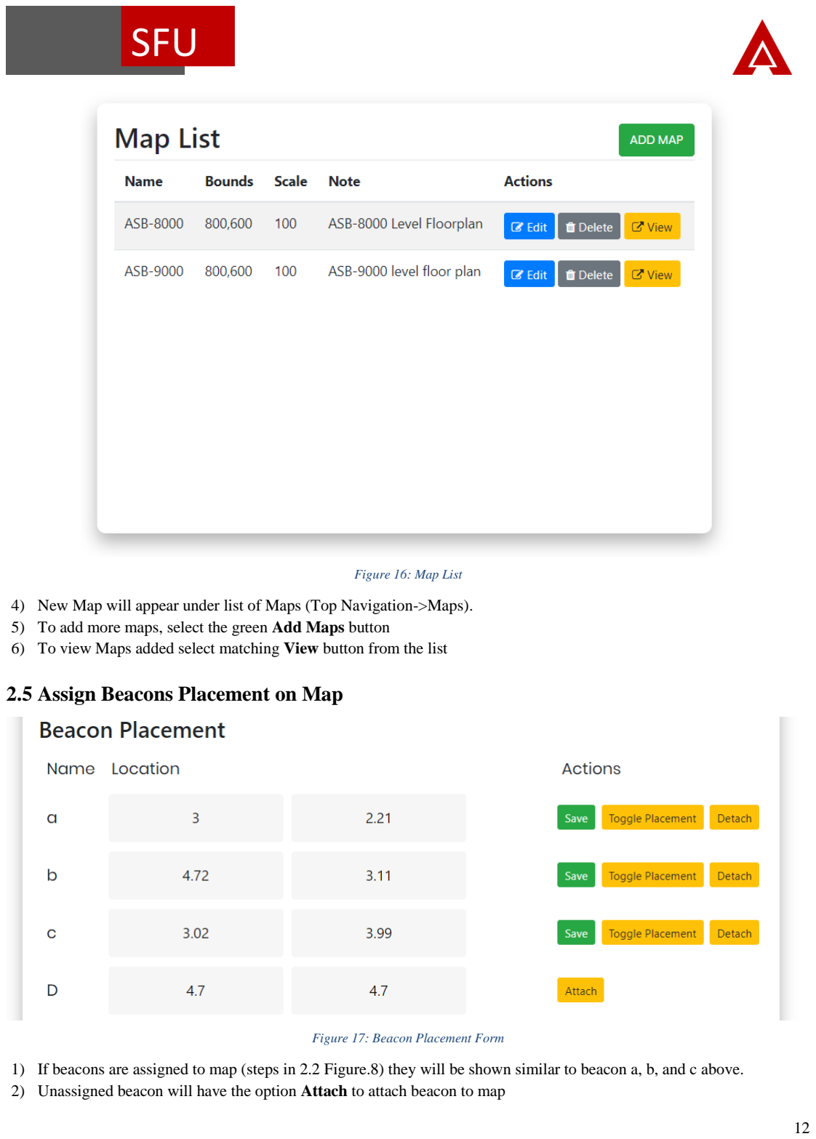
[picture p186: page 12]

Figure 16: Map List

4) New Map will appear under list of Maps (Top Navigation->Maps).
5) To add more maps, select the green Add Maps button
6) To view Maps added select matching View button from the list

### 2.5 Assign Beacons Placement on Map

Figure 17: Beacon Placement Form

1) If beacons are assigned to map (steps in 2.2 Figure.8) they will be shown similar to beacon a, b, and c above.
2) Unassigned beacon will have the option Attach to attach beacon to map

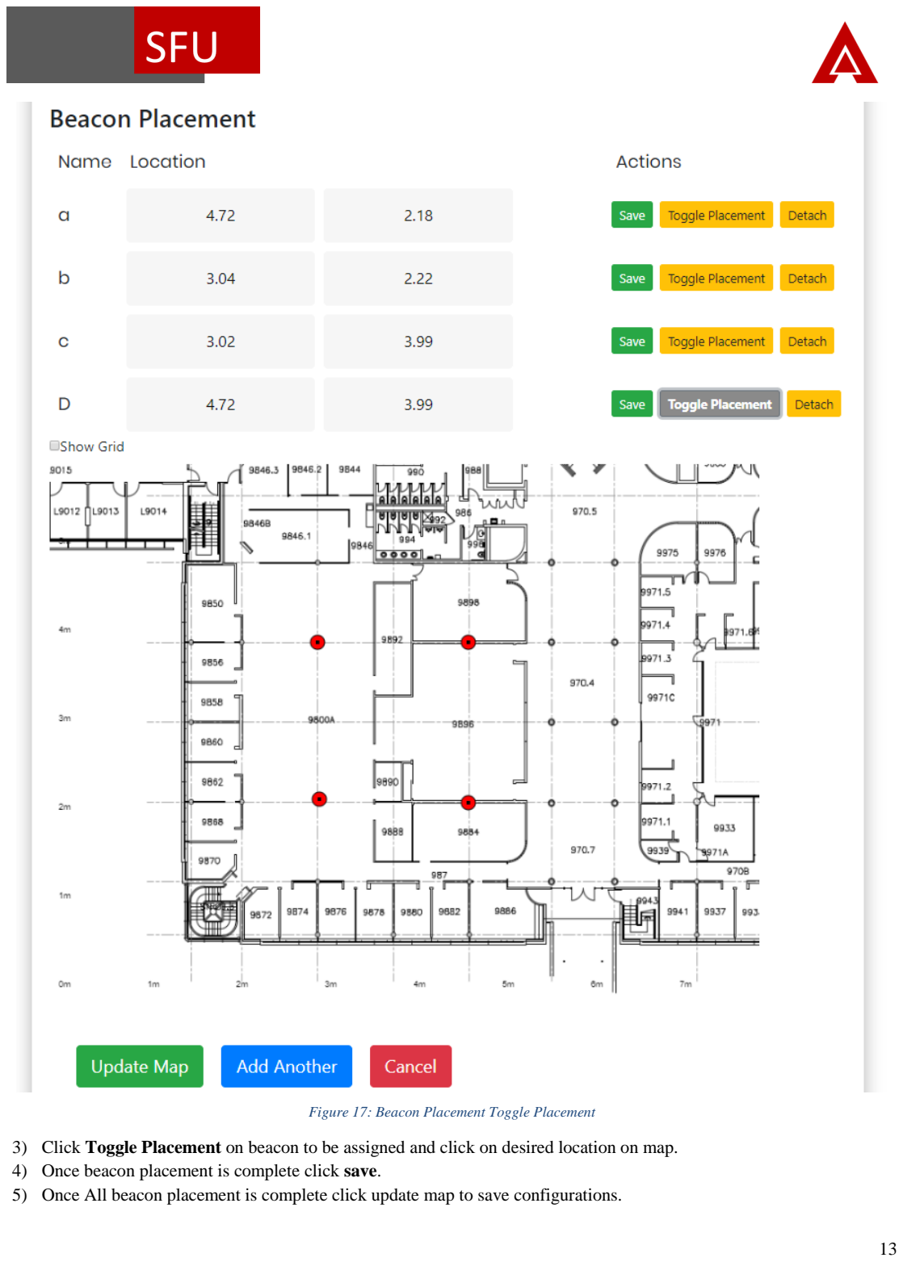
[picture p187: page 13]

Figure 17: Beacon Placement Toggle Placement

3) Click Toggle Placement on beacon to be assigned and click on desired location on map.
4) Once beacon placement is complete click save.
5) Once All beacon placement is complete click update map to save configurations.

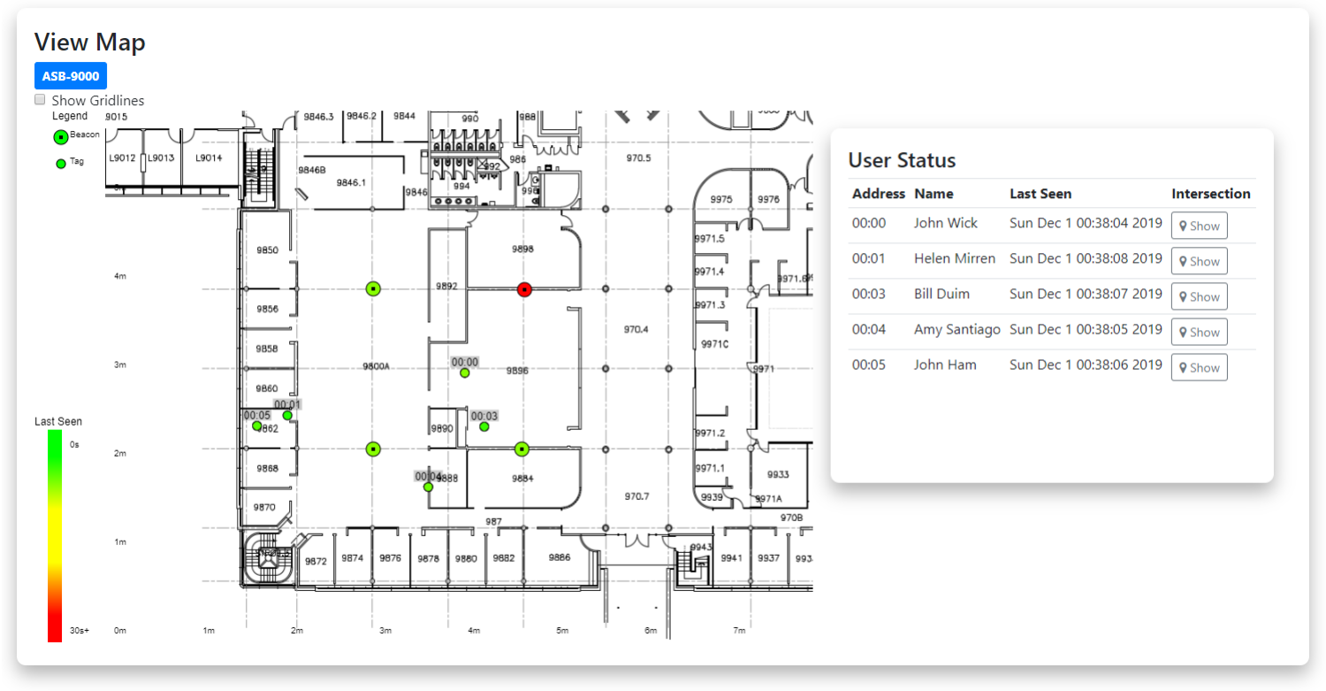
[picture p188: figure]

Figure 19: Updated Beacon Placement on Map

6) To view new beacon placement, go to Navigation Bar-> View Maps and click on the map that was updated.
7) Start Tracking to see new beacon placement locations
8) New beacon placement should be updated and shown.

### 3. Admin Commands

### 3.1 Beacon Commands

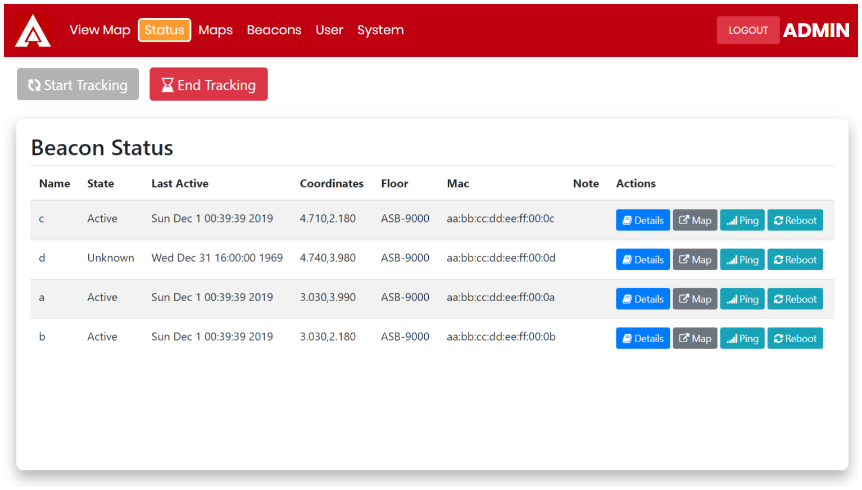
[picture p189: figure]

Figure 20: Beacon Status Page With Commands

1) To access Beacon Commands, go to either Beacon List or Beacon Status from Top Navigation Bar

Ping
2) Click Ping to send ping command to each beacon.

Reboot
3) Click Reboot to restart the Core MCU and Wi-Fi module of the Beacon. (This is a Hardware Reset)

### 3.2 Server Commands

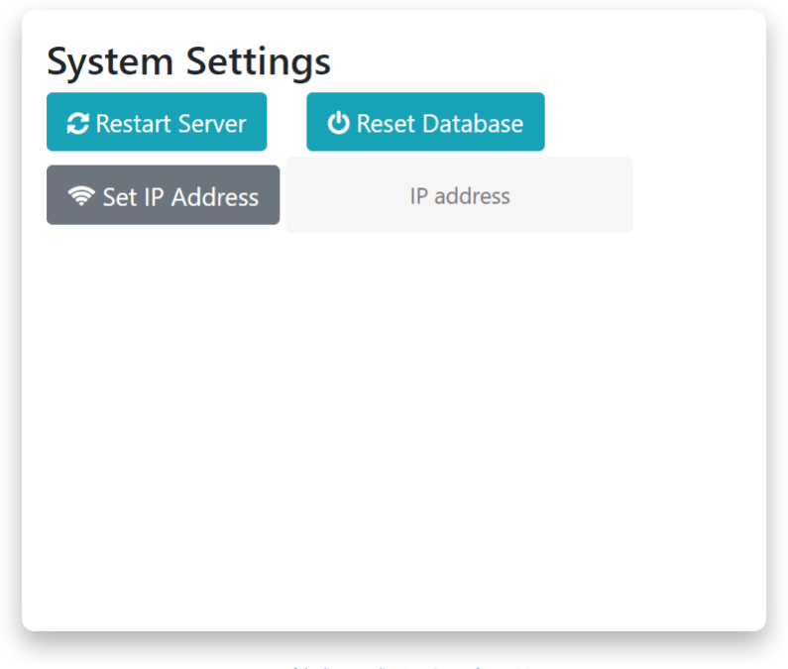
[picture p190: figure]

Figure 21: System Setting Dropdown Menu

1) To access Server Commands, go to System Settings from System dropdown menu

Restart Server

1) To restart the Akriveia Web Server, go to System Setting Click Restart Server.
2) This will restart the process for the Akriveia Web Server.
3) Refresh web page to load web server after restart.

Reset Database

1) To reset the Akriveia Web Server database, go to System Setting and click Reset Database button.
2) This will remove all data including maps, beacons, and users

Set Beacon Host IP

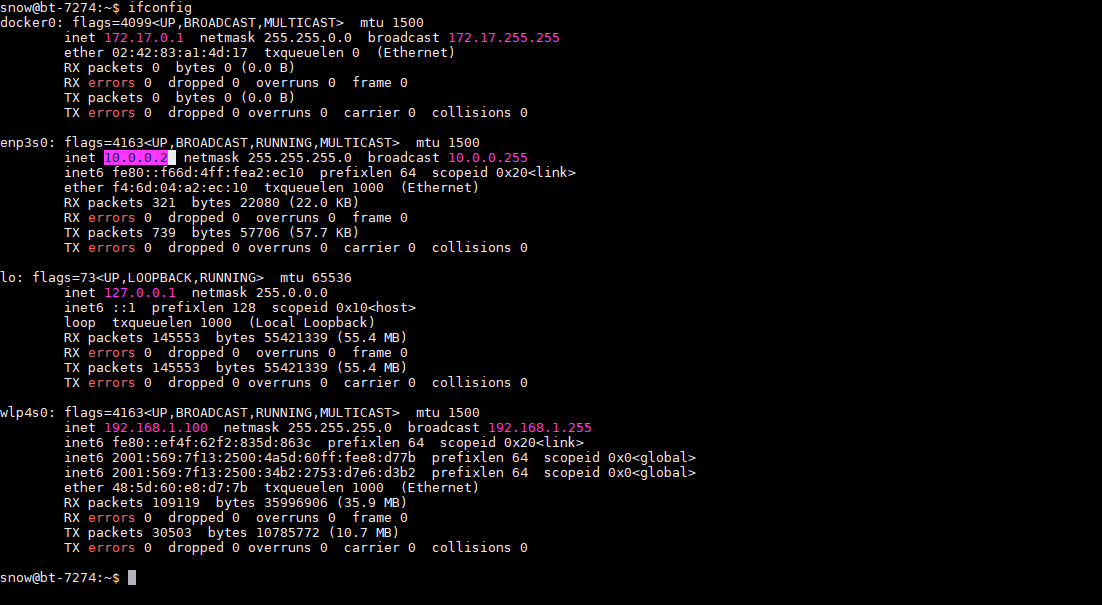
[picture p191: figure]

Figure 22: ifconfig Example

1) To set host IP for beacons enter local IP assigned by Akriveia AP
2) Local IP can be obtained by running ipconfig on Windows and ifconfig on Linux command terminal.
2) Enter local IP in IP address text field and click Set IP Address to send the set IP command to beacons.
3) Beacons should be sending data to new IP set
