liuyal/Akriveia/Firmware/ID_Tag_V1/ID_Tag_V1.ino

#include <DW1000Ng.hpp>
#include <DW1000NgUtils.hpp>
#include <DW1000NgTime.hpp>
#include <DW1000NgConstants.hpp>
#include <DW1000NgRanging.hpp>
#include <DW1000NgRTLS.hpp>

#if defined(ESP32)
const uint8_t PIN_SCK = 18;
const uint8_t PIN_MOSI = 23;
const uint8_t PIN_MISO = 19;
const uint8_t PIN_SS = 2;
const uint8_t PIN_RST = 15;
const uint8_t PIN_IRQ = 17;
#else
const uint8_t PIN_RST = 9; // reset pin
const uint8_t PIN_IRQ = 2; // irq pin
const uint8_t PIN_SS = SS; // spi select pin
#endif

volatile uint32_t blink_rate = 200;
char* EUI = "AA:BB:CC:DD:EE:FF:00:00";
uint16_t netID = 0;

device_configuration_t DEFAULT_CONFIG = {
    false,
    true,
    true,
    true,
    false,
    SFDMode::STANDARD_SFD,
    Channel::CHANNEL_5,
    DataRate::RATE_850KBPS,
    PulseFrequency::FREQ_64MHZ,
    PreambleLength::LEN_256,
    PreambleCode::CODE_3
};

frame_filtering_configuration_t TAG_FRAME_FILTER_CONFIG = {
    false,
    false,
    true,
    false,
    false,
    false,
    false,
    false
};

sleep_configuration_t SLEEP_CONFIG = {
    false,  // onWakeUpRunADC   reg 0x2C:00
    false,  // onWakeUpReceive
    false,  // onWakeUpLoadEUI
    true,   // onWakeUpLoadL64Param
    true,   // preserveSleep
    true,   // enableSLP    reg 0x2C:06
    false,  // enableWakePIN
    true    // enableWakeSPI
};

void setup() {
    // DEBUG monitoring
    Serial.begin(9600);
    Serial.println(F("### DW1000Ng-arduino-ranging-tag ###"));
    DW1000Ng::initializeNoInterrupt(PIN_SS, PIN_RST);
    Serial.println("DW1000Ng initialized ...");
    DW1000Ng::applyConfiguration(DEFAULT_CONFIG);
    DW1000Ng::enableFrameFiltering(TAG_FRAME_FILTER_CONFIG);
    DW1000Ng::setEUI(EUI);
    DW1000Ng::setDeviceAddress(netID);
    DW1000Ng::setNetworkId(RTLS_APP_ID);
    DW1000Ng::setAntennaDelay(16436);
    DW1000Ng::applySleepConfiguration(SLEEP_CONFIG);
    DW1000Ng::setPreambleDetectionTimeout(15);
    DW1000Ng::setSfdDetectionTimeout(273);
    DW1000Ng::setReceiveFrameWaitTimeoutPeriod(2000);

    Serial.println(F("Committed configuration ..."));
    char msg[128];
    DW1000Ng::getPrintableDeviceIdentifier(msg);
    Serial.print("Device ID: "); Serial.println(msg);
    DW1000Ng::getPrintableExtendedUniqueIdentifier(msg);
    Serial.print("Unique ID: "); Serial.println(msg);
    DW1000Ng::getPrintableNetworkIdAndShortAddress(msg);
    Serial.print("Network ID & Device Address: "); Serial.println(msg);
    DW1000Ng::getPrintableDeviceMode(msg);
    Serial.print("Device mode: "); Serial.println(msg);    
}

void loop() {
    DW1000Ng::deepSleep();
    delay(blink_rate);
    DW1000Ng::spiWakeup();
    DW1000Ng::setEUI(EUI);
    
    RangeInfrastructureResult res = DW1000NgRTLS::tagTwrLocalize(1500);
    if(res.success){  blink_rate = res.new_blink_rate;}
       
}
