liuyal/Akriveia/Server/frontend/src/canvas.rs

use common::*;
use stdweb::traits::*;
use na;
use stdweb::web::event::{ ClickEvent, };
use stdweb::web::html_element::{ CanvasElement, ImageElement, };
use stdweb::web::{ CanvasRenderingContext2d, FillRule, TextAlign, };
use yew::prelude::*;
use palette::{ Gradient, LinSrgb, };
use crate::util::WebUserType;

const USER_RADIUS: f64 = 5.0;
const BEACON_RADIUS: f64 = 8.0;
const MAX_TIME: f64 = 30000.0; // milliseconds

struct GradColor {
    grad: Gradient<LinSrgb<f64>>,
    colors: Vec<LinSrgb<f64>>,
}

lazy_static! {
    static ref GRAD_COLOR: GradColor = {
        let colors = vec![
            LinSrgb::new(0.0, 1.0, 0.0),
            LinSrgb::new(1.0, 1.0, 0.0),
            LinSrgb::new(1.0, 1.0, 0.0),
            LinSrgb::new(1.0, 0.0, 0.0),
        ];
        let grad = Gradient::new(colors.clone());

        GradColor { colors, grad }
    };
}


pub struct Canvas {
    pub canvas: CanvasElement,
    pub context: CanvasRenderingContext2d,
}

pub fn screen_space(map: &Map, x: f64, y: f64) -> na::Vector2<f64> {
    na::Vector2::new(x, map.bounds.y as f64 - y)
}

fn color_to_hex(c: &LinSrgb<f64>) -> String {
    let comps = c.into_components();
    let color_string = format!(
        "#{:0<2X}{:0<2X}{:0<2X}",
        (comps.0 * 255.0) as u8,
        (comps.1 * 255.0) as u8,
        (comps.2 * 255.0) as u8
    );
    color_string
}

impl Canvas {
    fn get_context(canvas: &CanvasElement) -> CanvasRenderingContext2d {
        unsafe {
            js! (
                return @{canvas}.getContext("2d");
            ).into_reference_unchecked().unwrap()
        }
    }

    fn make_canvas(id: &str) -> CanvasElement {
        let canvas: CanvasElement = unsafe {
            js! (
                let c = document.createElement("canvas");
                c.setAttribute("id", @{id});
                return c;
            ).into_reference_unchecked().unwrap()
        };
        canvas
    }

    pub fn new(id: &str, click_callback: Callback<ClickEvent>) -> Canvas {
        let canvas = Canvas::make_canvas(id);
        let context = Canvas::get_context(&canvas);
        canvas.add_event_listener(move |event| click_callback.emit(event));
        Canvas {
            canvas,
            context,
        }
    }

    pub fn legend(&self, width: u32, height: u32, user_type: WebUserType) {
        self.canvas.set_width(width);
        self.canvas.set_height(height);

        self.context.save();

        let legend_spacing = 30.0;
        let x_row_entry = 30.0;
        let x_row_text = 40.0;

        self.context.set_fill_style_color("#000");
        self.context.set_text_align(TextAlign::Left);
        self.context.set_font("10px sans-serif");

        let mut current_y = 0.0;

        // Beacon
        if user_type == WebUserType::Admin {
            current_y += legend_spacing;
            self.context.set_fill_style_color("#0F0");
            self.context.begin_path();
            self.context.arc(x_row_entry, current_y, BEACON_RADIUS, 0.0, std::f64::consts::PI * 2.0, true);
            self.context.fill(FillRule::NonZero);
            self.context.set_fill_style_color("#000");
            self.context.fill_rect(x_row_entry - BEACON_RADIUS / 4.0, current_y - BEACON_RADIUS / 4.0, BEACON_RADIUS / 2.0, BEACON_RADIUS / 2.0);
            self.context.begin_path();
            self.context.arc(x_row_entry, current_y, BEACON_RADIUS, 0.0, std::f64::consts::PI * 2.0, true);
            self.context.stroke();
            self.context.fill_text("Beacon", x_row_text, current_y, None);
        }

        // Tag
        current_y += legend_spacing;
        self.context.set_fill_style_color("#0F0");
        self.context.begin_path();
        self.context.arc(x_row_entry, current_y, USER_RADIUS, 0.0, std::f64::consts::PI * 2.0, true);
        self.context.fill(FillRule::NonZero);
        self.context.set_fill_style_color("#000000");
        self.context.begin_path();
        self.context.arc(x_row_entry, current_y, USER_RADIUS, 0.0, std::f64::consts::PI * 2.0, true);
        self.context.stroke();
        self.context.set_fill_style_color("#000");
        self.context.fill_text("Tag", x_row_text, current_y, None);

        // Title
        self.context.set_fill_style_color("#000");
        self.context.set_text_align(TextAlign::Center);
        self.context.set_font("12px sans-serif");
        self.context.fill_text("Legend", width as f64 / 2.0, 10.0, None);

        // Gradient
        let gradient_width = width as f64 * 0.2;
        current_y += height as f64 / 2.0; // start at the bottom half of the legend
        let gradient_x_offset = x_row_entry / 2.0;
        let grad = self.context.create_linear_gradient(gradient_x_offset, current_y, gradient_x_offset, height as f64);

        GRAD_COLOR.colors.iter().enumerate().for_each(|(i, color)| {
            grad.add_color_stop((i as f64 + 0.5) / GRAD_COLOR.colors.len() as f64, &color_to_hex(color)).unwrap();
        });
        self.context.set_fill_style_gradient(&grad);
        self.context.fill_rect(gradient_x_offset, current_y, gradient_width, height as f64 / 2.0);

        self.context.set_fill_style_color("#000");
        self.context.set_text_align(TextAlign::Left);
        self.context.set_font("12px sans-serif");
        self.context.fill_text("Last Seen", 0.0, current_y - 5.0, None);
        self.context.set_font("10px sans-serif");
        self.context.set_text_align(TextAlign::Left);
        self.context.fill_text("0s", x_row_text, current_y + 20.0, None);
        self.context.fill_text(&format!("{}s+", MAX_TIME / 1000.0), x_row_text, height as f64 - 10.0, None);

        self.context.restore();
    }

    pub fn reset(&mut self, map: &Map, img: &Option<ImageElement>, show_grid: bool) {
        self.canvas.set_width(map.bounds.x as u32);
        self.canvas.set_height(map.bounds.y as u32);

        self.context.set_line_dash(vec![]);
        self.context.clear_rect(
            0.0, 0.0,
            self.canvas.width().into(), self.canvas.height().into()
        );
        self.context.stroke_rect(
            0.0, 0.0,
            self.canvas.width().into(), self.canvas.height().into()
        );

        img.as_ref().and_then(|image| {
            if image.complete() && image.width() > 0 && image.height() > 0 {
                match self.context.draw_image_s(
                    image.clone(),
                    0.0, 0.0,
                    image.width() as f64, image.height() as f64,
                    0.0, 0.0,
                    map.bounds.x as f64, map.bounds.y as f64
                ) {
                    Ok(_) => {
                    },
                    Err(e) => {
                        Log!("failed to render map {}", e);
                    }
                }
            }
            Some(())
        });

        if show_grid {
            self.context.save();
            self.context.set_line_dash(vec![5.0, 15.0]);
            // vertical gridlines
            for i in (map.scale as u32..map.bounds.x as u32).step_by(map.scale as usize) {
                let pos0 = screen_space(&map, i as f64, map.bounds.y as f64);
                let pos1 = screen_space(&map, i as f64, 0.0);
                self.context.begin_path();
                self.context.move_to(pos0.x, pos0.y);
                self.context.line_to(pos1.x, pos1.y);
                self.context.stroke();
            }
            // horizontal gridlines
            for i in (map.scale as u32..map.bounds.y as u32).step_by(map.scale as usize) {
                let pos0 = screen_space(&map, map.bounds.x as f64, i as f64);
                let pos1 = screen_space(&map, 0.0, i as f64);
                self.context.begin_path();
                self.context.move_to(pos0.x, pos0.y);
                self.context.line_to(pos1.x, pos1.y);
                self.context.stroke();
            }
            self.context.restore();
        }

        let text_adjustment = 10.0;
        // x axis
        for i in 0..(map.bounds.x as u32 / map.scale as u32) {
            let pos = screen_space(&map, i as f64 * map.scale + text_adjustment, text_adjustment);
            self.context.fill_text(&format!("{}m", i), pos.x, pos.y, None);
        }
        // y axis
        // skip 0 because it was rendered by the y axis.
        for i in 1..(map.bounds.y as u32 / map.scale as u32) {
            let pos = screen_space(&map, text_adjustment, i as f64 * map.scale + text_adjustment);
            self.context.fill_text(&format!("{}m", i), pos.x, pos.y, None);
        }
    }

    pub fn draw_beacons(&mut self, map: &Map, beacons: &Vec<&Beacon>) {
        self.context.save();
        for beacon in beacons {
            let beacon_loc = screen_space(
                &map,
                beacon.coordinates.x * map.scale,
                beacon.coordinates.y * map.scale,
            );

            let diff = stdweb::web::Date::now() - beacon.last_active.timestamp_millis() as f64;
            let freshness = GRAD_COLOR.grad.get(num::clamp(diff / MAX_TIME, 0.0, 1.0));
            self.context.set_fill_style_color(&color_to_hex(&freshness));
            self.context.begin_path();
            self.context.arc(beacon_loc.x, beacon_loc.y, BEACON_RADIUS, 0.0, std::f64::consts::PI * 2.0, true);
            self.context.fill(FillRule::NonZero);
            self.context.set_fill_style_color("#000");
            self.context.fill_rect(beacon_loc.x - BEACON_RADIUS / 4.0, beacon_loc.y - BEACON_RADIUS / 4.0, BEACON_RADIUS / 2.0, BEACON_RADIUS / 2.0);
            self.context.begin_path();
            self.context.arc(beacon_loc.x, beacon_loc.y, BEACON_RADIUS, 0.0, std::f64::consts::PI * 2.0, true);
            self.context.stroke();
        }
        self.context.restore();
    }

    pub fn draw_users(&mut self, map: &Map, users: &Vec<RealtimeUserData>, show_distance: Option<ShortAddress>) {
        self.context.save();
        for user in users.iter() {
            let user_pos = screen_space(
                map,
                user.coordinates.x as f64 * map.scale,
                user.coordinates.y as f64 * map.scale,
            );

            let diff = stdweb::web::Date::now() - user.last_active.timestamp_millis() as f64;
            let freshness = GRAD_COLOR.grad.get(num::clamp(diff / MAX_TIME, 0.0, 1.0));
            let color_string = color_to_hex(&freshness);

            // draw the user icon
            self.context.set_fill_style_color(&color_string);
            self.context.begin_path();
            self.context.arc(user_pos.x, user_pos.y, USER_RADIUS, 0.0, std::f64::consts::PI * 2.0, true);
            self.context.fill(FillRule::NonZero);
            self.context.set_fill_style_color("#000000");
            self.context.begin_path();
            self.context.arc(user_pos.x, user_pos.y, USER_RADIUS, 0.0, std::f64::consts::PI * 2.0, true);
            self.context.stroke();
            self.context.set_text_align(TextAlign::Center);

            // draw the user address ontop of the icon
            let user_id = user.addr.to_string();
            let text_metrics = self.context.measure_text(&user_id);
            match text_metrics {
                Ok(m) => {
                    self.context.save();
                    let mut name_pos = user_pos.clone();
                    name_pos.y -= USER_RADIUS + 3.0; // offset the text upwards from the location
                    self.context.set_fill_style_color("#00000033");
                    let text_back_height = 13.0;
                    let text_back_offset = 11.0;
                    let text_back_width = m.get_width() + 8.0;
                    self.context.fill_rect(
                        name_pos.x - text_back_width / 2.0,
                        name_pos.y - text_back_offset,
                        text_back_width,
                        text_back_height
                    );

                    self.context.set_fill_style_color("#000000");
                    self.context.set_font("12px sans-serif");
                    self.context.fill_text(&user_id, name_pos.x, name_pos.y, None);
                    self.context.restore();
                },
                Err(e) => {
                    Log!("failed to obtain text metrics: {}", e);
                },
            }

            for beacon_source in &user.beacon_tofs {
                let beacon_loc = screen_space(
                    map,
                    beacon_source.location.x * map.scale,
                    beacon_source.location.y * map.scale,
                );
                match &show_distance {
                    Some(tag_mac) if &user.addr == tag_mac => {
                        self.context.set_fill_style_color("#00000034");
                        self.context.begin_path();
                        self.context.arc(beacon_loc.x, beacon_loc.y, beacon_source.distance_to_tag * map.scale, 0.0, std::f64::consts::PI * 2.0, true);
                        self.context.fill(FillRule::NonZero);
                    },
                    _ => { },
                }
            }
        }
        self.context.restore();
    }
}
