liuyal/Akriveia/Firmware/Test_code/DWM1000/BasicConnectivityTest-ng/BasicConnectivityTest-ng.ino

/*
 * MIT License
 * 
 * Copyright (c) 2018 Michele Biondi, Andrea Salvatori
 * 
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
 * THE SOFTWARE IS PROVIDED "AS IS", WITHOUT WARRANTY OF ANY KIND, EXPRESS OR
 * IMPLIED, INCLUDING BUT NOT LIMITED TO THE WARRANTIES OF MERCHANTABILITY,
 * FITNESS FOR A PARTICULAR PURPOSE AND NONINFRINGEMENT. IN NO EVENT SHALL THE
 * AUTHORS OR COPYRIGHT HOLDERS BE LIABLE FOR ANY CLAIM, DAMAGES OR OTHER
 * LIABILITY, WHETHER IN AN ACTION OF CONTRACT, TORT OR OTHERWISE, ARISING FROM,
 * OUT OF OR IN CONNECTION WITH THE SOFTWARE OR THE USE OR OTHER DEALINGS IN THE
 * SOFTWARE.
*/

/*
 * Copyright (c) 2015 by Thomas Trojer <thomas@trojer.net>
 * Decawave DW1000 library for arduino.
 *
 * Licensed under the Apache License, Version 2.0 (the "License");
 * you may not use this file except in compliance with the License.
 * You may obtain a copy of the License at
 *
 *     http://www.apache.org/licenses/LICENSE-2.0
 *
 * Unless required by applicable law or agreed to in writing, software
 * distributed under the License is distributed on an "AS IS" BASIS,
 * WITHOUT WARRANTIES OR CONDITIONS OF ANY KIND, either express or implied.
 * See the License for the specific language governing permissions and
 * limitations under the License.
 *
 * @file BasicConnectivityTest.ino
 * Use this to test connectivity with your DW1000Ng from Arduino.
 * It performs an arbitrary setup of the chip and prints some information.
 * 
 * @todo
 *  - move strings to flash (less RAM consumption)
 *  - make real check of connection (e.g. change some values on DW1000Ng and verify)
 */

#include <SPI.h>
#include <DW1000Ng.hpp>

// connection pins
#if defined(ESP32)
const uint8_t PIN_SCK = 18;
const uint8_t PIN_MOSI = 23;
const uint8_t PIN_MISO = 19;
const uint8_t PIN_SS = 2;
const uint8_t PIN_RST = 15;
const uint8_t PIN_IRQ = 17;
#else
const uint8_t PIN_RST = 9; // reset pin
const uint8_t PIN_IRQ = 2; // irq pin
const uint8_t PIN_SS = SS; // spi select pin
#endif


void setup() {
  // DEBUG monitoring
  Serial.begin(9600);
  // initialize the driver
  DW1000Ng::initialize(PIN_SS, PIN_IRQ, PIN_RST);
  Serial.println(F("DW1000Ng initialized ..."));
  // general configuration
  DW1000Ng::setDeviceAddress(5);
  DW1000Ng::setNetworkId(10);
  Serial.println(F("Committed configuration ..."));
  // wait a bit
  delay(1000);
}

void loop() {
  // DEBUG chip info and registers pretty printed
  char msg[128];
  DW1000Ng::getPrintableDeviceIdentifier(msg);
  Serial.print("Device ID: "); Serial.println(msg);
  DW1000Ng::getPrintableExtendedUniqueIdentifier(msg);
  Serial.print("Unique ID: "); Serial.println(msg);
  DW1000Ng::getPrintableNetworkIdAndShortAddress(msg);
  Serial.print("Network ID & Device Address: "); Serial.println(msg);
  DW1000Ng::getPrintableDeviceMode(msg);
  Serial.print("Device mode: "); Serial.println(msg);
  // wait a bit
  delay(10000);
}
