liuyal/Akriveia/Firmware/Test_code/MISC/beacon_usb_serial_ignition/beacon_usb_serial_ignition.ino

bool system_on = false;
String input = "";

// responses
const String ack = "ack";
const String nak = "nak";

// commands
const String command_start = "start";
const String command_end = "end";

int counter = 0;

void setup() {
  Serial.begin(115200);
}

void loop() {

  if (Serial.available()>0) {

    input = Serial.readString();

    if (input.indexOf(command_start)>=0){
      Serial.println(ack);
      system_on = true;
    }
    else if (input.indexOf(command_end)>=0){
      Serial.println(ack);
      system_on = false;
    } else {
	  Serial.println(nak);
    }
  }

  if (system_on==true){
  	String data = String("hello_world|mac123|") + String(counter);
    Serial.println(data);
	counter++;
  }

  delay(500);
}
