liuyal/Akriveia/Firmware/Test_code/MISC/esp32_sleep_test/esp32_sleep_test.ino

#define uS_TO_S_FACTOR 100000
#define TIME_TO_SLEEP  5

RTC_DATA_ATTR int bootCount = 0;

void setup(){
  Serial.begin(115200);
  delay(1000);
  ++bootCount;
  Serial.println("Boot number: " + String(bootCount));
  print_wakeup_reason();
  esp_sleep_enable_timer_wakeup(TIME_TO_SLEEP * uS_TO_S_FACTOR);
  Serial.println("Setup ESP32 to sleep for every " + String(TIME_TO_SLEEP) + " Seconds");
  esp_deep_sleep_start();
}

void loop(){}

void print_wakeup_reason(){
  esp_sleep_wakeup_cause_t wakeup_reason;
  wakeup_reason = esp_sleep_get_wakeup_cause();
  switch(wakeup_reason)
  {
    case 1  : Serial.println("Wakeup caused by external signal using RTC_IO"); break;
    case 2  : Serial.println("Wakeup caused by external signal using RTC_CNTL"); break;
    case 3  : Serial.println("Wakeup caused by timer"); break;
    case 4  : Serial.println("Wakeup caused by touchpad"); break;
    case 5  : Serial.println("Wakeup caused by ULP program"); break;
    default : Serial.println("Wakeup was not caused by deep sleep"); break;
  }
}
