liuyal/Akriveia/Server/backend/src/db_utils.rs

use tokio_postgres::NoTls;
use common::LoginInfo;
use futures::{ future::err, Future, future::Either, };
use crate::AKData;
use actix_identity::Identity;
use crate::ak_error::AkError;

pub const DEFAULT_CONNECTION: &str = "dbname=ak host=localhost password=postgres user=postgres";

pub fn default_connect() -> impl Future<Item=tokio_postgres::Client, Error=AkError> {
    connect(DEFAULT_CONNECTION)
}

pub fn connect_login(user: &LoginInfo) -> impl Future<Item=tokio_postgres::Client, Error=AkError> {
    connect(&format!("dbname=ak host=localhost user={} password={}", user.name, user.pw))
}

pub fn connect(params: &str) -> impl Future<Item=tokio_postgres::Client, Error=AkError> {
    tokio_postgres::connect(params, NoTls)
        .map(|(client, connection)| {
            let connection = connection.map_err(|e| eprintln!("connect db error: {}", e));
            tokio::spawn(connection);
            client
        })
        .map_err(AkError::from)
}

pub fn connect_id(id: &Identity, state: &AKData) -> impl Future<Item=tokio_postgres::Client, Error=AkError> {
    let conn_fut = if let Some(name) = id.identity() {
        let s = state.lock().unwrap();
        if let Some(info) = s.pools.get(&name) {
            Either::A(connect_login(info)
                .map_err(AkError::from)
            )
        } else {
            Either::B(err(AkError::internal()))
        }
    } else {
        Either::B(err(AkError::unauthorized()))
    };

    conn_fut
}
