liuyal/Akriveia/(commit log)

2019-06-21 working on the framework section
2019-06-25 power management paragraph started
2019-07-16 added para for scott
2019-10-16 added prototype refinment template
2019-11-12 added images
    [BOM.xlsx]
2019-11-12 remove BOM
    [BOM.xlsx]
